ageppert/Core-64-Interactive-Core-Memory-Badge/Electronic Design/Core64 LB v0.9 KiCAD 8 WIP/Core64 LB.kicad_pcb

## KiCad design Electronic Design/Core64 LB v0.9 KiCAD 8 WIP/Core64 LB.kicad_pcb (2025-10-01)

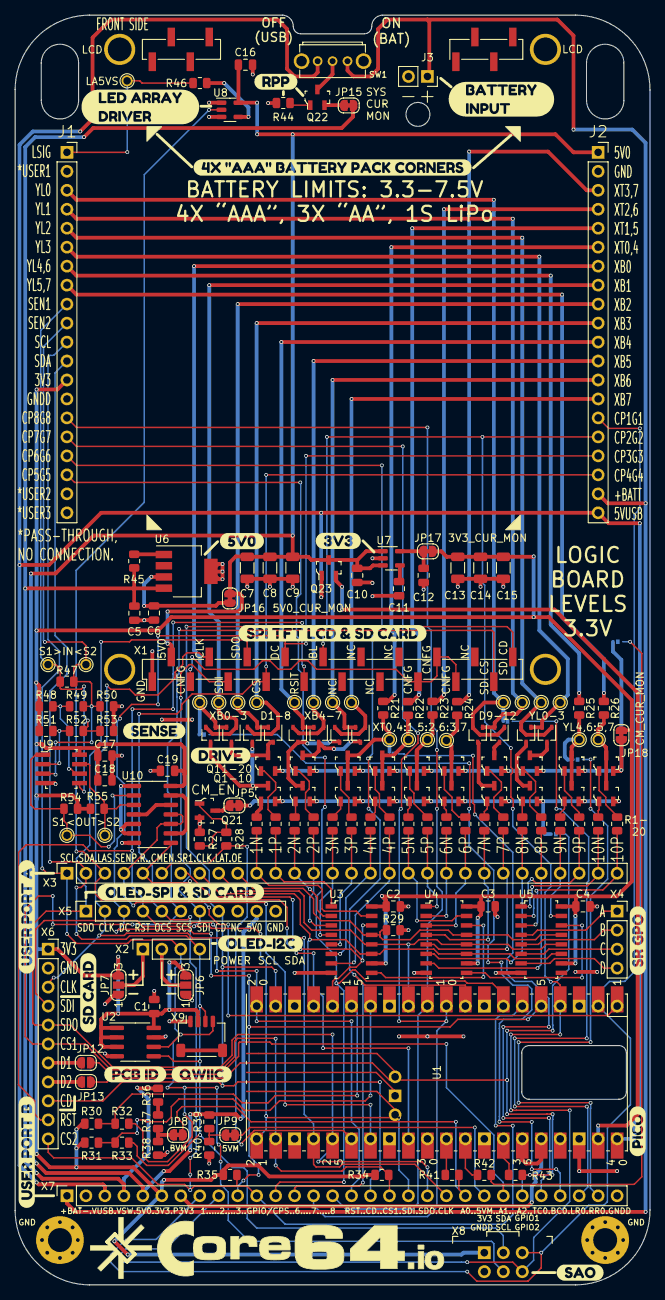
[picture p1: board Core64 LB.kicad_pcb from above]

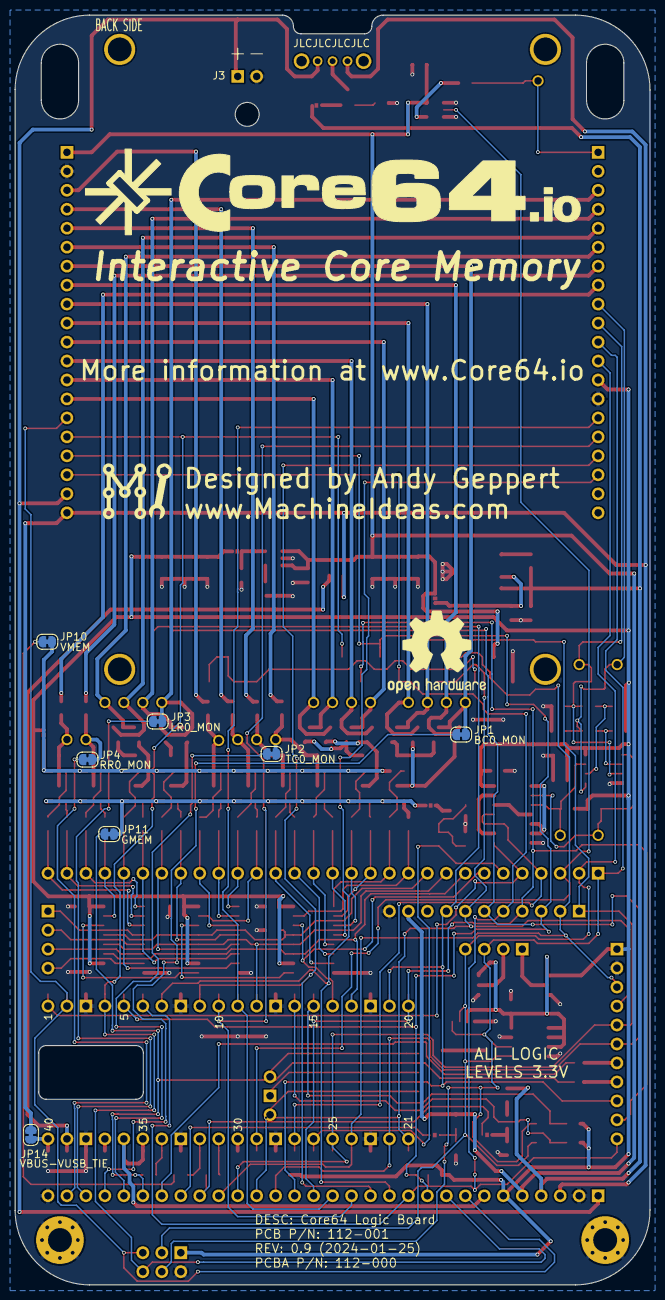
[picture p2: board Core64 LB.kicad_pcb from below]

Board: 2 copper layers, 85.0 x 170.0 mm, 198 parts (10 on the bottom side), 154 nets.

Parts:
C1, C2, C3, C4, C16, C17, C19: 0.1uF; C_0805_2012Metric
C5, C6, C10, C12: 1uF; C_0805_2012Metric
C7, C8, C9, C13, C14, C15: 220uF; C_1206_3216Metric
C11: 0.01uF; C_0805_2012Metric
C18: 10uF; C_0805_2012Metric
D1, D3, D5, D7, D9, D11: BAT54CW; SOT-323_SC-70
D2, D4, D6, D8, D10, D12: BAT54AW; SOT-323_SC-70
H1, H2: GND PAD; MountingHole_3.2mm_M3_Pad_Via
J1, J2: SSW-116-22-F-S-VS‎; PinSocket_1x20_P2.54mm_Vertical
J3: ALT. BATT.; PinSocket_1x02_P2.54mm_Vertical
JP1: BC0_MON; SolderJumper-2_P1.3mm_Bridged_RoundedPad1.0x1.5mm
JP2: TC0_MON; SolderJumper-2_P1.3mm_Bridged_RoundedPad1.0x1.5mm
JP3: LR0_MON; SolderJumper-2_P1.3mm_Bridged_RoundedPad1.0x1.5mm
JP4: RR0_MON; SolderJumper-2_P1.3mm_Bridged_RoundedPad1.0x1.5mm
JP5, JP11: GMEM; SolderJumper-2_P1.3mm_Bridged_RoundedPad1.0x1.5mm
JP6, JP7: SolderJumper_3_Open; SolderJumper-3_P1.3mm_Open_RoundedPad1.0x1.5mm_NumberLabels
JP8: BAT_MON; SolderJumper-2_P1.3mm_Bridged_RoundedPad1.0x1.5mm
JP9: 5V0_MON; SolderJumper-2_P1.3mm_Bridged_RoundedPad1.0x1.5mm
JP10: VMEM; SolderJumper-2_P1.3mm_Bridged_RoundedPad1.0x1.5mm
JP12: D1; SolderJumper-2_P1.3mm_Open_RoundedPad1.0x1.5mm
JP13: D2; SolderJumper-2_P1.3mm_Open_RoundedPad1.0x1.5mm
JP14: VBUS_VUSB_TIE; SolderJumper-2_P1.3mm_Bridged_RoundedPad1.0x1.5mm
JP15: SYS_CUR_MON; SolderJumper-2_P1.3mm_Bridged_RoundedPad1.0x1.5mm
JP16: 5V0_CUR_MON; SolderJumper-2_P1.3mm_Bridged_RoundedPad1.0x1.5mm
JP17: 3V3_CUR_MON; SolderJumper-2_P1.3mm_Bridged_RoundedPad1.0x1.5mm
JP18: CM_CUR_MON; SolderJumper-2_P1.3mm_Bridged_RoundedPad1.0x1.5mm
L1: Core_64_Logo; Core64.io_w_core_symbol
L1#2: Core_64_Logo; Machine_Ideas_logo_1
L2: Core_64_Logo; Core64.io_w_core_symbol2
L4: Logo_Open_Hardware_Small; OSHW-Logo2_14.6x12mm_SilkScreen
Q1, Q2, Q3, Q4, Q5, Q6, Q7, Q8, Q9, Q10: MMBT4401LT1G; SOT-23-3
Q11, Q12, Q13, Q14, Q15, Q16, Q17, Q18, Q19, Q20: MMBT4403LT1G; SOT-23-3
Q21: NVTR4503NT1G_NMOS_GSD; SOT-23-3
Q22, Q23: SL3401A; SOT-23-3
R1, R2, R3, R4, R5, R6, R7, R8, R9, R10, R11, R12, R13, R14, R15, R16, R17, R18, R19, R20, R28, R46: 470; R_0805_2012Metric
R21, R22, R23, R24, R25, R26: 6R8-5%; R_0805_2012Metric
R27, R29, R34, R35, R36, R37, R38, R39, R40, R44, R45: 10k; R_0805_2012Metric
R30, R31, R54, R55: 1K2; R_0805_2012Metric
R32, R33: 68; R_0805_2012Metric
R41, R42, R43: 1k2; R_0805_2012Metric
R47, R50, R53: 1K5-1%; R_0805_2012Metric
R48, R51: 1K8-1%; R_0805_2012Metric
R49, R52: 11-1%; R_0805_2012Metric
SW1: SK12D07L4B; SK12D07VG4
TP1: XB0; TestPoint_THTPad_D1.5mm_Drill1.0mm
TP2: XB1; TestPoint_THTPad_D1.5mm_Drill1.0mm
TP3: XB2; TestPoint_THTPad_D1.5mm_Drill1.0mm
TP4: XB3; TestPoint_THTPad_D1.5mm_Drill1.0mm
TP5: XB4; TestPoint_THTPad_D1.5mm_Drill1.0mm
TP6: XB5; TestPoint_THTPad_D1.5mm_Drill1.0mm
TP7: XB6; TestPoint_THTPad_D1.5mm_Drill1.0mm
TP8: XB7; TestPoint_THTPad_D1.5mm_Drill1.0mm
TP9: XT0,4; TestPoint_THTPad_D1.5mm_Drill1.0mm
TP10: XT1,5; TestPoint_THTPad_D1.5mm_Drill1.0mm
TP11: XT2,6; TestPoint_THTPad_D1.5mm_Drill1.0mm
TP12: XT3,7; TestPoint_THTPad_D1.5mm_Drill1.0mm
TP13: YL1; TestPoint_THTPad_D1.5mm_Drill1.0mm
TP14: YL0; TestPoint_THTPad_D1.5mm_Drill1.0mm
TP15: YL3; TestPoint_THTPad_D1.5mm_Drill1.0mm
TP16: YL2; TestPoint_THTPad_D1.5mm_Drill1.0mm
TP17: YL4,6; TestPoint_THTPad_D1.5mm_Drill1.0mm
TP18: YL5,7; TestPoint_THTPad_D1.5mm_Drill1.0mm
TP19: LA5VS; TestPoint_THTPad_D1.5mm_Drill1.0mm
TP20: S1 IN; TestPoint_THTPad_D1.5mm_Drill1.0mm
TP21: S2 IN; TestPoint_THTPad_D1.5mm_Drill1.0mm
TP22: S2 OUT; TestPoint_THTPad_D1.5mm_Drill1.0mm
TP23: S1 OUT; TestPoint_THTPad_D1.5mm_Drill1.0mm
U1: PICO; RPi_PicoW_SMD_TH_Abg
U2: M24C02-RMN; SOIC-8_3.9x4.9mm_P1.27mm
U3, U4, U5: 74HC595D; SOIC-16_W3.90mm
U6: LP38693MP-5.0; SOT-223-5
U7: SSP9193-33M5R; SOT-23-5
U8: SN74LV1T125DBVR; SOT-23-5
U9: LM393; SOIC-8_W3.9mm
U10: SN74HC02DR; SOIC-14_3.9x8.7mm_P1.27mm
X1: Adafruit_3.2_TFT_1743; Adafruit_3.2_TFT_Dual_PinHeader_1x20_P2.54mm_Vertical_SMD_P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
X2: SSW-104-22-L-S-VS; PinSocket_1x04_P2.54mm_Vertical
X3, X7: TBD; PinSocket_1x30_P2.54mm_Vertical
X4: CA_SR_GPO_ABCD; PinSocket_1x04_P2.54mm_Vertical
X5: HEADER_11-PIN_0.1; PinSocket_1x11_P2.54mm_Vertical
X6: Header_11-PIN_0.1; PinSocket_1x11_P2.54mm_Vertical
X8: SAO_conn_SFH11-NBPC-D03-ST-BK; Badgelife-SAOv169-BADGE-2x3
X9: QWIIC; JST_SH_SM04B-SRSS-TB_1x04-1MP_P1.00mm_Horizontal
kibuzzard-6417AF30: G***; kibuzzard-6417AF30
kibuzzard-6417CDFD: G***; kibuzzard-6417CDFD
kibuzzard-6417CE14: G***; kibuzzard-6417CE14
kibuzzard-64178C85: G***; kibuzzard-64178C85
kibuzzard-64178DD4: G***; kibuzzard-64178DD4
kibuzzard-64178DE8: G***; kibuzzard-64178DE8
kibuzzard-64178DF4: G***; kibuzzard-64178DF4
kibuzzard-64178E2E: G***; kibuzzard-64178E2E
kibuzzard-64178E4F: G***; kibuzzard-64178E4F
kibuzzard-64178E7C: G***; kibuzzard-64178E7C
kibuzzard-64178E9B: G***; kibuzzard-64178E9B
kibuzzard-64178E12: G***; kibuzzard-64178E12
kibuzzard-64178E45: G***; kibuzzard-64178E45
kibuzzard-64178E73: G***; kibuzzard-64178E73
kibuzzard-64178E92: G***; kibuzzard-64178E92
kibuzzard-64178EA5: G***; kibuzzard-64178EA5
kibuzzard-64179D69: G***; kibuzzard-64179D69
kibuzzard-64179D78: G***; kibuzzard-64179D78
kibuzzard-64179E5D: G***; kibuzzard-64179E5D

Connections:
3V3: C1.1, C2.1, C3.1, C4.1, C13.1, C14.1, C15.1, C17.1, C18.1, C19.1, J1.13, JP6.3 (B), JP7.3 (B), JP17.2 (B), JP18.1 (A), R30.1, R31.1, R34.1, R35.2, R48.1, R51.1, R54.1, R55.1, U2.1 (E0), U2.2 (E1), U2.3 (E2), U2.8 (VCC), U3.10 (~SRCLR), U3.16 (VCC), U4.10 (~SRCLR), U4.16 (VCC), U5.10 (~SRCLR), U5.16 (VCC), U9.8 (V+), U10.14 (VCC), X6.1, X7.6, X8.1 (3V3), X9.2
5V0: C7.1, C8.1, C9.1, C10.1, C16.1, J2.1, JP16.2 (B), Q23.3 (D), R39.1, U7.1 (IN), U7.3 (EN), U8.5 (VCC), X1.2 (3-5V), X5.10, X7.5
5VUSB: J2.20, JP14.2 (B), Q23.1 (G), SW1.3 (C), X7.3
+BATT: J2.19, J3.1, SW1.1 (A), X7.1
+VSW: C5.1, JP15.2 (B), R36.2, R45.1, U6.4 (IN), X7.4
-BATT: C1.2, C2.2, C3.2, C4.2, C5.2, C6.2, C7.2, C8.2, C9.2, C10.2, C11.2, C12.2, C13.2, C14.2, C15.2, C16.2, C17.2, C18.2, C19.2, H1.1, H2.1, J1.14, J2.2, J3.2, JP6.1 (A), JP7.1 (A), Q21.2 (S), R27.1, R29.1, R38.2, R40.2, R44.2, R50.2, R53.2, U1.3 (GND), U1.8 (GND), U1.13 (GND), U1.18 (GND), U1.23 (GND), U1.28 (GND), U1.33 (AGND/GND), U1.38 (GND), U2.4 (VSS), U2.7 (~WC), U3.8 (GND), U4.8 (GND), U5.8 (GND), U6.5 (GND), U7.2 (GND), U8.1 (/OE), U8.3 (GND), U9.4 (V-), U10.7 (GND), X1.1 (GND), X5.11, X6.2, X7.2, X7.30, X8.2 (GND), X9.1
/ADC0: R41.1, U1.31 (I2C1_SDA/ADC0/GP26)
/ADC0_BUFF: JP8.2 (B), R41.2, X7.22
/ADC1: R42.1, U1.32 (I2C1_SCL/ADC1/GP27)
/ADC1_BUFF: JP10.1 (A), JP12.2 (B), R42.2, X7.24
/ADC2: R43.1, U1.34 (ADC2/GP28)
/ADC2_BUFF: JP11.1 (A), JP13.2 (B), R43.2, X7.25
/CA_SENSE_1_OUT: R55.2, TP23.1, U9.7, U10.3
/CA_SENSE_2_OUT: R54.2, TP22.1, U9.1, U10.2
/CA_SR_GPO_A: U5.4 (QE), X4.1
/CA_SR_GPO_B: U5.5 (QF), X4.2
/CA_SR_GPO_C: U5.6 (QG), X4.3
/CA_SR_GPO_D: U5.7 (QH), X4.4
/CA_SR_SER2: U3.9 (QH'), U4.14 (SER)
/CA_SR_SER3: U4.9 (QH'), U5.14 (SER)
/CM_EN: R28.1, U1.26 (I2C0_SDA/GP20), X3.6
/CM_Q1N: R1.2, U3.15 (QA), X3.11
/CM_Q1P: R2.2, U3.1 (QB), X3.12
/CM_Q2N: R3.2, U3.2 (QC), X3.13
/CM_Q2P: R4.2, U3.3 (QD), X3.14
/CM_Q3N: R5.2, U3.4 (QE), X3.15
/CM_Q3P: R6.2, U3.5 (QF), X3.16
/CM_Q4N: R7.2, U3.6 (QG), X3.17
/CM_Q4P: R8.2, U3.7 (QH), X3.18
/CM_Q5N: R9.2, U4.15 (QA), X3.19
/CM_Q5P: R10.2, U4.1 (QB), X3.20
/CM_Q6N: R11.2, U4.2 (QC), X3.21
/CM_Q6P: R12.2, U4.3 (QD), X3.22
/CM_Q7N: R13.2, U4.4 (QE), X3.23
/CM_Q7P: R14.2, U4.5 (QF), X3.24
/CM_Q8N: R15.2, U4.6 (QG), X3.25
/CM_Q8P: R16.2, U4.7 (QH), X3.26
/CM_Q9N: R17.2, U5.15 (QA), X3.27
/CM_Q9P: R18.2, U5.1 (QB), X3.28
/CM_Q10N: R19.2, U5.2 (QC), X3.29
/CM_Q10P: R20.2, U5.3 (QD), X3.30
/CM_SENSE_1_IN: J1.9, R47.1, R52.2, R53.1, TP20.1, U9.5 (+)
/CM_SENSE_2_IN: J1.10, R47.2, R49.2, R50.1, TP21.1, U9.3 (+)
/CM_SENSE_PULSE: U1.27 (I2C0_SCL/GP21), U10.10, U10.11, X3.4
/CM_SENSE_RESET: U1.1 (UART0_TX/I2C0_SDA/SPI0_RX/GP0), U10.8, X3.5
/CM_SR_CLK: U1.17 (UART0_RX/I2C0_SCL/SPI1_CSn/GP13), U3.11 (SRCLK), U4.11 (SRCLK), U5.11 (SRCLK), X3.8
/CM_SR_LAT: U1.12 (UART1_RX/I2C0_SCL/SPI1_CSn/GP9), U3.12 (RCLK), U4.12 (RCLK), U5.12 (RCLK), X3.9
/CM_SR_SER1: U1.16 (UART0_TX/I2C0_SDA/GPI1_RX/GP12), U3.14 (SER), X3.7
/CM_SR_~OE: R29.2, U3.13 (~OE), U4.13 (~OE), U5.13 (~OE), X3.10
/GPIO1_CP1_SAO1: J2.15, U1.2 (UART0_RX/I2C0_SCL/GPI0_CSn/GP1), X7.8, X8.5 (GPIO1)
/GPIO2_CP2_SAO2: J2.16, U1.4 (I2C1_SDA/SPI0_SCK/GP2), X1.10 (LITE), X7.9, X8.6 (GPIO2)
/GPIO3_CP3_DC: J2.17, U1.5 (I2C1_SCL/SPI0_TX/GP3), X1.8 (D/C), X5.3, X7.10
/GPIO4_CP4_CS2: J2.18, R35.1, U1.6 (UART1_TX/I2C0_SDA/SPI0_RX/GP4), X1.7 (CS), X5.5, X6.11, X7.11
/GPIO5_CP5_HS1: J1.18, U1.7 (UART1_RX/I2C0_SCL/SPI0_CSn/GP5), X7.12
/GPIO6_CP6_HS2: J1.17, U1.9 (I2C1_SDA/SPI0_SCK/GP6), X7.13
/GPIO7_CP7_HS3: J1.16, U1.10 (I2C1_SCL/SPI0_TX/GP7), X7.14
/GPIO8_CP8_HS4: J1.15, U1.11 (UART1_TX/I2C0_SDA/SPI1_RX/GP8), X7.15
/I2C_3V3_SCL: J1.11, R32.2, U2.6 (SCL), X2.3, X3.1, X8.4 (SCL), X9.4
/I2C_3V3_SDA: J1.12, R33.1, U2.5 (SDA), X2.4, X3.2, X8.3 (SDA), X9.3
/I2C_CLOCK: R30.2, R32.1, U1.15 (I2C1_SCL/SPI1_TX/GP11)
/I2C_DATA: R31.2, R33.2, U1.14 (I2C1_SDA/SPI1_SCK/GP10)
/LED_ARY_3V3_SIG: U1.29 (GP22), U8.2 (A), X3.3
/LED_ARY_5V0_SIG: J1.1, R46.1, TP19.1
/QSPI_D1: JP12.1 (A), X6.7
/QSPI_D2: JP13.1 (A), X6.8
/SPI_CD: U1.19 (I2C1_SDA/SPI1_SCK/GP14), X1.20 (Card_Det.), X5.8, X6.9, X7.17
/SPI_CLK: U1.24 (I2C1_SDA/SPI0_SCK/GP18), X1.4 (CLK), X5.2, X6.3, X7.21
/SPI_CS1: R34.2, U1.22 (UART0_RX/I2C0_SCL/SPI0_CSn/GP17), X1.19 (Card_CS), X5.6, X6.6, X7.18
/SPI_RESET: U1.20 (I2C1_SCL/SPI1_TX/GP15), X1.9 (RST), X5.4, X6.10, X7.16
/SPI_SDI: U1.21 (UART0_TX/I2C0_SDA/SPI0_RX/GP16), X1.5 (MISO), X5.7, X6.4, X7.19
/SPI_SDO: U1.25 (I2C1_SCL/SPI0_TX/GP19), X1.6 (MOSI), X5.1, X6.5, X7.20
/XB0: D1.1, D2.2, J2.7, JP1.2 (B), TP1.1
/XB1: D1.2, D2.1, J2.8, TP2.1
/XB2: D3.1, D4.2, J2.9, TP3.1
/XB3: D3.2, D4.1, J2.10, TP4.1
/XB4: D5.1, D6.2, J2.11, TP5.1
/XB5: D5.2, D6.1, J2.12, TP6.1
/XB6: D7.1, D8.2, J2.13, TP7.1
/XB7: D7.2, D8.1, J2.14, TP8.1
/XT0,4: J2.6, R21.2
/XT1,5: J2.5, R22.1
/XT2,6: J2.4, R23.1
/XT3,7: J2.3, R24.1
/YL0: D9.2, D10.1, J1.3, JP3.2 (B), TP14.1
/YL1: D9.1, D10.2, J1.4, TP13.1
/YL2: D11.2, D12.1, J1.5, TP16.1
/YL3: D11.1, D12.2, J1.6, TP15.1
/YL4,6: J1.7, R25.1
/YL5,7: J1.8, R26.1
BC0_MON: JP1.1 (A), X7.27
GMEM: JP5.2 (B), JP11.2 (B), Q1.2 (E), Q2.2 (E), Q3.2 (E), Q4.2 (E), Q5.2 (E), Q6.2 (E), Q7.2 (E), Q8.2 (E), Q9.2 (E), Q10.2 (E)
LR0_MON: JP3.1 (A), X7.28
unnamed: JP2.2 (B), Q3.3 (C), Q13.3 (C), R21.1, TP9.1
unnamed: JP4.2 (B), Q9.3 (C), Q19.3 (C), R25.2, TP17.1
unnamed: JP5.1 (A), Q21.3 (D)
unnamed: JP6.2 (C), X2.2
unnamed: JP7.2 (C), X2.1
unnamed: JP8.1 (A), R37.1, R38.1
unnamed: JP9.1 (A), X7.23
unnamed: JP9.2 (B), R39.2, R40.1
unnamed: JP15.1 (A), Q22.2 (S)
unnamed: C6.1, JP16.1 (A), U6.3 (VOUT)
unnamed: C12.1, JP17.1 (A), U7.5 (OUT)
unnamed: Q1.1 (B), R1.1
unnamed: D1.3, D3.3, Q1.3 (C)
unnamed: Q2.1 (B), R3.1
unnamed: D5.3, D7.3, Q2.3 (C)
unnamed: Q3.1 (B), R5.1
unnamed: Q4.1 (B), R7.1
unnamed: Q5.1 (B), R9.1
unnamed: Q6.1 (B), R11.1
unnamed: Q7.1 (B), R13.1
unnamed: D9.3, Q7.3 (C)
unnamed: Q8.1 (B), R15.1
unnamed: D11.3, Q8.3 (C)
unnamed: Q9.1 (B), R17.1
unnamed: Q10.1 (B), R19.1
unnamed: Q10.3 (C), Q20.3 (C), R26.2, TP18.1
unnamed: Q11.1 (B), R2.1
unnamed: D2.3, D4.3, Q11.3 (C)
unnamed: Q12.1 (B), R4.1
unnamed: D6.3, D8.3, Q12.3 (C)
unnamed: Q13.1 (B), R6.1
unnamed: Q14.1 (B), R8.1
unnamed: Q4.3 (C), Q14.3 (C), R22.2, TP10.1
unnamed: Q15.1 (B), R10.1
unnamed: Q5.3 (C), Q15.3 (C), R23.2, TP11.1
unnamed: Q16.1 (B), R12.1
unnamed: Q6.3 (C), Q16.3 (C), R24.2, TP12.1
unnamed: Q17.1 (B), R14.1
unnamed: D10.3, Q17.3 (C)
unnamed: Q18.1 (B), R16.1
unnamed: D12.3, Q18.3 (C)
unnamed: Q19.1 (B), R18.1
unnamed: Q20.1 (B), R20.1
unnamed: Q21.1 (G), R27.2, R28.2
unnamed: Q22.3 (D), SW1.2 (B)
unnamed: Q22.1 (G), R44.1
unnamed: R36.1, R37.2
unnamed: R45.2, U6.1 (EN)
unnamed: C11.1, U7.4 (BP)
unnamed: R46.2, U8.4 (Y)
unnamed: R51.2, R52.1, U9.2 (-)
unnamed: R48.2, R49.1, U9.6 (_)
unnamed: U10.1, U10.5, U10.6
unnamed: U10.4, U10.12
unnamed: U10.9, U10.13
unnamed: X1.3 (3.3V), X1.15 (IM3), X1.16 (IM2), X1.17 (IM1)
PICO_3V3OUT: U1.35 (ADC_VREF), U1.36 (3V3OUT), X7.7
PICO_VBUS: JP14.1 (A), U1.40 (VBUS)
PICO_VSYS: Q23.2 (S), U1.39 (VSYS)
RR0_MON: JP4.1 (A), X7.29
TC0_MON: JP2.1 (A), X7.26
VMEM: JP10.2 (B), JP18.2 (B), Q11.2 (E), Q12.2 (E), Q13.2 (E), Q14.2 (E), Q15.2 (E), Q16.2 (E), Q17.2 (E), Q18.2 (E), Q19.2 (E), Q20.2 (E)
