ageppert/Core-64-Interactive-Core-Memory-Badge/Electronic Design/Core64 CB v1.1/Core64 CB.kicad_pcb

## KiCad design Electronic Design/Core64 CB v1.1/Core64 CB.kicad_pcb (2025-01-02)

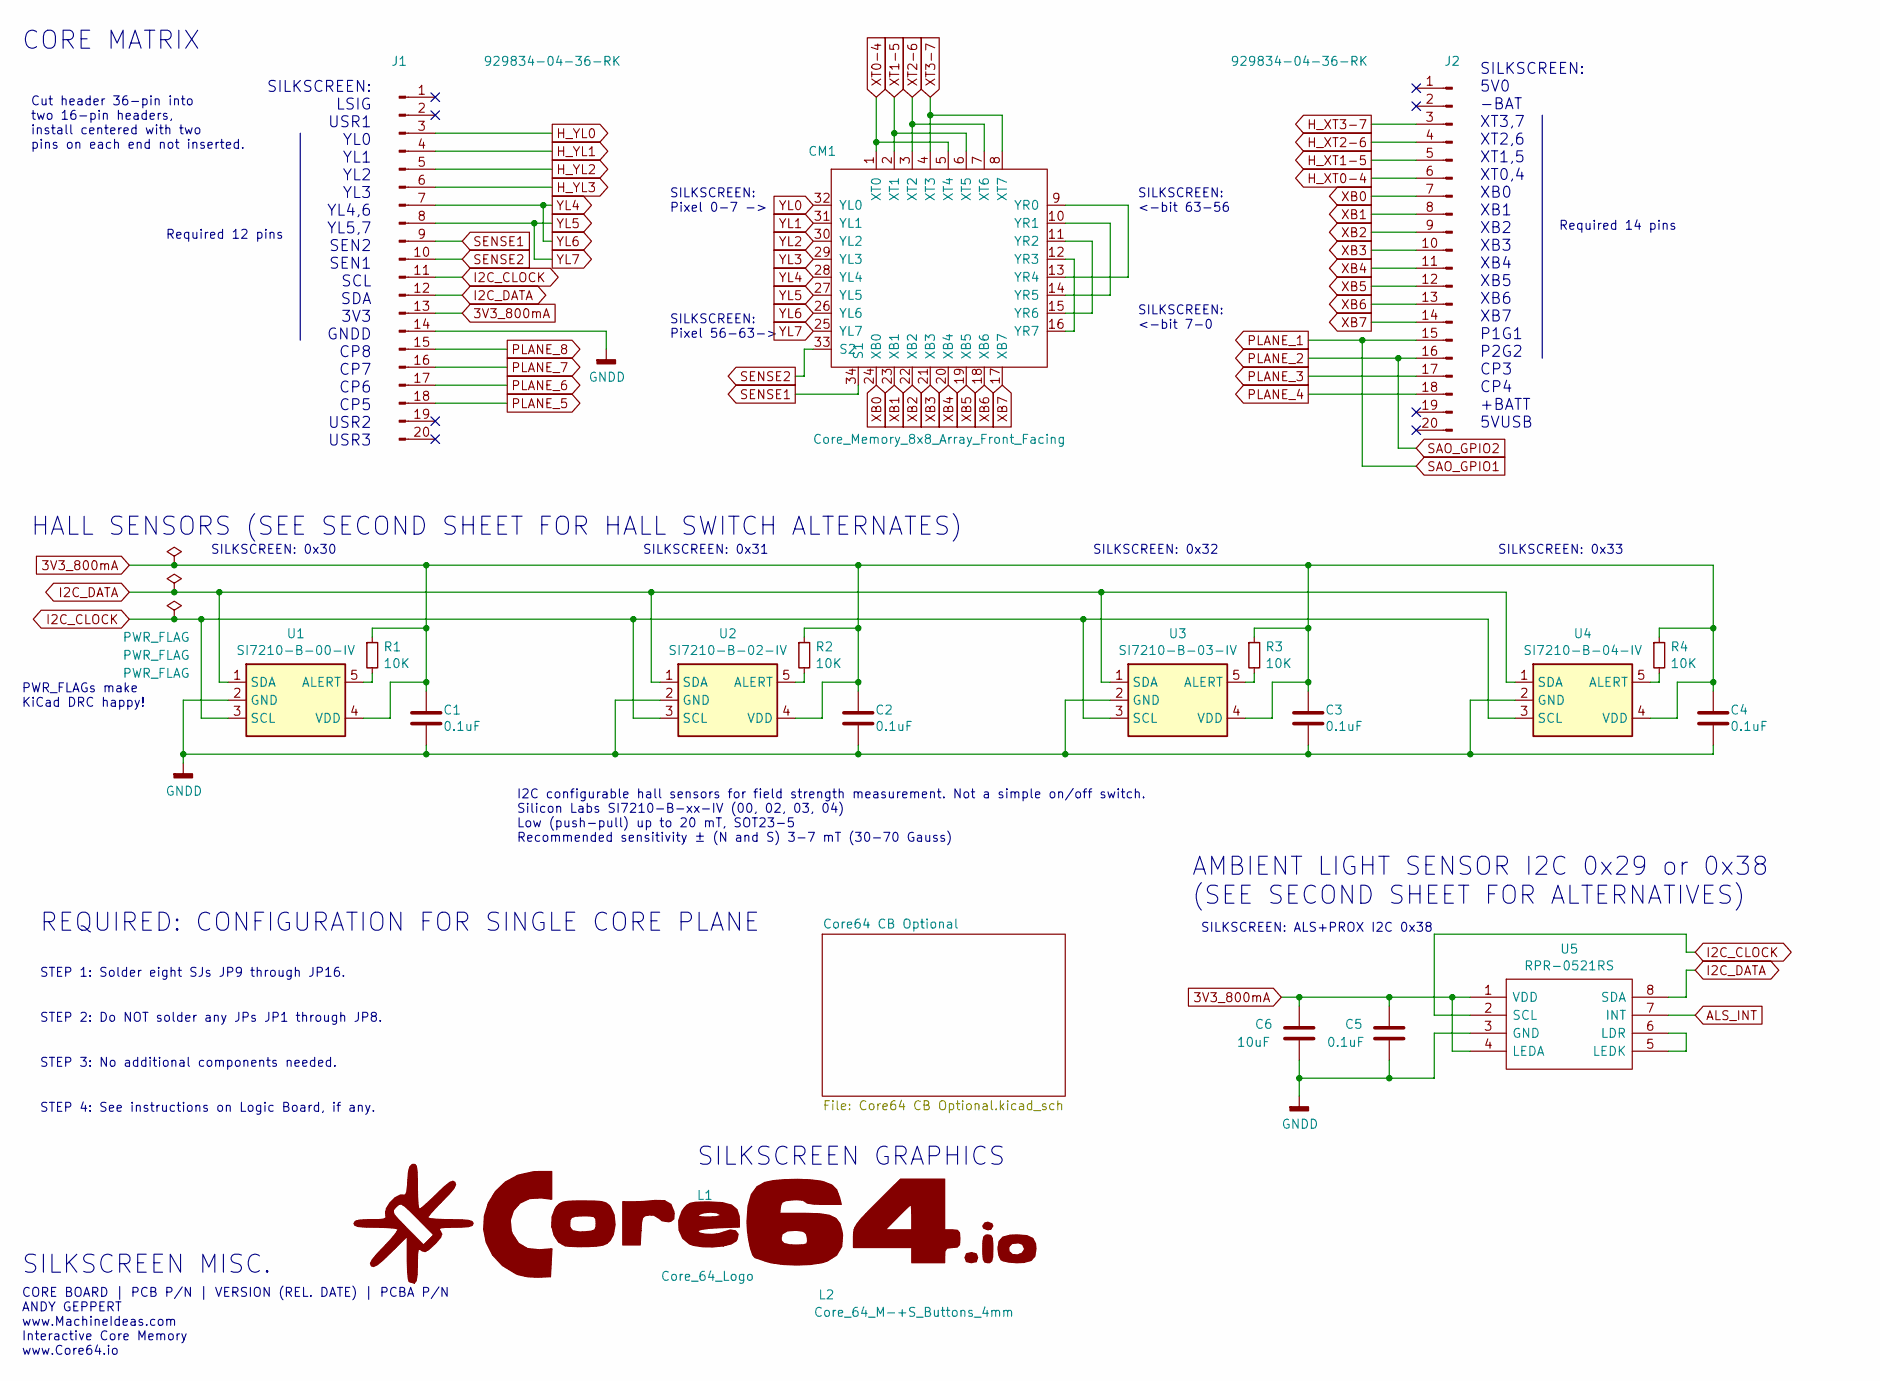
[picture p3: schematic Core64 CB.kicad_sch, Core64 CB (Core Board)]

Parts:
C1, C2, C3, C4, C5: 0.1uF; C_0805_2012Metric; LCSC C396718
C6: 10uF; C_0805_2012Metric; LCSC C396718
CM1: Core_Memory_8x8_Array_Front_Facing; core_64_6.75mm_square_v0.5_front_facing
J1, J2: 929834-04-36-RK; PinHeader_1x20_P2.54mm_Vertical_SMD_and_TH_Pin1Right; Mfg P/N 929834-04-36-RK
L1: Core_64_Logo; Core64.io_w_core_symbol_9mm_tall
L2: Core_64_M-+S_Buttons_4mm; Core64-M_-_+_S_Buttons
R1, R2, R3, R4: 10K; R_0805_2012Metric; LCSC C269724
U1: SI7210-B-00-IV; SOT-23-5; Mfg P/N SI7210-B-00-IV
U2: SI7210-B-02-IV; SOT-23-5; Mfg P/N SI7210-B-02-IV
U3: SI7210-B-03-IV; SOT-23-5; Mfg P/N SI7210-B-03-IV
U4: SI7210-B-04-IV; SOT-23-5; Mfg P/N SI7210-B-04-IV
U5: RPR-0521RS; RPR0521RS; Manufacturer_Part_Number RPR-0521RS; Mouser Part Number 755-RPR-0521RS

Connections:
3V3_800mA: C1.1, C2.1, C3.1, C4.1, C5.1, C6.1, J1.13, R1.1, R2.1, R3.1, R4.1, U1.4 (VDD), U2.4 (VDD), U3.4 (VDD), U4.4 (VDD), U5.1 (VDD), U5.4 (LEDA); also elsewhere on the board
ALS_INT: U5.7 (INT); also elsewhere on the board
GNDD: C1.2, C2.2, C3.2, C4.2, C5.2, C6.2, J1.14, U1.2 (GND), U2.2 (GND), U3.2 (GND), U4.2 (GND), U5.3 (GND); also elsewhere on the board
H_XT0-4: J2.6; also elsewhere on the board
H_XT1-5: J2.5; also elsewhere on the board
H_XT2-6: J2.4; also elsewhere on the board
H_XT3-7: J2.3; also elsewhere on the board
H_YL0: J1.3; also elsewhere on the board
H_YL1: J1.4; also elsewhere on the board
H_YL2: J1.5; also elsewhere on the board
H_YL3: J1.6; also elsewhere on the board
I2C_CLOCK: J1.11, U1.3 (SCL), U2.3 (SCL), U3.3 (SCL), U4.3 (SCL), U5.2 (SCL); also elsewhere on the board
I2C_DATA: J1.12, U1.1 (SDA), U2.1 (SDA), U3.1 (SDA), U4.1 (SDA), U5.8 (SDA); also elsewhere on the board
unnamed: CM1.9 (YR0), CM1.13 (YR4)
unnamed: CM1.10 (YR1), CM1.14 (YR5)
unnamed: CM1.11 (YR2), CM1.15 (YR6)
unnamed: CM1.12 (YR3), CM1.16 (YR7)
unnamed: R1.2, U1.5 (ALERT)
unnamed: R2.2, U2.5 (ALERT)
unnamed: R3.2, U3.5 (ALERT)
unnamed: R4.2, U4.5 (ALERT)
unnamed: U5.5 (LEDK), U5.6 (LDR)
PLANE_1: J2.15; also elsewhere on the board
PLANE_2: J2.16; also elsewhere on the board
PLANE_3: J2.17; also elsewhere on the board
PLANE_4: J2.18; also elsewhere on the board
PLANE_5: J1.18; also elsewhere on the board
PLANE_6: J1.17; also elsewhere on the board
PLANE_7: J1.16; also elsewhere on the board
PLANE_8: J1.15; also elsewhere on the board
SENSE1: CM1.34 (S1), J1.9
SENSE2: CM1.33 (S2), J1.10
XB0: CM1.24 (XB0), J2.7
XB1: CM1.23 (XB1), J2.8
XB2: CM1.22 (XB2), J2.9
XB3: CM1.21 (XB3), J2.10
XB4: CM1.20 (XB4), J2.11
XB5: CM1.19 (XB5), J2.12
XB6: CM1.18 (XB6), J2.13
XB7: CM1.17 (XB7), J2.14
XT0-4: CM1.1 (XT0), CM1.5 (XT4); also elsewhere on the board
XT1-5: CM1.2 (XT1), CM1.6 (XT5); also elsewhere on the board
XT2-6: CM1.3 (XT2), CM1.7 (XT6); also elsewhere on the board
XT3-7: CM1.4 (XT3), CM1.8 (XT7); also elsewhere on the board
YL0: CM1.32 (YL0); also elsewhere on the board
YL1: CM1.31 (YL1); also elsewhere on the board
YL2: CM1.30 (YL2); also elsewhere on the board
YL3: CM1.29 (YL3); also elsewhere on the board
YL4: CM1.26 (YL6), CM1.28 (YL4), J1.7
YL5: CM1.25 (YL7), CM1.27 (YL5), J1.8

Notes on the sheet:
SILKSCREEN MISC.
SILKSCREEN: 0x33
SILKSCREEN: <-bit 7-0
AMBIENT LIGHT SENSOR I2C 0x29 or 0x38 (SEE SECOND SHEET FOR ALTERNATIVES)
SILKSCREEN: ALS+PROX I2C 0x38
SILKSCREEN GRAPHICS
REQUIRED: CONFIGURATION FOR SINGLE CORE PLANE
SILKSCREEN: <-bit 63-56
PWR_FLAGs make KiCad DRC happy!
STEP 4: See instructions on Logic Board, if any.
SILKSCREEN: Pixel 0-7 ->
Cut header 36-pin into two 16-pin headers, install centered with two pins on each end not inserted.
SILKSCREEN: LSIG USR1 YL0 YL1 YL2 YL3 YL4,6 YL5,7 SEN2 SEN1 SCL SDA 3V3 GNDD CP8 CP7 CP6 CP5 USR2 USR3
SILKSCREEN: Pixel 56-63->
STEP 1: Solder eight SJs JP9 through JP16.
I2C configurable hall sensors for field strength measurement. Not a simple on/off switch. Silicon Labs SI7210-B-xx-IV (00, 02, 03, 04) Low (push-pull) up to 20 mT, SOT23-5 Recommended sensitivity ± (N and S) 3-7 mT (30-70 Gauss)
SILKSCREEN: 5V0 -BAT XT3,7 XT2,6 XT1,5 XT0,4 XB0 XB1 XB2 XB3 XB4 XB5 XB6 XB7 P1G1 P2G2 CP3 CP4 +BATT 5VUSB
CORE MATRIX
HALL SENSORS (SEE SECOND SHEET FOR HALL SWITCH ALTERNATES)
Required 12 pins
SILKSCREEN: 0x32
STEP 2: Do NOT solder any JPs JP1 through JP8.
SILKSCREEN: 0x30
CORE BOARD | PCB P/N | VERSION (REL. DATE) | PCBA P/N ANDY GEPPERT www.MachineIdeas.com Interactive Core Memory www.Core64.io
SILKSCREEN: 0x31
STEP 3: No additional components needed.
Required 14 pins

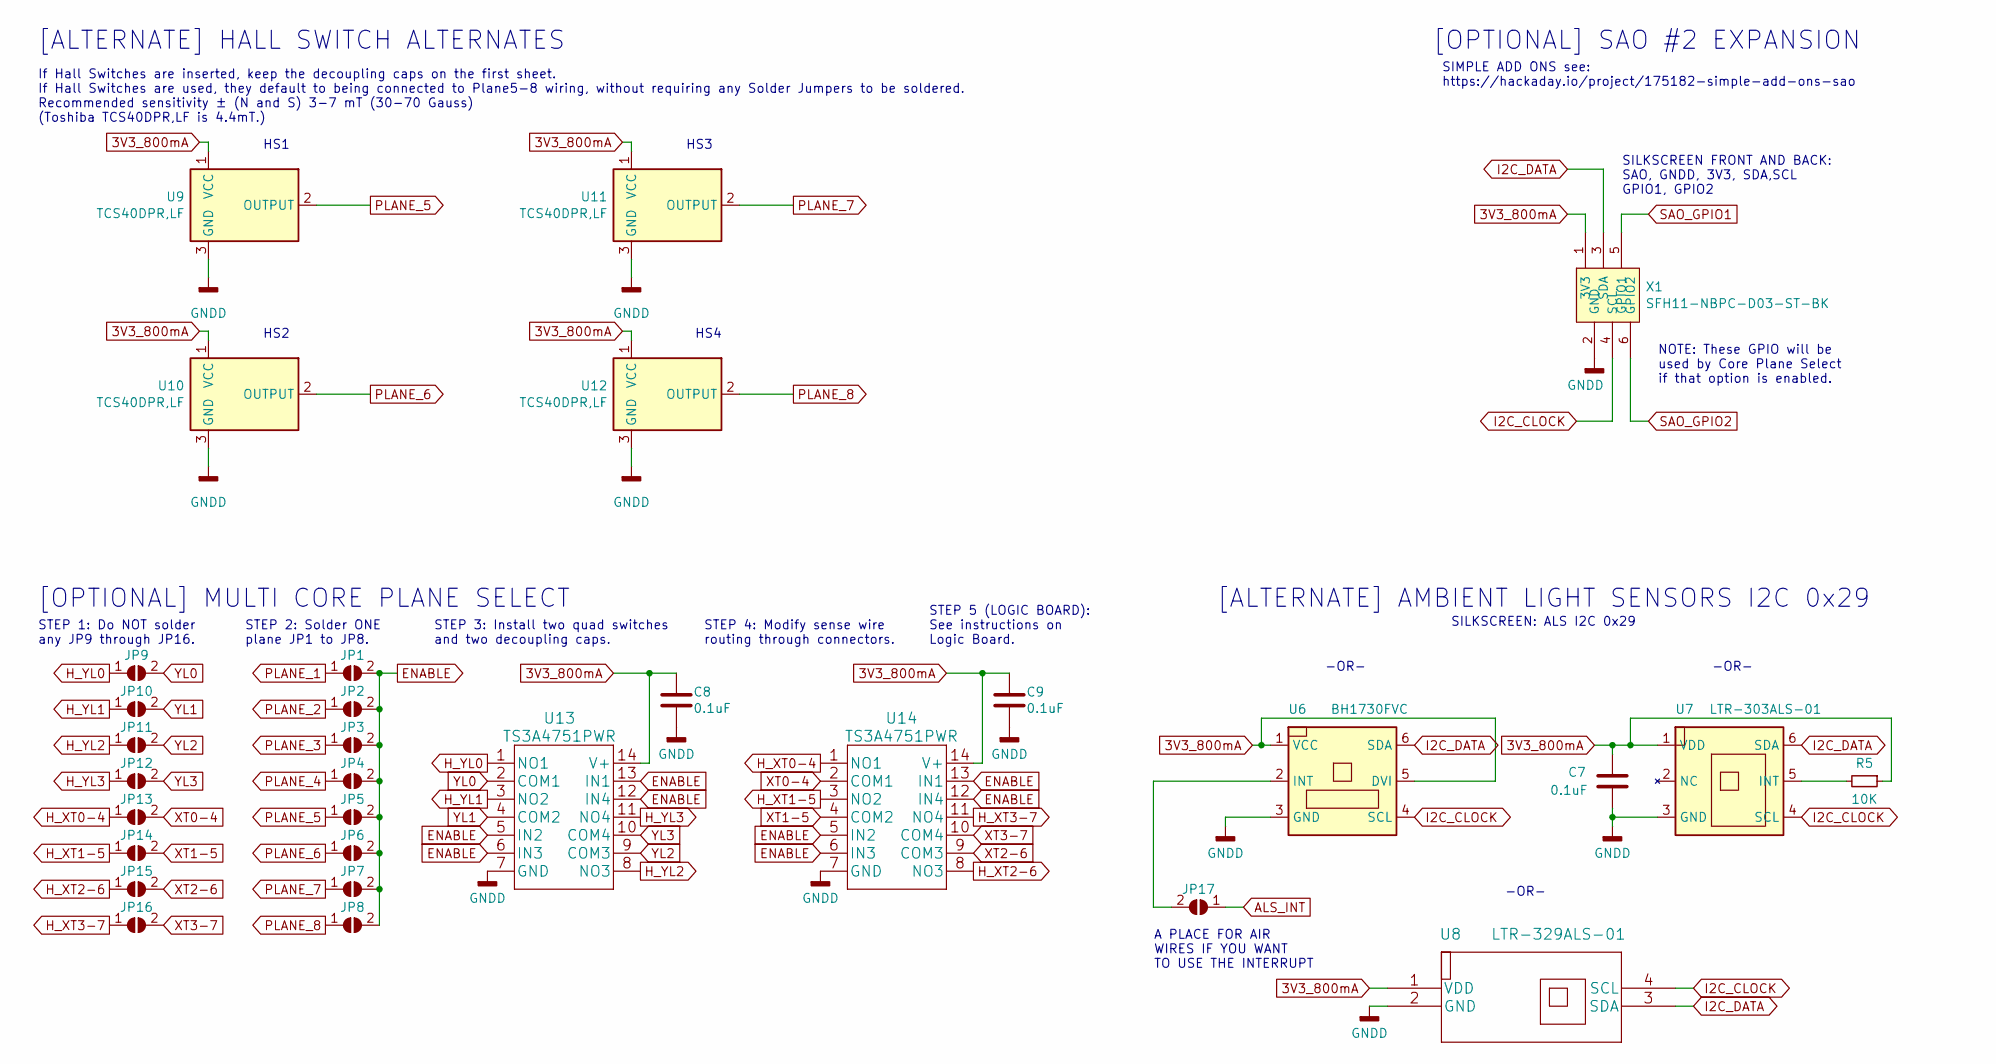
[picture p4: schematic Core64 CB Optional.kicad_sch, Core64 CB (Core Board)]

Parts:
C7, C8, C9: 0.1uF; C_0805_2012Metric
JP1, JP2, JP3, JP4, JP5, JP6, JP7, JP8, JP9, JP10, JP11, JP12, JP13, JP14, JP15, JP16, JP17: SolderJumper_2_Open; SolderJumper-2_P1.3mm_Open_Pad1.0x1.5mm
R5: 10K; R_0805_2012Metric; LCSC C269724
U6: BH1730FVC; REG_BD00IC0WHFV-GTR; Mfg P/N BH1730FVC-TR
U7: LTR-303ALS-01; Lite-On_LTR-303ALS-01; Mfg P/N LTR-303ALS-01; LCSC C364577
U8: LTR-329ALS-01; Mfg P/N LTR-329ALS-01
U9, U10, U11, U12: TCS40DPR,LF; SOT-23
U13, U14: TS3A4751PWR; Mfg P/N TS3A4751PWR
X1: SFH11-NBPC-D03-ST-BK; Badgelife-SAOv169-BADGE-2x3

Connections:
3V3_800mA: C7.1, C8.1, C9.1, R5.1, U6.1 (VCC), U6.5 (DVI), U7.1 (VDD), U8.1 (VDD), U9.1 (VCC), U10.1 (VCC), U11.1 (VCC), U12.1 (VCC), U13.14 (V+), U14.14 (V+), X1.1 (3V3); also elsewhere on the board
ALS_INT: JP17.1 (A); also elsewhere on the board
ENABLE: JP1.2 (B), JP2.2 (B), JP3.2 (B), JP4.2 (B), JP5.2 (B), JP6.2 (B), JP7.2 (B), JP8.2 (B), U13.5 (IN2), U13.6 (IN3), U13.12 (IN4), U13.13 (IN1), U14.5 (IN2), U14.6 (IN3), U14.12 (IN4), U14.13 (IN1)
GNDD: C7.2, C8.2, C9.2, U6.3 (GND), U7.3 (GND), U8.2 (GND), U9.3 (GND), U10.3 (GND), U11.3 (GND), U12.3 (GND), U13.7 (GND), U14.7 (GND), X1.2 (GND); also elsewhere on the board
H_XT0-4: JP13.1 (A), U14.1 (NO1); also elsewhere on the board
H_XT1-5: JP14.1 (A), U14.3 (NO2); also elsewhere on the board
H_XT2-6: JP15.1 (A), U14.8 (NO3); also elsewhere on the board
H_XT3-7: JP16.1 (A), U14.11 (NO4); also elsewhere on the board
H_YL0: JP9.1 (A), U13.1 (NO1); also elsewhere on the board
H_YL1: JP10.1 (A), U13.3 (NO2); also elsewhere on the board
H_YL2: JP11.1 (A), U13.8 (NO3); also elsewhere on the board
H_YL3: JP12.1 (A), U13.11 (NO4); also elsewhere on the board
I2C_CLOCK: U6.4 (SCL), U7.4 (SCL), U8.4 (SCL), X1.4 (SCL); also elsewhere on the board
I2C_DATA: U6.6 (SDA), U7.6 (SDA), U8.3 (SDA), X1.3 (SDA); also elsewhere on the board
unnamed: JP17.2 (B), U6.2 (INT)
unnamed: R5.2, U7.5 (INT)
PLANE_1: JP1.1 (A), X1.5 (GPIO1); also elsewhere on the board
PLANE_2: JP2.1 (A), X1.6 (GPIO2); also elsewhere on the board
PLANE_3: JP3.1 (A); also elsewhere on the board
PLANE_4: JP4.1 (A); also elsewhere on the board
PLANE_5: JP5.1 (A), U9.2 (OUTPUT); also elsewhere on the board
PLANE_6: JP6.1 (A), U10.2 (OUTPUT); also elsewhere on the board
PLANE_7: JP7.1 (A), U11.2 (OUTPUT); also elsewhere on the board
PLANE_8: JP8.1 (A), U12.2 (OUTPUT); also elsewhere on the board
XT0-4: JP13.2 (B), U14.2 (COM1); also elsewhere on the board
XT1-5: JP14.2 (B), U14.4 (COM2); also elsewhere on the board
XT2-6: JP15.2 (B), U14.9 (COM3); also elsewhere on the board
XT3-7: JP16.2 (B), U14.10 (COM4); also elsewhere on the board
YL0: JP9.2 (B), U13.2 (COM1); also elsewhere on the board
YL1: JP10.2 (B), U13.4 (COM2); also elsewhere on the board
YL2: JP11.2 (B), U13.9 (COM3); also elsewhere on the board
YL3: JP12.2 (B), U13.10 (COM4); also elsewhere on the board

Notes on the sheet:
HS4
SIMPLE ADD ONS see: https://hackaday.io/project/175182-simple-add-ons-sao
HS2
STEP 3: Install two quad switches and two decoupling caps.
STEP 5 (LOGIC BOARD): See instructions on Logic Board.
SILKSCREEN FRONT AND BACK: SAO, GNDD, 3V3, SDA,SCL GPIO1, GPIO2
NOTE: These GPIO will be used by Core Plane Select if that option is enabled.
[ALTERNATE] AMBIENT LIGHT SENSORS I2C 0x29
-OR-
[OPTIONAL] SAO #2 EXPANSION
If Hall Switches are inserted, keep the decoupling caps on the first sheet. If Hall Switches are used, they default to being connected to Plane5-8 wiring, without requiring any Solder Jumpers to be soldered. Recommended sensitivity ± (N and S) 3-7 mT (30-70 Gauss) (Toshiba TCS40DPR,LF is 4.4mT.)
HS1
STEP 4: Modify sense wire routing through connectors.
A PLACE FOR AIR WIRES IF YOU WANT TO USE THE INTERRUPT
HS3
STEP 1: Do NOT solder any JP9 through JP16.
STEP 2: Solder ONE plane JP1 to JP8.
[OPTIONAL] MULTI CORE PLANE SELECT
SILKSCREEN: ALS I2C 0x29
[ALTERNATE] HALL SWITCH ALTERNATES

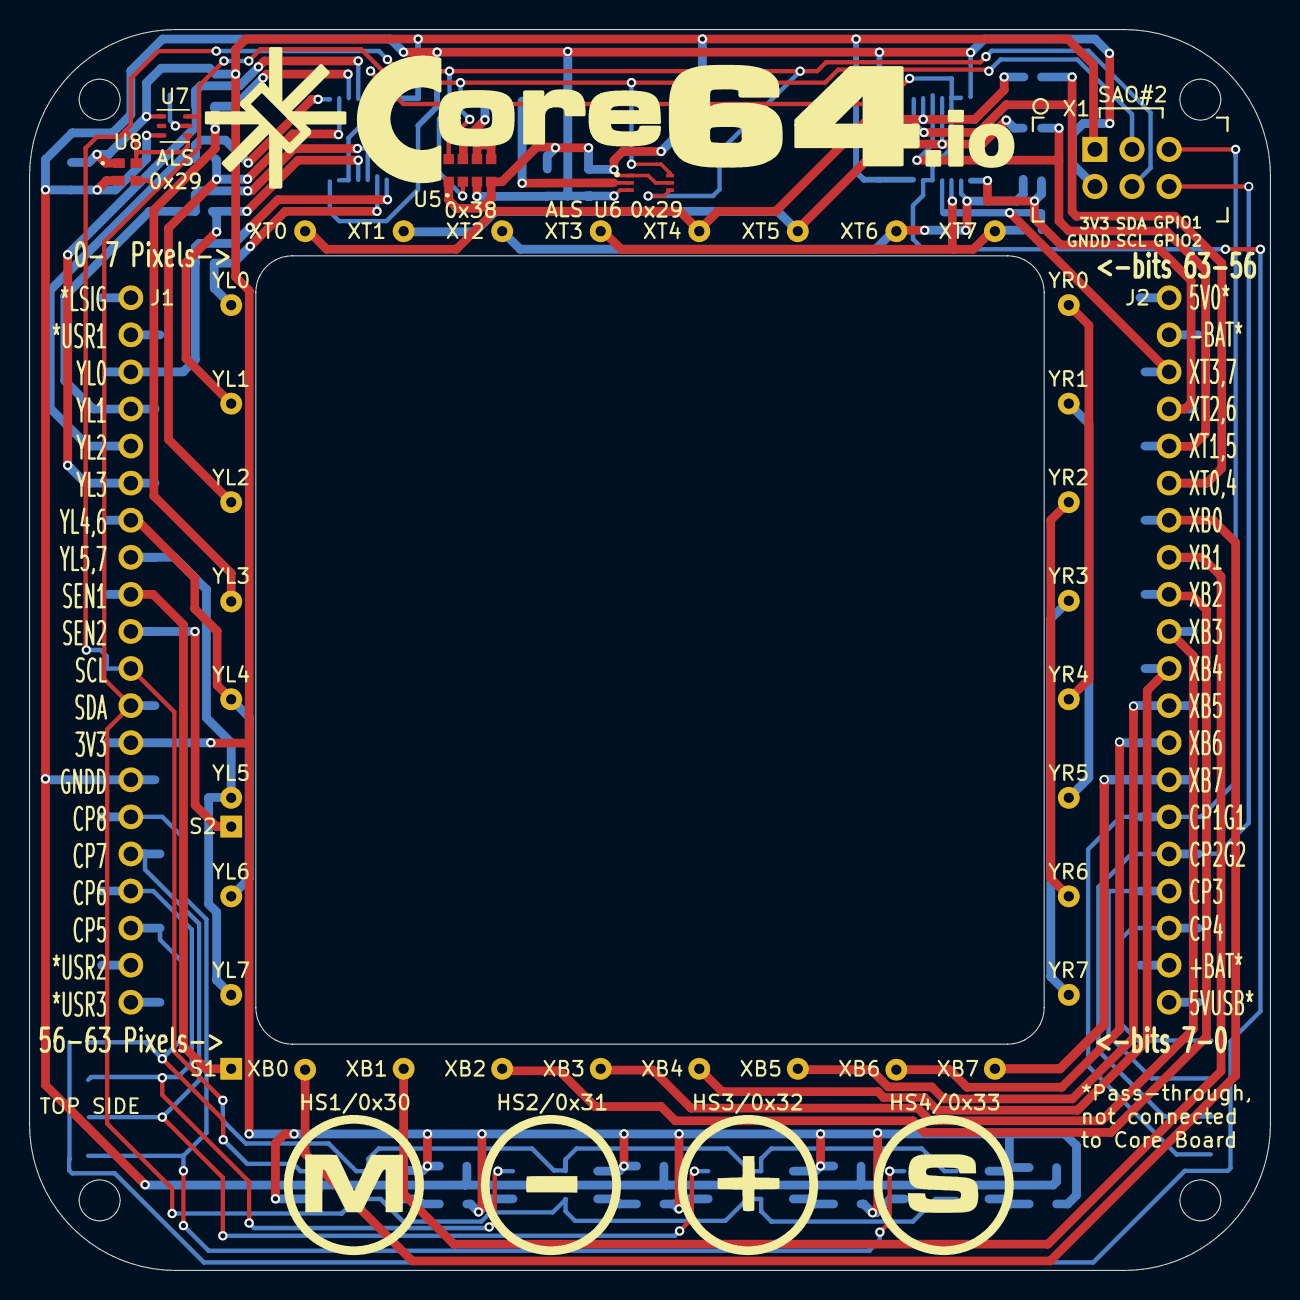
[picture p5: board Core64 CB.kicad_pcb from above]

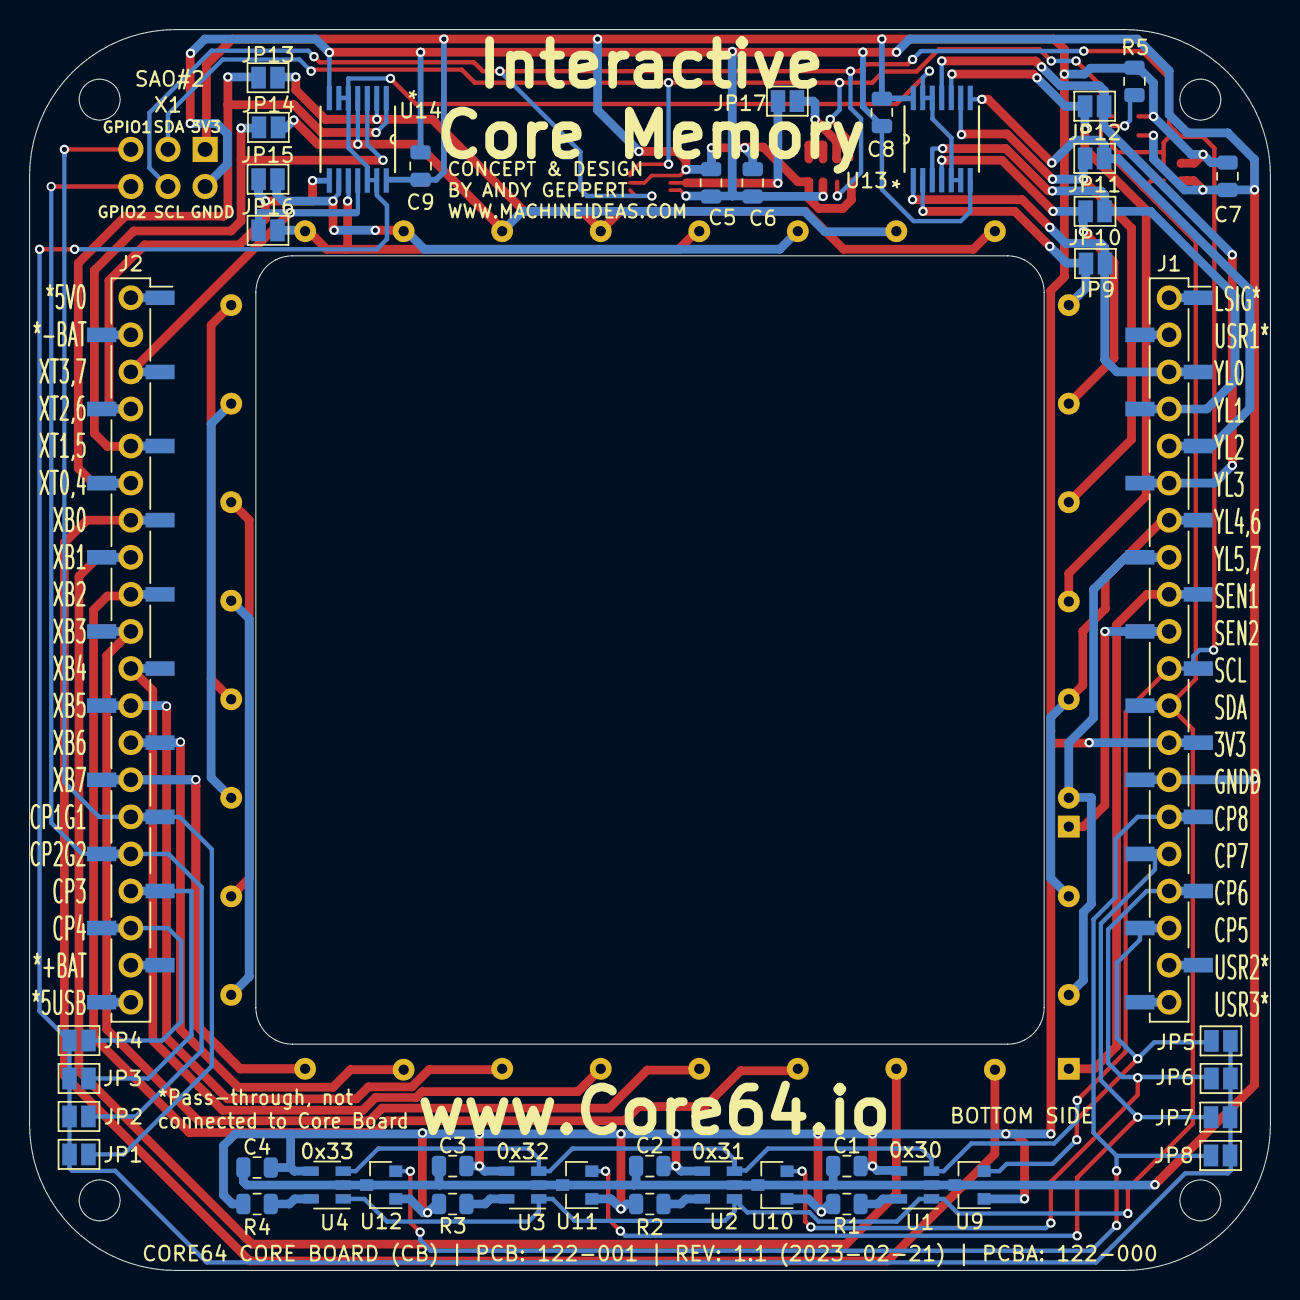
[picture p6: board Core64 CB.kicad_pcb from below]

Board: 2 copper layers, 85.0 x 85.0 mm, 51 parts (43 on the bottom side), 53 nets.
