ageppert/Core-64-Interactive-Core-Memory-Badge/Electronic Design/Core64 LM v1.0/Core64 LM v1.0.kicad_pcb

## KiCad design Electronic Design/Core64 LM v1.0/Core64 LM v1.0.kicad_pcb (2025-01-02)

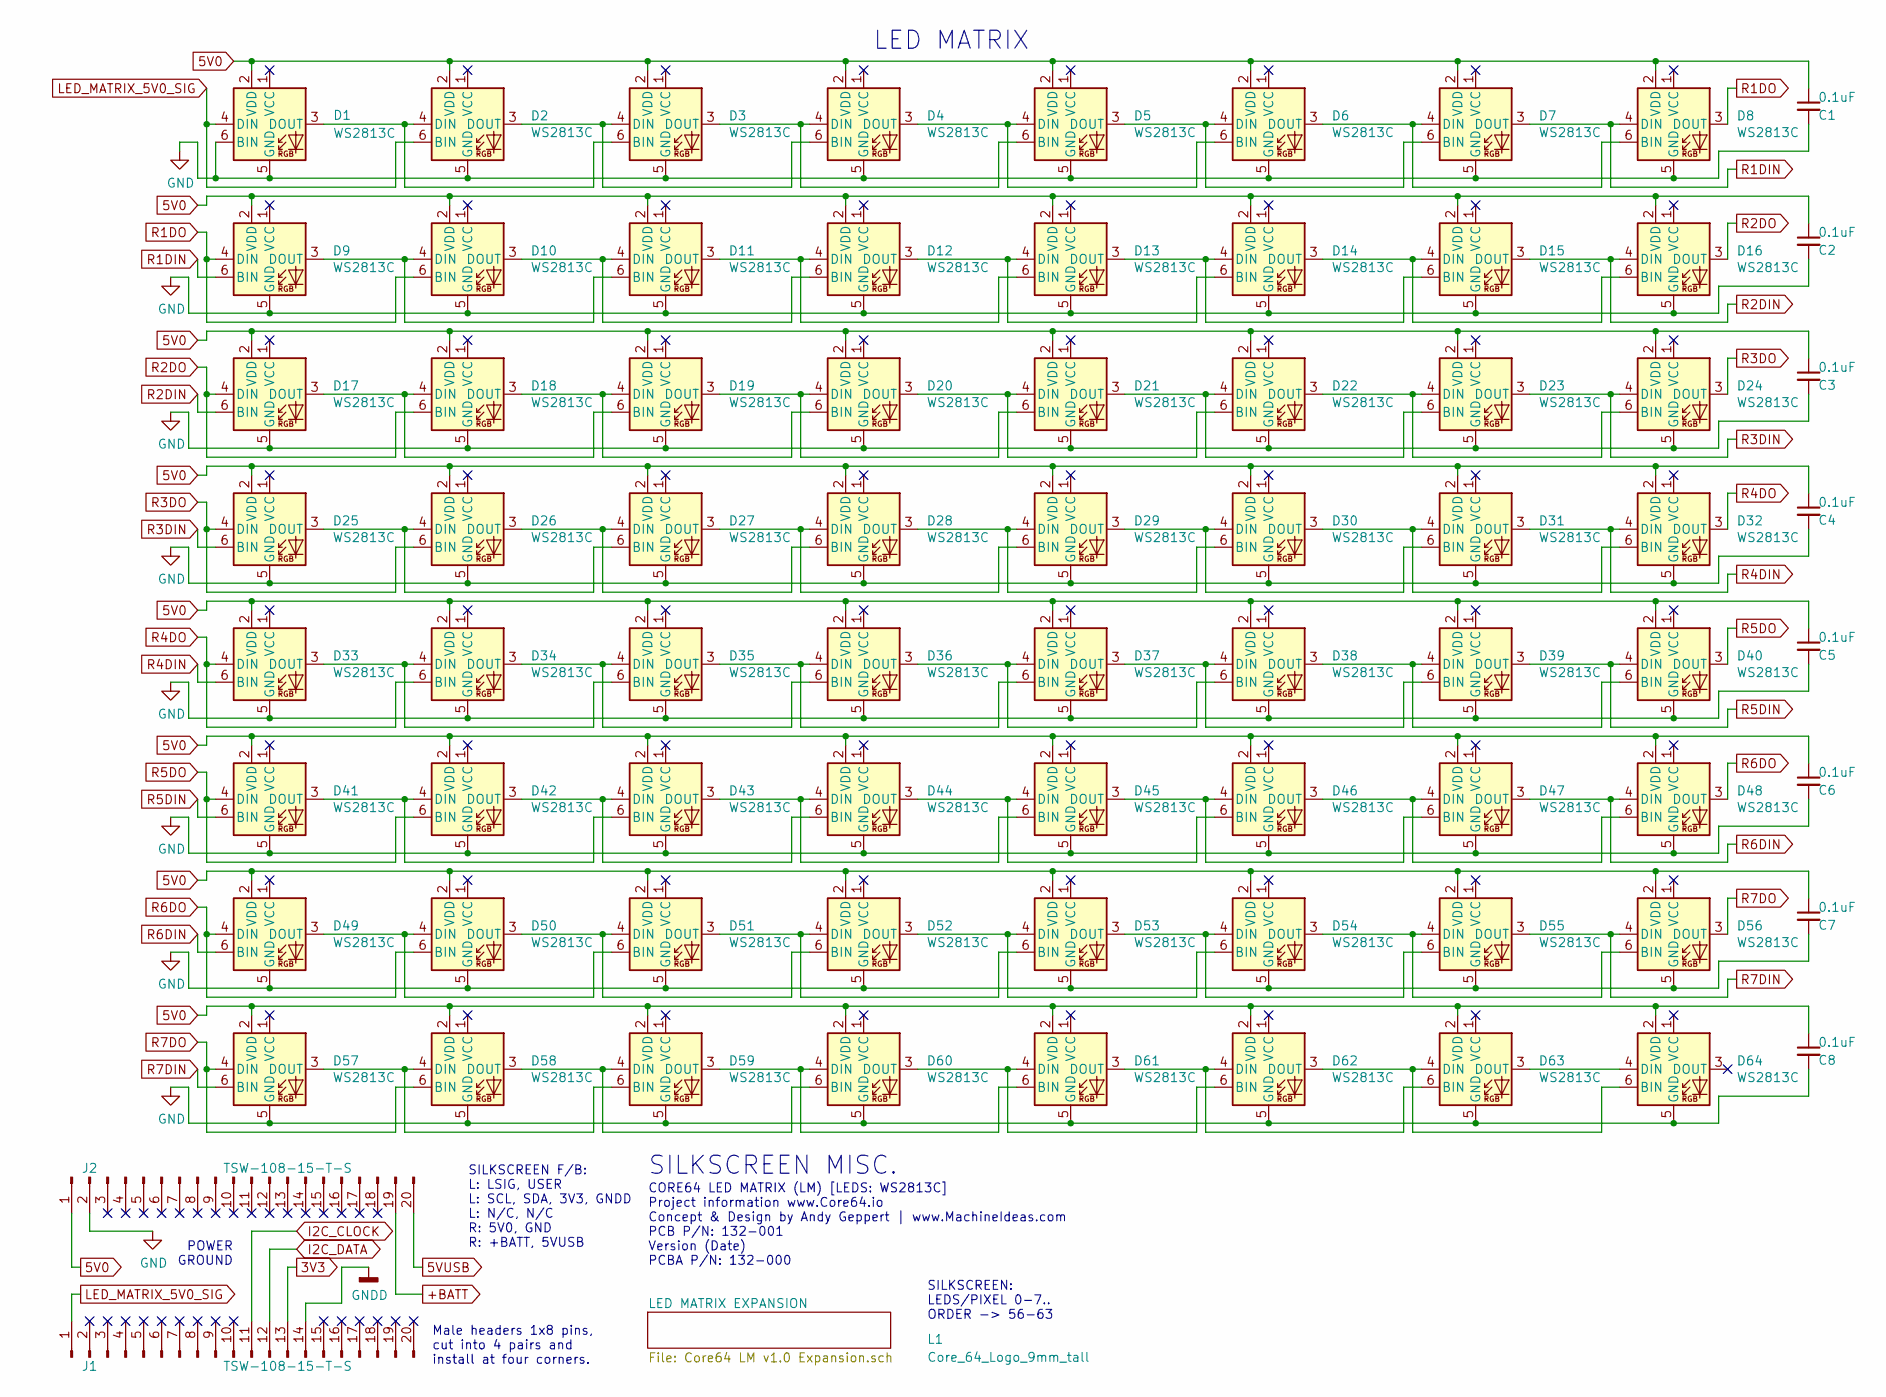
[picture p7: schematic Core64 LM v1.0.sch, Core64 LED MATRIX (LM)]

Parts:
C1, C2, C3, C4, C5, C6, C7, C8: 0.1uF; C_0603_1608Metric; Mfr P/N CC0603KRX7R9BB104; JLCPCB P/N C14663
D1, D2, D3, D4, D5, D6, D7, D8, D9, D10, D11, D12, D13, D14, D15, D16, D17, D18, D19, D20, D21, D22, D23, D24, D25, D26, D27, D28, D29, D30, D31, D32, D33, D34, D35, D36, D37, D38, D39, D40, D41, D42, D43, D44, D45, D46, D47, D48, D49, D50, D51, D52, D53, D54, D55, D56, D57, D58, D59, D60, D61, D62, D63, D64: WS2813C; LED_WS2813_PLCC6_5.0x5.0mm_P1.6mm_Core64_Abg_Mod; JLCPCB P/N C194323
J1, J2: TSW-108-15-T-S; PinHeader_1x20_P2.54mm_Vertical_SMD_and_TH_Pin1Right; Mfr P/N TSW-108-15-T-S
L1: Core_64_Logo_9mm_tall; Core64_Logo_9mm_tall

Connections:
3V3: J1.13; also elsewhere on the board
5V0: C1.1, C2.1, C3.1, C4.1, C5.1, C6.1, C7.1, C8.1, D1.2 (VDD), D2.2 (VDD), D3.2 (VDD), D4.2 (VDD), D5.2 (VDD), D6.2 (VDD), D7.2 (VDD), D8.2 (VDD), D9.2 (VDD), D10.2 (VDD), D11.2 (VDD), D12.2 (VDD), D13.2 (VDD), D14.2 (VDD), D15.2 (VDD), D16.2 (VDD), D17.2 (VDD), D18.2 (VDD), D19.2 (VDD), D20.2 (VDD), D21.2 (VDD), D22.2 (VDD), D23.2 (VDD), D24.2 (VDD), D25.2 (VDD), D26.2 (VDD), D27.2 (VDD), D28.2 (VDD), D29.2 (VDD), D30.2 (VDD), D31.2 (VDD), D32.2 (VDD), D33.2 (VDD), D34.2 (VDD), D35.2 (VDD), D36.2 (VDD), D37.2 (VDD), D38.2 (VDD), D39.2 (VDD), D40.2 (VDD), D41.2 (VDD), D42.2 (VDD), D43.2 (VDD), D44.2 (VDD), D45.2 (VDD), D46.2 (VDD), D47.2 (VDD), D48.2 (VDD), D49.2 (VDD), D50.2 (VDD), D51.2 (VDD), D52.2 (VDD), D53.2 (VDD), D54.2 (VDD), D55.2 (VDD), D56.2 (VDD), D57.2 (VDD), D58.2 (VDD), D59.2 (VDD), D60.2 (VDD), D61.2 (VDD), D62.2 (VDD), D63.2 (VDD), D64.2 (VDD), J2.1; also elsewhere on the board
5VUSB: J2.20; also elsewhere on the board
+BATT: J2.19; also elsewhere on the board
GND: C1.2, C2.2, C3.2, C4.2, C5.2, C6.2, C7.2, C8.2, D1.5 (GND), D1.6 (BIN), D2.5 (GND), D3.5 (GND), D4.5 (GND), D5.5 (GND), D6.5 (GND), D7.5 (GND), D8.5 (GND), D9.5 (GND), D10.5 (GND), D11.5 (GND), D12.5 (GND), D13.5 (GND), D14.5 (GND), D15.5 (GND), D16.5 (GND), D17.5 (GND), D18.5 (GND), D19.5 (GND), D20.5 (GND), D21.5 (GND), D22.5 (GND), D23.5 (GND), D24.5 (GND), D25.5 (GND), D26.5 (GND), D27.5 (GND), D28.5 (GND), D29.5 (GND), D30.5 (GND), D31.5 (GND), D32.5 (GND), D33.5 (GND), D34.5 (GND), D35.5 (GND), D36.5 (GND), D37.5 (GND), D38.5 (GND), D39.5 (GND), D40.5 (GND), D41.5 (GND), D42.5 (GND), D43.5 (GND), D44.5 (GND), D45.5 (GND), D46.5 (GND), D47.5 (GND), D48.5 (GND), D49.5 (GND), D50.5 (GND), D51.5 (GND), D52.5 (GND), D53.5 (GND), D54.5 (GND), D55.5 (GND), D56.5 (GND), D57.5 (GND), D58.5 (GND), D59.5 (GND), D60.5 (GND), D61.5 (GND), D62.5 (GND), D63.5 (GND), D64.5 (GND), J2.2; also elsewhere on the board
GNDD: J1.14; also elsewhere on the board
I2C_CLOCK: J1.11; also elsewhere on the board
I2C_DATA: J1.12; also elsewhere on the board
LED_MATRIX_5V0_SIG: D1.4 (DIN), D2.6 (BIN), J1.1
unnamed: D1.3 (DOUT), D2.4 (DIN), D3.6 (BIN)
unnamed: D2.3 (DOUT), D3.4 (DIN), D4.6 (BIN)
unnamed: D3.3 (DOUT), D4.4 (DIN), D5.6 (BIN)
unnamed: D4.3 (DOUT), D5.4 (DIN), D6.6 (BIN)
unnamed: D5.3 (DOUT), D6.4 (DIN), D7.6 (BIN)
unnamed: D6.3 (DOUT), D7.4 (DIN), D8.6 (BIN)
unnamed: D10.3 (DOUT), D11.4 (DIN), D12.6 (BIN)
unnamed: D9.3 (DOUT), D10.4 (DIN), D11.6 (BIN)
unnamed: D11.3 (DOUT), D12.4 (DIN), D13.6 (BIN)
unnamed: D12.3 (DOUT), D13.4 (DIN), D14.6 (BIN)
unnamed: D13.3 (DOUT), D14.4 (DIN), D15.6 (BIN)
unnamed: D14.3 (DOUT), D15.4 (DIN), D16.6 (BIN)
unnamed: D17.3 (DOUT), D18.4 (DIN), D19.6 (BIN)
unnamed: D18.3 (DOUT), D19.4 (DIN), D20.6 (BIN)
unnamed: D19.3 (DOUT), D20.4 (DIN), D21.6 (BIN)
unnamed: D20.3 (DOUT), D21.4 (DIN), D22.6 (BIN)
unnamed: D21.3 (DOUT), D22.4 (DIN), D23.6 (BIN)
unnamed: D22.3 (DOUT), D23.4 (DIN), D24.6 (BIN)
unnamed: D25.3 (DOUT), D26.4 (DIN), D27.6 (BIN)
unnamed: D26.3 (DOUT), D27.4 (DIN), D28.6 (BIN)
unnamed: D27.3 (DOUT), D28.4 (DIN), D29.6 (BIN)
unnamed: D28.3 (DOUT), D29.4 (DIN), D30.6 (BIN)
unnamed: D29.3 (DOUT), D30.4 (DIN), D31.6 (BIN)
unnamed: D30.3 (DOUT), D31.4 (DIN), D32.6 (BIN)
unnamed: D33.3 (DOUT), D34.4 (DIN), D35.6 (BIN)
unnamed: D34.3 (DOUT), D35.4 (DIN), D36.6 (BIN)
unnamed: D35.3 (DOUT), D36.4 (DIN), D37.6 (BIN)
unnamed: D36.3 (DOUT), D37.4 (DIN), D38.6 (BIN)
unnamed: D37.3 (DOUT), D38.4 (DIN), D39.6 (BIN)
unnamed: D38.3 (DOUT), D39.4 (DIN), D40.6 (BIN)
unnamed: D41.3 (DOUT), D42.4 (DIN), D43.6 (BIN)
unnamed: D42.3 (DOUT), D43.4 (DIN), D44.6 (BIN)
unnamed: D43.3 (DOUT), D44.4 (DIN), D45.6 (BIN)
unnamed: D44.3 (DOUT), D45.4 (DIN), D46.6 (BIN)
unnamed: D45.3 (DOUT), D46.4 (DIN), D47.6 (BIN)
unnamed: D46.3 (DOUT), D47.4 (DIN), D48.6 (BIN)
unnamed: D49.3 (DOUT), D50.4 (DIN), D51.6 (BIN)
unnamed: D50.3 (DOUT), D51.4 (DIN), D52.6 (BIN)
unnamed: D51.3 (DOUT), D52.4 (DIN), D53.6 (BIN)
unnamed: D52.3 (DOUT), D53.4 (DIN), D54.6 (BIN)
unnamed: D53.3 (DOUT), D54.4 (DIN), D55.6 (BIN)
unnamed: D54.3 (DOUT), D55.4 (DIN), D56.6 (BIN)
unnamed: D57.3 (DOUT), D58.4 (DIN), D59.6 (BIN)
unnamed: D58.3 (DOUT), D59.4 (DIN), D60.6 (BIN)
unnamed: D59.3 (DOUT), D60.4 (DIN), D61.6 (BIN)
unnamed: D60.3 (DOUT), D61.4 (DIN), D62.6 (BIN)
unnamed: D61.3 (DOUT), D62.4 (DIN), D63.6 (BIN)
unnamed: D62.3 (DOUT), D63.4 (DIN), D64.6 (BIN)
unnamed: D63.3 (DOUT), D64.4 (DIN)
R1DIN: D7.3 (DOUT), D8.4 (DIN), D9.6 (BIN)
R1DO: D8.3 (DOUT), D9.4 (DIN), D10.6 (BIN)
R2DIN: D15.3 (DOUT), D16.4 (DIN), D17.6 (BIN)
R2DO: D16.3 (DOUT), D17.4 (DIN), D18.6 (BIN)
R3DIN: D23.3 (DOUT), D24.4 (DIN), D25.6 (BIN)
R3DO: D24.3 (DOUT), D25.4 (DIN), D26.6 (BIN)
R4DIN: D31.3 (DOUT), D32.4 (DIN), D33.6 (BIN)
R4DO: D32.3 (DOUT), D33.4 (DIN), D34.6 (BIN)
R5DIN: D39.3 (DOUT), D40.4 (DIN), D41.6 (BIN)
R5DO: D40.3 (DOUT), D41.4 (DIN), D42.6 (BIN)
R6DIN: D47.3 (DOUT), D48.4 (DIN), D49.6 (BIN)
R6DO: D48.3 (DOUT), D49.4 (DIN), D50.6 (BIN)
R7DIN: D55.3 (DOUT), D56.4 (DIN), D57.6 (BIN)
R7DO: D56.3 (DOUT), D57.4 (DIN), D58.6 (BIN)

Notes on the sheet:
SILKSCREEN F/B: L: LSIG, USER L: SCL, SDA, 3V3, GNDD L: N/C, N/C R: 5V0, GND R: +BATT, 5VUSB
POWER GROUND
LED MATRIX
SILKSCREEN: LEDS/PIXEL 0-7.. ORDER -> 56-63
CORE64 LED MATRIX (LM) [LEDS: WS2813C] Project information www.Core64.io Concept & Design by Andy Geppert | www.MachineIdeas.com PCB P/N: 132-001 Version (Date) PCBA P/N: 132-000
SILKSCREEN MISC.
Male headers 1x8 pins, cut into 4 pairs and install at four corners.

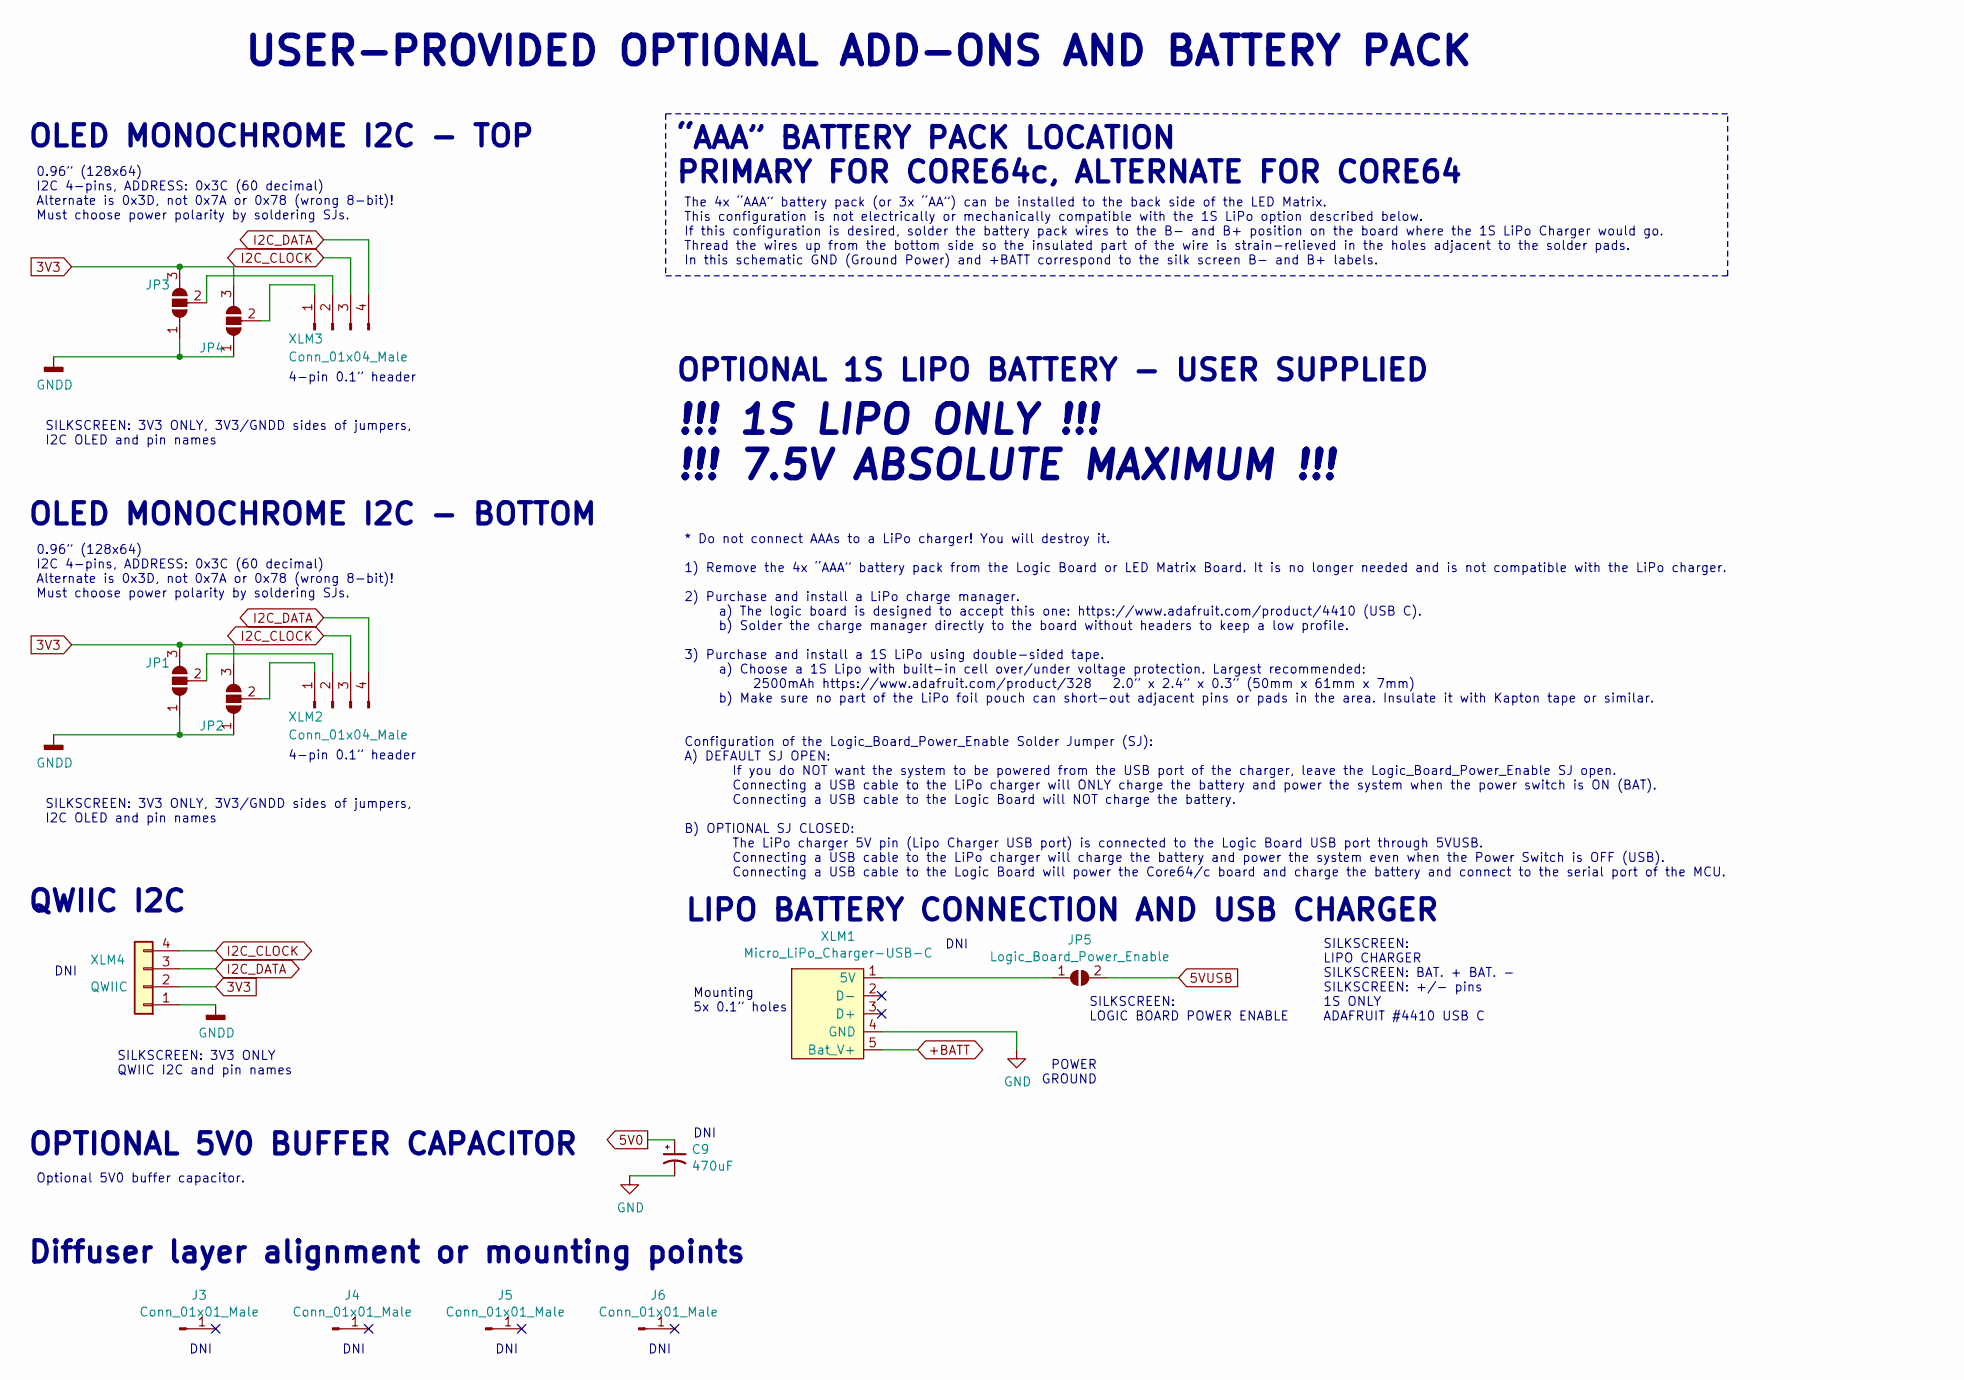
[picture p8: schematic Core64 LM v1.0 Expansion.sch, Core64 LED MATRIX (LM)]

Parts:
C9: 470uF; CP_Elec_6.3x7.7
J3, J4, J5, J6: Conn_01x01_Male; PinHeader_1x01_P2.54mm_Vertical_No_Registration
JP1, JP2, JP3, JP4: SolderJumper_3_Open; SolderJumper-3_P1.3mm_Open_Pad1.0x1.5mm_NumberLabels
JP5: Logic_Board_Power_Enable; SolderJumper-2_P1.3mm_Open_Pad1.0x1.5mm
XLM1: Micro_LiPo_Charger-USB-C; Micro_LiPo_Charger_USB-C_CornerSMD
XLM2, XLM3: Conn_01x04_Male; PinHeader_1x04_P2.54mm_Vertical
XLM4: QWIIC; JST_SH_SM04B-SRSS-TB_1x04-1MP_P1.00mm_Horizontal

Connections:
3V3: JP1.3 (B), JP2.3 (B), JP3.3 (B), JP4.3 (B), XLM4.2; also elsewhere on the board
5V0: C9.1; also elsewhere on the board
5VUSB: JP5.2 (B); also elsewhere on the board
+BATT: XLM1.5 (Bat_V+); also elsewhere on the board
GND: C9.2, XLM1.4 (GND); also elsewhere on the board
GNDD: JP1.1 (A), JP2.1 (A), JP3.1 (A), JP4.1 (A), XLM4.1; also elsewhere on the board
I2C_CLOCK: XLM2.3, XLM3.3, XLM4.4; also elsewhere on the board
I2C_DATA: XLM2.4, XLM3.4, XLM4.3; also elsewhere on the board
unnamed: JP1.2 (C), XLM2.2
unnamed: JP2.2 (C), XLM2.1
unnamed: JP3.2 (C), XLM3.2
unnamed: JP4.2 (C), XLM3.1
unnamed: JP5.1 (A), XLM1.1 (5V)

Notes on the sheet:
OLED MONOCHROME I2C - TOP
0.96” (128x64) I2C 4-pins, ADDRESS: 0x3C (60 decimal) Alternate is 0x3D, not 0x7A or 0x78 (wrong 8-bit)! Must choose power polarity by soldering SJs.
QWIIC I2C
SILKSCREEN: 3V3 ONLY, 3V3/GNDD sides of jumpers, I2C OLED and pin names
4-pin 0.1” header
SILKSCREEN: 3V3 ONLY QWIIC I2C and pin names
POWER GROUND
LIPO BATTERY CONNECTION AND USB CHARGER
USER-PROVIDED OPTIONAL ADD-ONS AND BATTERY PACK
OPTIONAL 1S LIPO BATTERY - USER SUPPLIED
!!! 1S LIPO ONLY !!! !!! 7.5V ABSOLUTE MAXIMUM !!!
SILKSCREEN: LIPO CHARGER SILKSCREEN: BAT. + BAT. - SILKSCREEN: +/- pins 1S ONLY ADAFRUIT #4410 USB C
Mounting 5x 0.1” holes
* Do not connect AAAs to a LiPo charger! You will destroy it. 1) Remove the 4x “AAA” battery pack from the Logic Board or LED Matrix Board. It is no longer needed and is not compatible with the LiPo charger. 2) Purchase and install a LiPo charge manager. a) The logic board is designed to accept thi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
OLED MONOCHROME I2C - BOTTOM
SILKSCREEN: LOGIC BOARD POWER ENABLE
Diffuser layer alignment or mounting points
“AAA” BATTERY PACK LOCATION PRIMARY FOR CORE64c, ALTERNATE FOR CORE64
The 4x “AAA” battery pack (or 3x “AA”) can be installed to the back side of the LED Matrix. This configuration is not electrically or mechanically compatible with the 1S LiPo option described below. If this configuration is desired, solder the battery pack wires to the B- and B+ position on the boa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
OPTIONAL 5V0 BUFFER CAPACITOR
Optional 5V0 buffer capacitor.
DNI

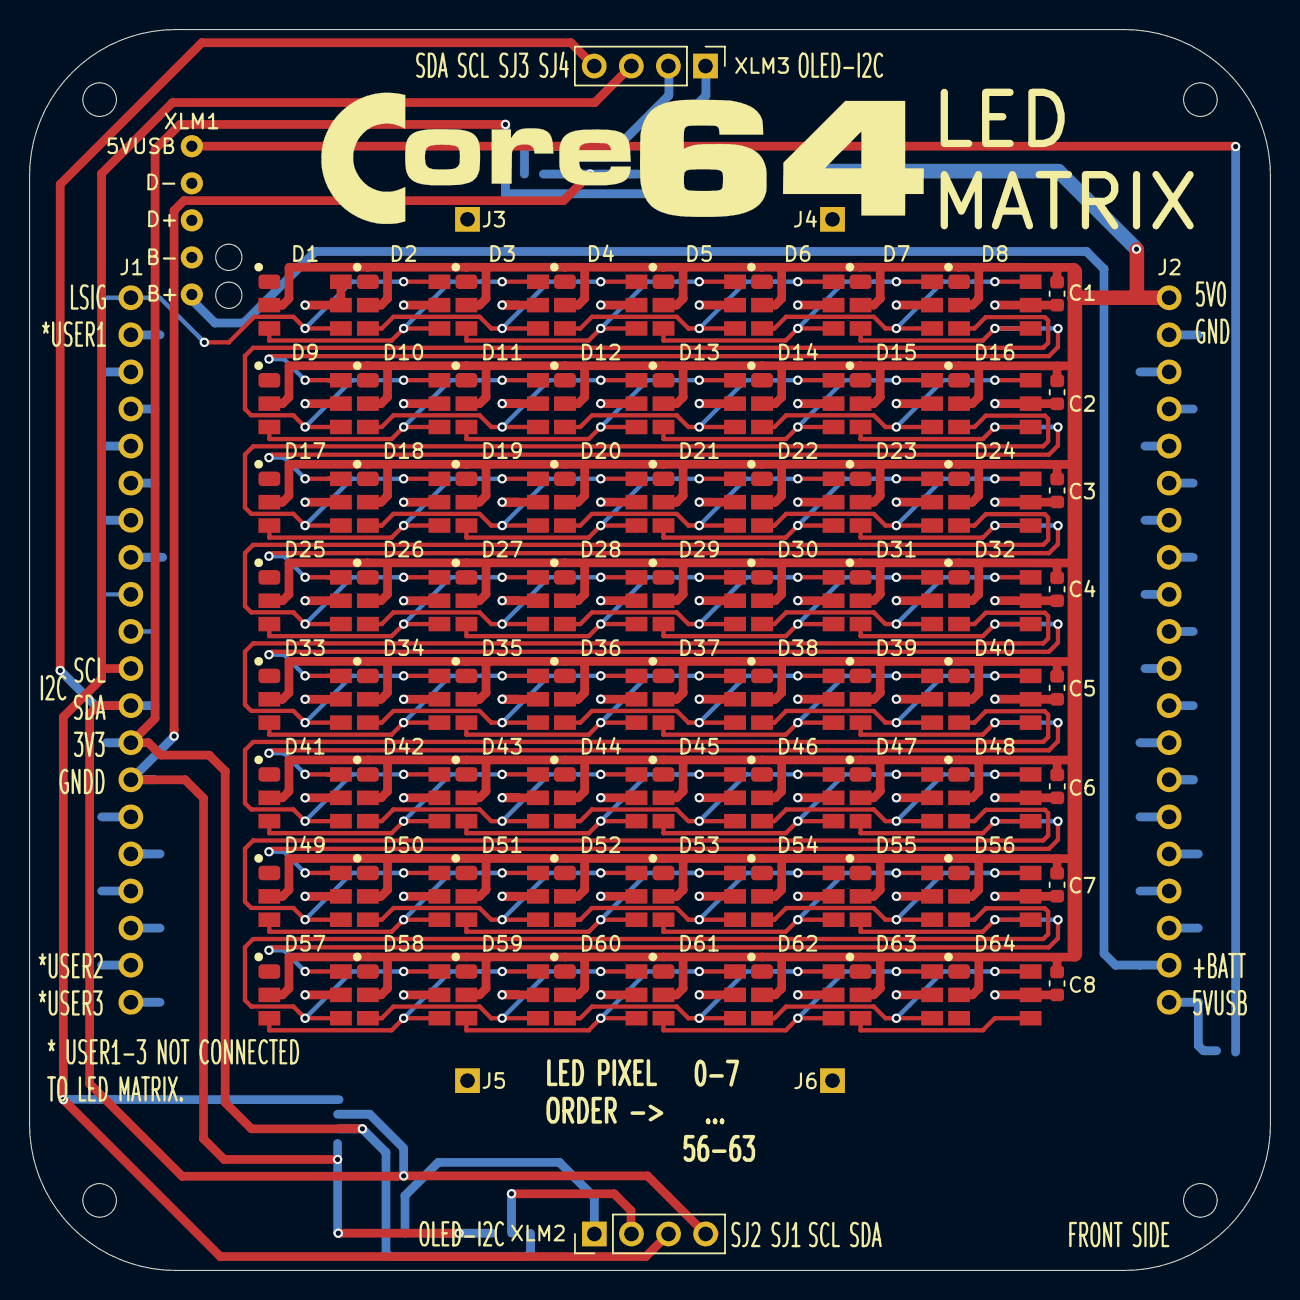
[picture p9: board Core64 LM v1.0.kicad_pcb from above]

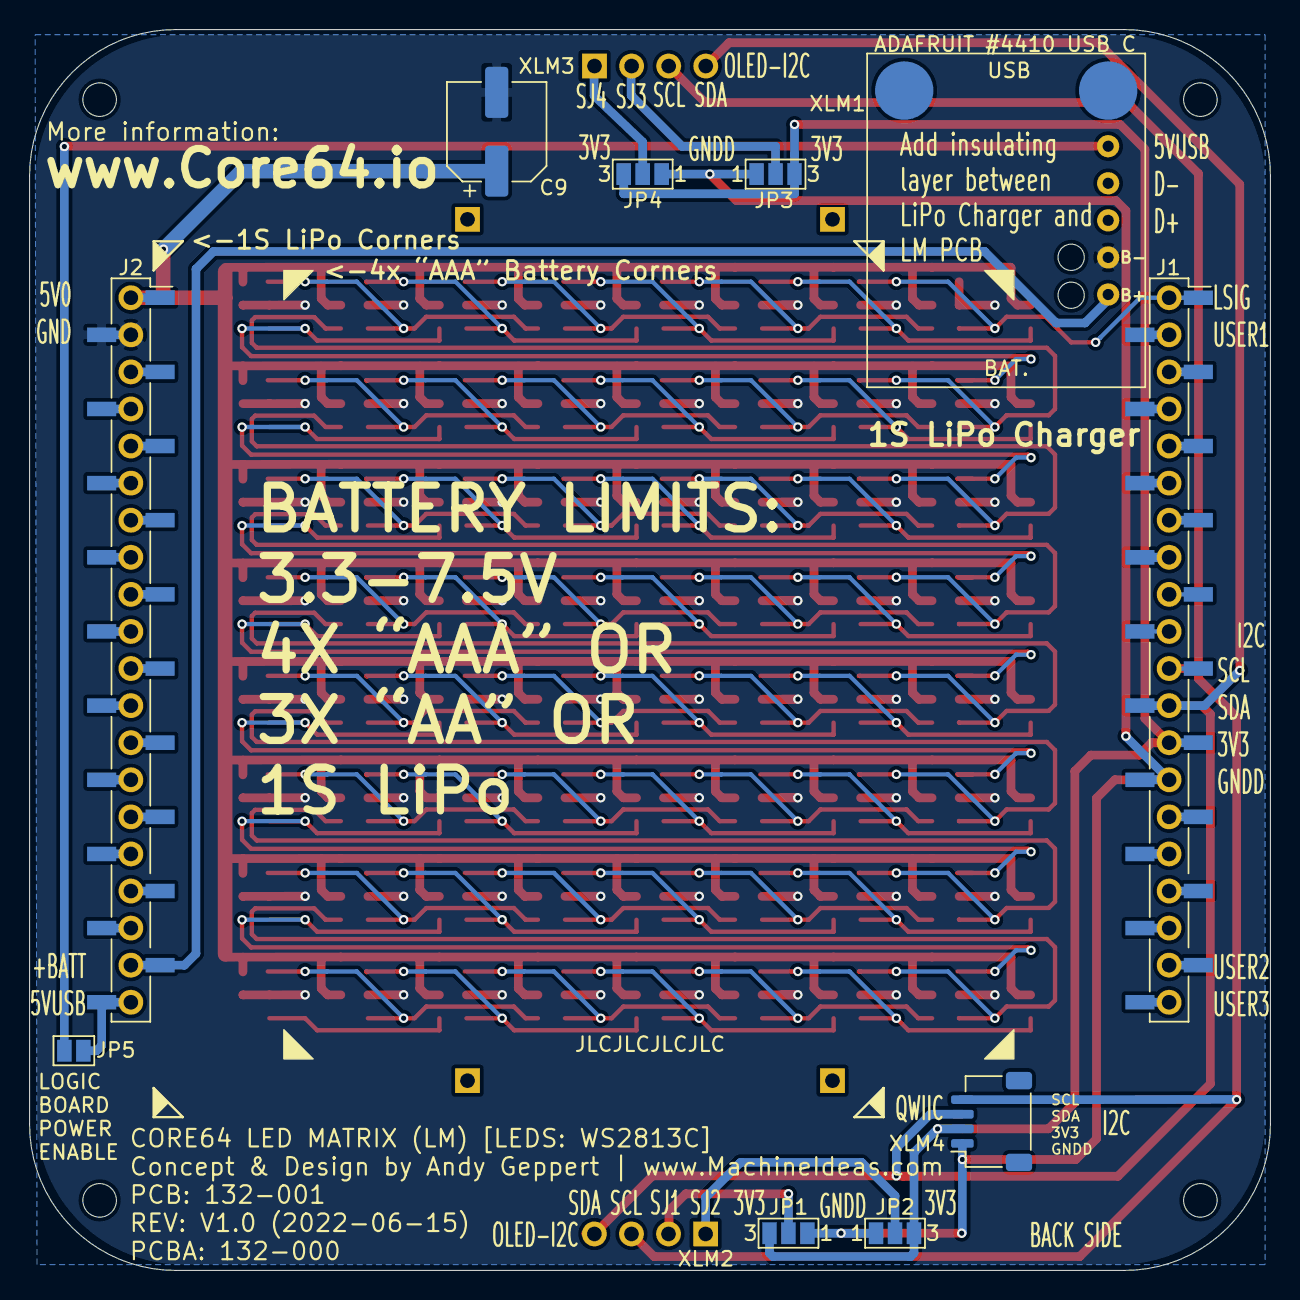
[picture p10: board Core64 LM v1.0.kicad_pcb from below]

Board: 2 copper layers, 85.0 x 85.0 mm, 89 parts (10 on the bottom side), 77 nets.
