ageppert/Core-64-Interactive-Core-Memory-Badge/Electronic Design/Core64 HB v0.1/Core64 HB.kicad_pcb

## KiCad design Electronic Design/Core64 HB v0.1/Core64 HB.kicad_pcb (2024-10-10)

Schematic: Core64 HB.kicad_sch, Core64 Hacker Board (HB)

Parts:
H1, H2: GND PAD; MountingHole_3.2mm_M3_Pad_Via
JP1, JP2: SolderJumper_3_Open; SolderJumper-3_P1.3mm_Open_RoundedPad1.0x1.5mm_NumberLabels
JP7: D2; SolderJumper-2_P1.3mm_Open_RoundedPad1.0x1.5mm
JP8: D1; SolderJumper-2_P1.3mm_Open_RoundedPad1.0x1.5mm
L1, L2: Core_64_Logo; Core64.io_w_core_symbol
X2: SSW-104-22-L-S-VS; PinSocket_1x04_P2.54mm_Vertical
X3, X7: HEADER_30-PIN_0.1; PinSocket_1x30_P2.54mm_Vertical
X5: HEADER_11-PIN_0.1; PinSocket_1x11_P2.54mm_Vertical
X6: Header_11-PIN_0.1; PinSocket_1x11_P2.54mm_Vertical
X8: SAO_conn_SFH11-NBPC-D03-ST-BK; Badgelife-SAOv169-BADGE-2x3; MPN SFH11-NBPC-D03-ST-BK
X9: QWIIC; JST_SH_SM04B-SRSS-TB_1x04-1MP_P1.00mm_Horizontal; LCSC C160404
X31, X71: DNI; PinSocket_1x30_P2.54mm_Vertical

Connections:
3V3: JP1.3 (B), JP2.3 (B), X6.1, X7.6, X8.1 (3V3), X9.2, X71.6
5V0: X5.10, X7.5, X71.5
-BATT: H1.1, H2.1, JP1.1 (A), JP2.1 (A), X5.11, X6.2, X7.2, X7.30, X8.2 (GND), X9.1, X71.2, X71.30
/5VM: X7.23, X71.23
/5VUSB: X7.3, X71.3
/+BATT: X7.1, X71.1
/+VSW: X7.4, X71.4
/ADC0_BUFF: X7.22, X71.22
/ADC1_BUFF: JP8.2 (B), X7.24, X71.24
/ADC2_BUFF: JP7.2 (B), X7.25, X71.25
/BC0_MON: X7.27, X71.27
/CM_EN: X3.6, X31.6
/CM_Q1N: X3.11, X31.11
/CM_Q1P: X3.12, X31.12
/CM_Q2N: X3.13, X31.13
/CM_Q2P: X3.14, X31.14
/CM_Q3N: X3.15, X31.15
/CM_Q3P: X3.16, X31.16
/CM_Q4N: X3.17, X31.17
/CM_Q4P: X3.18, X31.18
/CM_Q5N: X3.19, X31.19
/CM_Q5P: X3.20, X31.20
/CM_Q6N: X3.21, X31.21
/CM_Q6P: X3.22, X31.22
/CM_Q7N: X3.23, X31.23
/CM_Q7P: X3.24, X31.24
/CM_Q8N: X3.25, X31.25
/CM_Q8P: X3.26, X31.26
/CM_Q9N: X3.27, X31.27
/CM_Q9P: X3.28, X31.28
/CM_Q10N: X3.29, X31.29
/CM_Q10P: X3.30, X31.30
/CM_SENSE_PULSE: X3.4, X31.4
/CM_SENSE_RESET: X3.5, X31.5
/CM_SR_CLK: X3.8, X31.8
/CM_SR_LAT: X3.9, X31.9
/CM_SR_SER1: X3.7, X31.7
/CM_SR_~OE: X3.10, X31.10
/D1: JP8.1 (A), X6.7
/D2: JP7.1 (A), X6.8
/GPIO1_CP1_SAO1: X7.8, X8.5 (GPIO1), X71.8
/GPIO2_CP2_SAO2: X7.9, X8.6 (GPIO2), X71.9
/GPIO3_CP3_DC: X5.3, X7.10, X71.10
/GPIO4_CP4_CS2: X5.5, X6.11, X7.11, X71.11
/GPIO5_CP5_HS1: X7.12, X71.12
/GPIO6_CP6_HS2: X7.13, X71.13
/GPIO7_CP7_HS3: X7.14, X71.14
/GPIO8_CP8_HS4: X7.15, X71.15
/I2C_3V3_SCL: X2.3, X3.1, X8.4 (SCL), X9.4, X31.1
/I2C_3V3_SDA: X2.4, X3.2, X8.3 (SDA), X9.3, X31.2
/LED_ARY_3V3_SIG: X3.3, X31.3
/LR0_MON: X7.28, X71.28
/PICO_3V3OUT: X7.7, X71.7
/RR0_MON: X7.29, X71.29
/SPI_CD: X5.8, X6.9, X7.17, X71.17
/SPI_CLK: X5.2, X6.3, X7.21, X71.21
/SPI_CS1: X5.6, X6.6, X7.18, X71.18
/SPI_RESET: X5.4, X6.10, X7.16, X71.16
/SPI_SDI: X5.7, X6.4, X7.19, X71.19
/SPI_SDO: X5.1, X6.5, X7.20, X71.20
/TC0_MON: X7.26, X71.26
unnamed: JP1.2 (C), X2.2
unnamed: JP2.2 (C), X2.1

Notes on the sheet:
SILKSCREEN FRONT
AMBIENT PROX. SENSOR OLED AND!XOR IO Exp. MCP23017 AND!XOR EEPROM AT24C32r NFC CLICK PN7120
SPI
USER PORT A
https://hackaday.io/project/175182-simple-add-ons-sao using Sullins SFH11-NBPC-D03-ST-BK female header https://www.digikey.com/product-detail/en/sullins-connector-solutions/ SFH11-NBPC-D03-ST-BK/S9717-ND/4558818
SAO #1 SIMPLE ADD-ONS
COPI
Both SPI chip select lines are may be pulled high with resistors on the Logic Board. Some Logic Boards do not include the pull-up resistors.
0x29 (47) 0x30 (48) 0x31 (49) 0x32 (50) 0x33 (51) 0x57 (87)
These headers are available on the Hacker Board and are wired in parallel to the same port that is on the Logic Board and Hacker Board. USER PORT A USER PORT B OLED MONOCHROME I2C OLED COLOR SPI W/MICRO SD MICRO SD CARD, SPI (the D1 and D2 pins are shared with analog pins) SAO #1 QWIIC I2C Two of t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
POWER
ANALOG
OLED COLOR SPI W/MICRO SD
Adafruit #4682
SILKSCREEN: 3V3 Logic ONLY, 3V3/GND sides of jumpers, SPI OLED
Compatible with https://www.adafruit.com/product/4682 (pins 1-6, 9) MicroSD card standalone pins shared between TFT and OLED boards.
AMBIENT LIGHT SENSOR HALL SENSOR 1 HALL SENSOR 2 HALL SENSOR 3 HALL SENSOR 4 EEPROM (BOARD ID)
CS OLED
CIPO
Compatible: https://www.adafruit.com/product/1431 1.5” 128x128, 16-bit color w/MicroSD holder OLED has 5V -> 3V3 regulator onboard. MicroSD card standalone pins shared between TFT and OLED boards.
HACKER PLAYGROUND
3-7.5V MAX
SILKSCREEN: 3V3 ONLY, 3V3/GND sides of jumpers, I2C OLED and pin names
CORE MATRIX DRIVER QXY
I2C ADDRESS TABLE
OLED ON THIS SIDE OF HEADER -TOP VIEW OF LB
2x GND PAD 3.2 mm (.125 in) thru-hole for M3 or #4 screw
Generic 0.96” (128x64) or 1.5” (128x128) I2C 4-pins, often ADDRESS: 0x3C (60 decimal) Alternate is 0x3D, not 0x7A or 0x78 (wrong 8-bit)! Must choose power polarity by soldering SJS.
0.1" PIN GRID
CORE MATRIX DRIVE IO EXPANSION
USER-PROVIDED OPTIONAL ADD-ONS SEE CORE64 HACKER GUIDE
CA ENABLE
GPIO/CPS
SYSTEM GROUNDS
LED ARRAY
CARD ON THIS SIDE OF HEADER
MICRO SD CARD, SPI
Some of the spare IO on the Logic Board is not accessible on the Hacker Board: Spare SR Shift Register Outputs A, B, C, D If you intend to directly drive the Core Matrix Transistors (CM_QxN and CM_QyP) you need to make sure the Shift Registers outputs do not interfere. To set those outputs to a hig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
USER PORT B
Spare
HIGH POWER SYSTEM GROUND
CORE MATRIX DRIVE AND SHIFT REGISTER
4x holes 3/32” 4-pin 0.1” header
I2C ADDRESS TABLE
3V GND CLK SDI (or D0) SDO (or CMD) CS (or D3) D1 D2 CARD DETECT SPI RESET CS2
3V3 ONLY
CS SD
SAO#2 is on the Core Board
OLED SOCKET FOR LOGIC BOARD: SAMTEC 4-pin SMD Header SSW-104-22-F-S-VS
All eight analog pins are pre-connected to different parts of the Logic Board. To use the analog pins for your own purposes, review the Logic Board connections and cut the traces associated with the solder jumpers and net-ties on the signal paths you want to use. Two of the analog pins are shared w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
PASS-THROUGH PORTS
0x38 (56) 0x3C (60) 0x20 (32) 0x50 (80) 0x50-53
QWIIC I2C
OPTIONAL:
I2C
SILKSCREEN BACK
INCLUDED:
OLED MONOCHROME I2C
Power switched is all done on the Logic Board. Do not inject power into 5V0, 3V3, or P3V3. Those are regulated power outputs ONLY.
DIGITAL LOGIC GROUND
CORE SENSE
All 7-bit addresses should be greater than 0x07 and less than 0x78 (120).

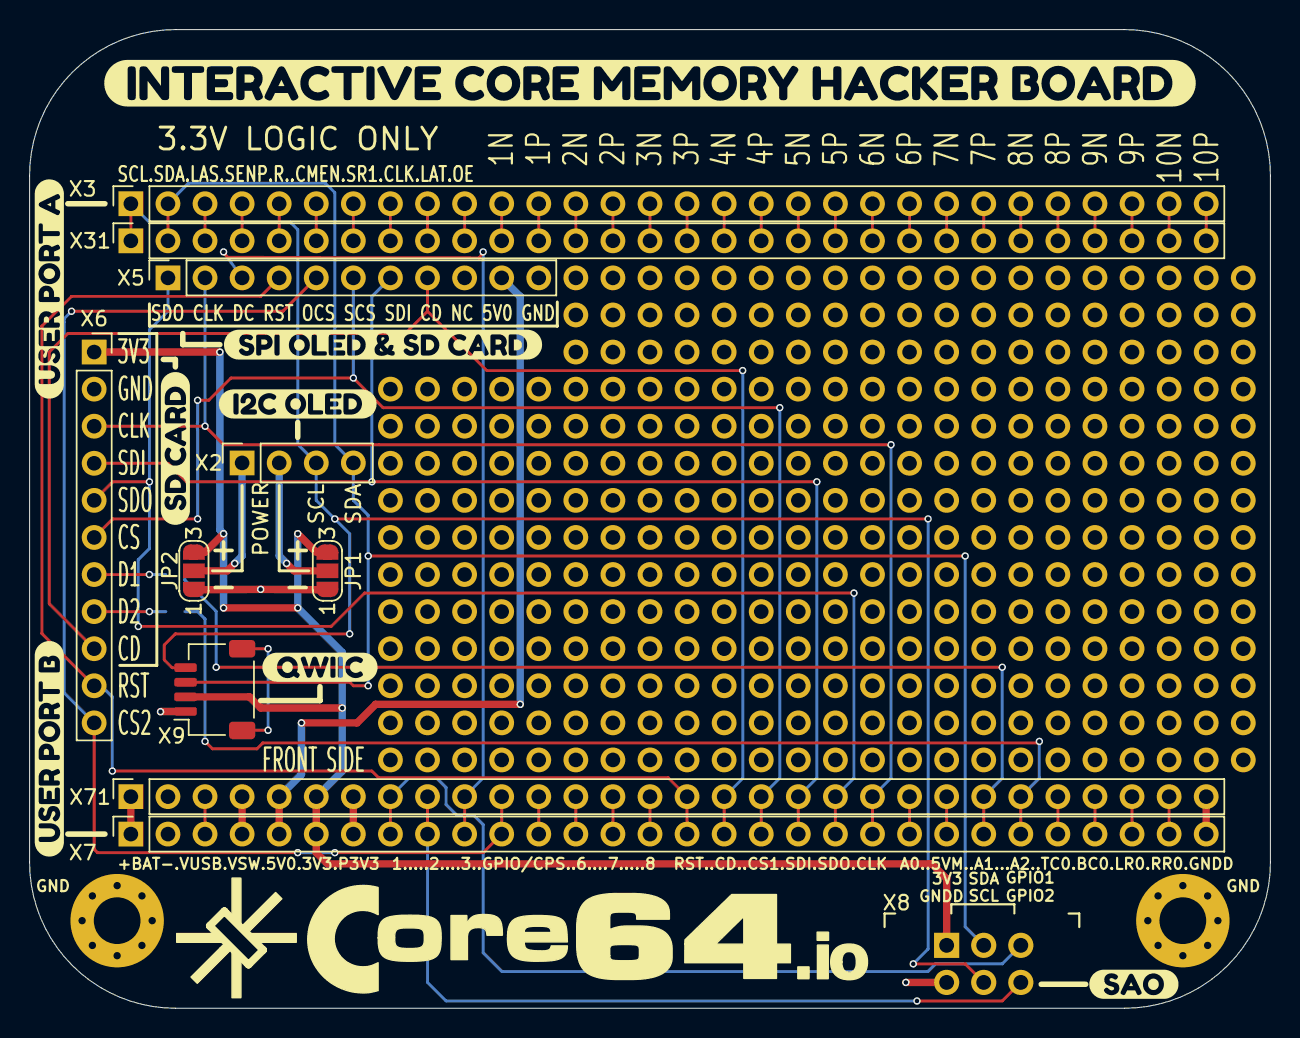
[picture p11: board Core64 HB.kicad_pcb from above]

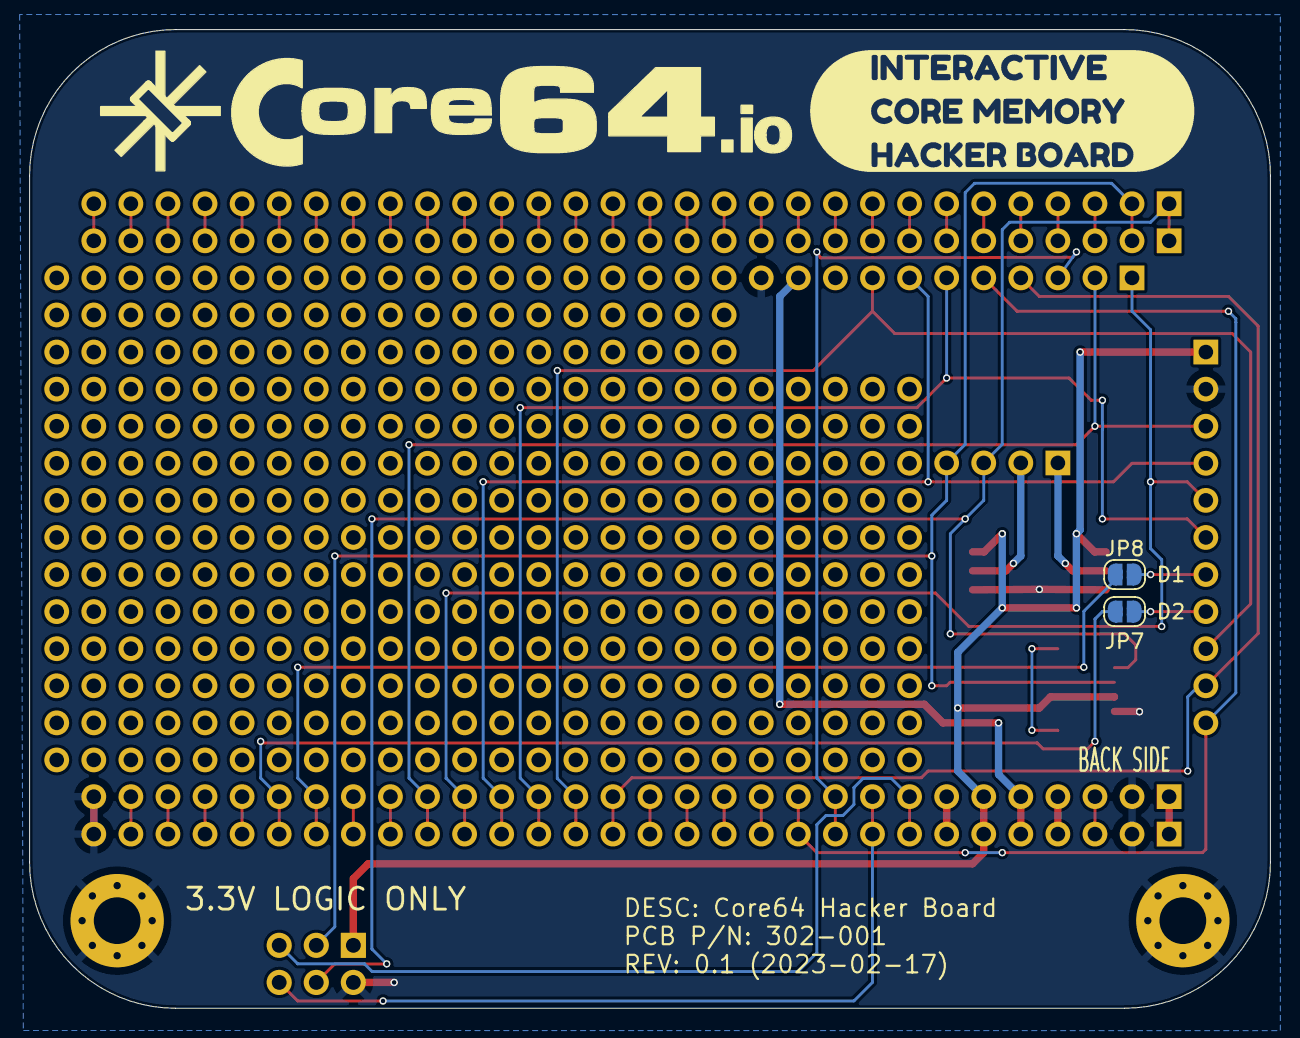
[picture p12: board Core64 HB.kicad_pcb from below]

Board: 2 copper layers, 85.0 x 67.0 mm, 26 parts (4 on the bottom side), 63 nets.

Other parts of the board:
kibuzzard-63DD6D83: G***; kibuzzard-63DD6D83
kibuzzard-63DD6DA7: G***; kibuzzard-63DD6DA7
kibuzzard-63DD6DEE: G***; kibuzzard-63DD6DEE
kibuzzard-63DD6FFD: G***; kibuzzard-63DD6FFD
kibuzzard-63DD70A9: G***; kibuzzard-63DD70A9
kibuzzard-63DD721E: G***; kibuzzard-63DD721E
kibuzzard-63DD735C: G***; kibuzzard-63DD735C
kibuzzard-63EEE4D8: G***; kibuzzard-63EEE4D8
kibuzzard-63EEE6A3: G***; kibuzzard-63EEE6A3
