ageppert/Core-64-Interactive-Core-Memory-Badge/Electronic Design/Core64 LB v0.6/Core64 LB v0.6.kicad_pcb

## KiCad design Electronic Design/Core64 LB v0.6/Core64 LB v0.6.kicad_pcb (2021-11-16)

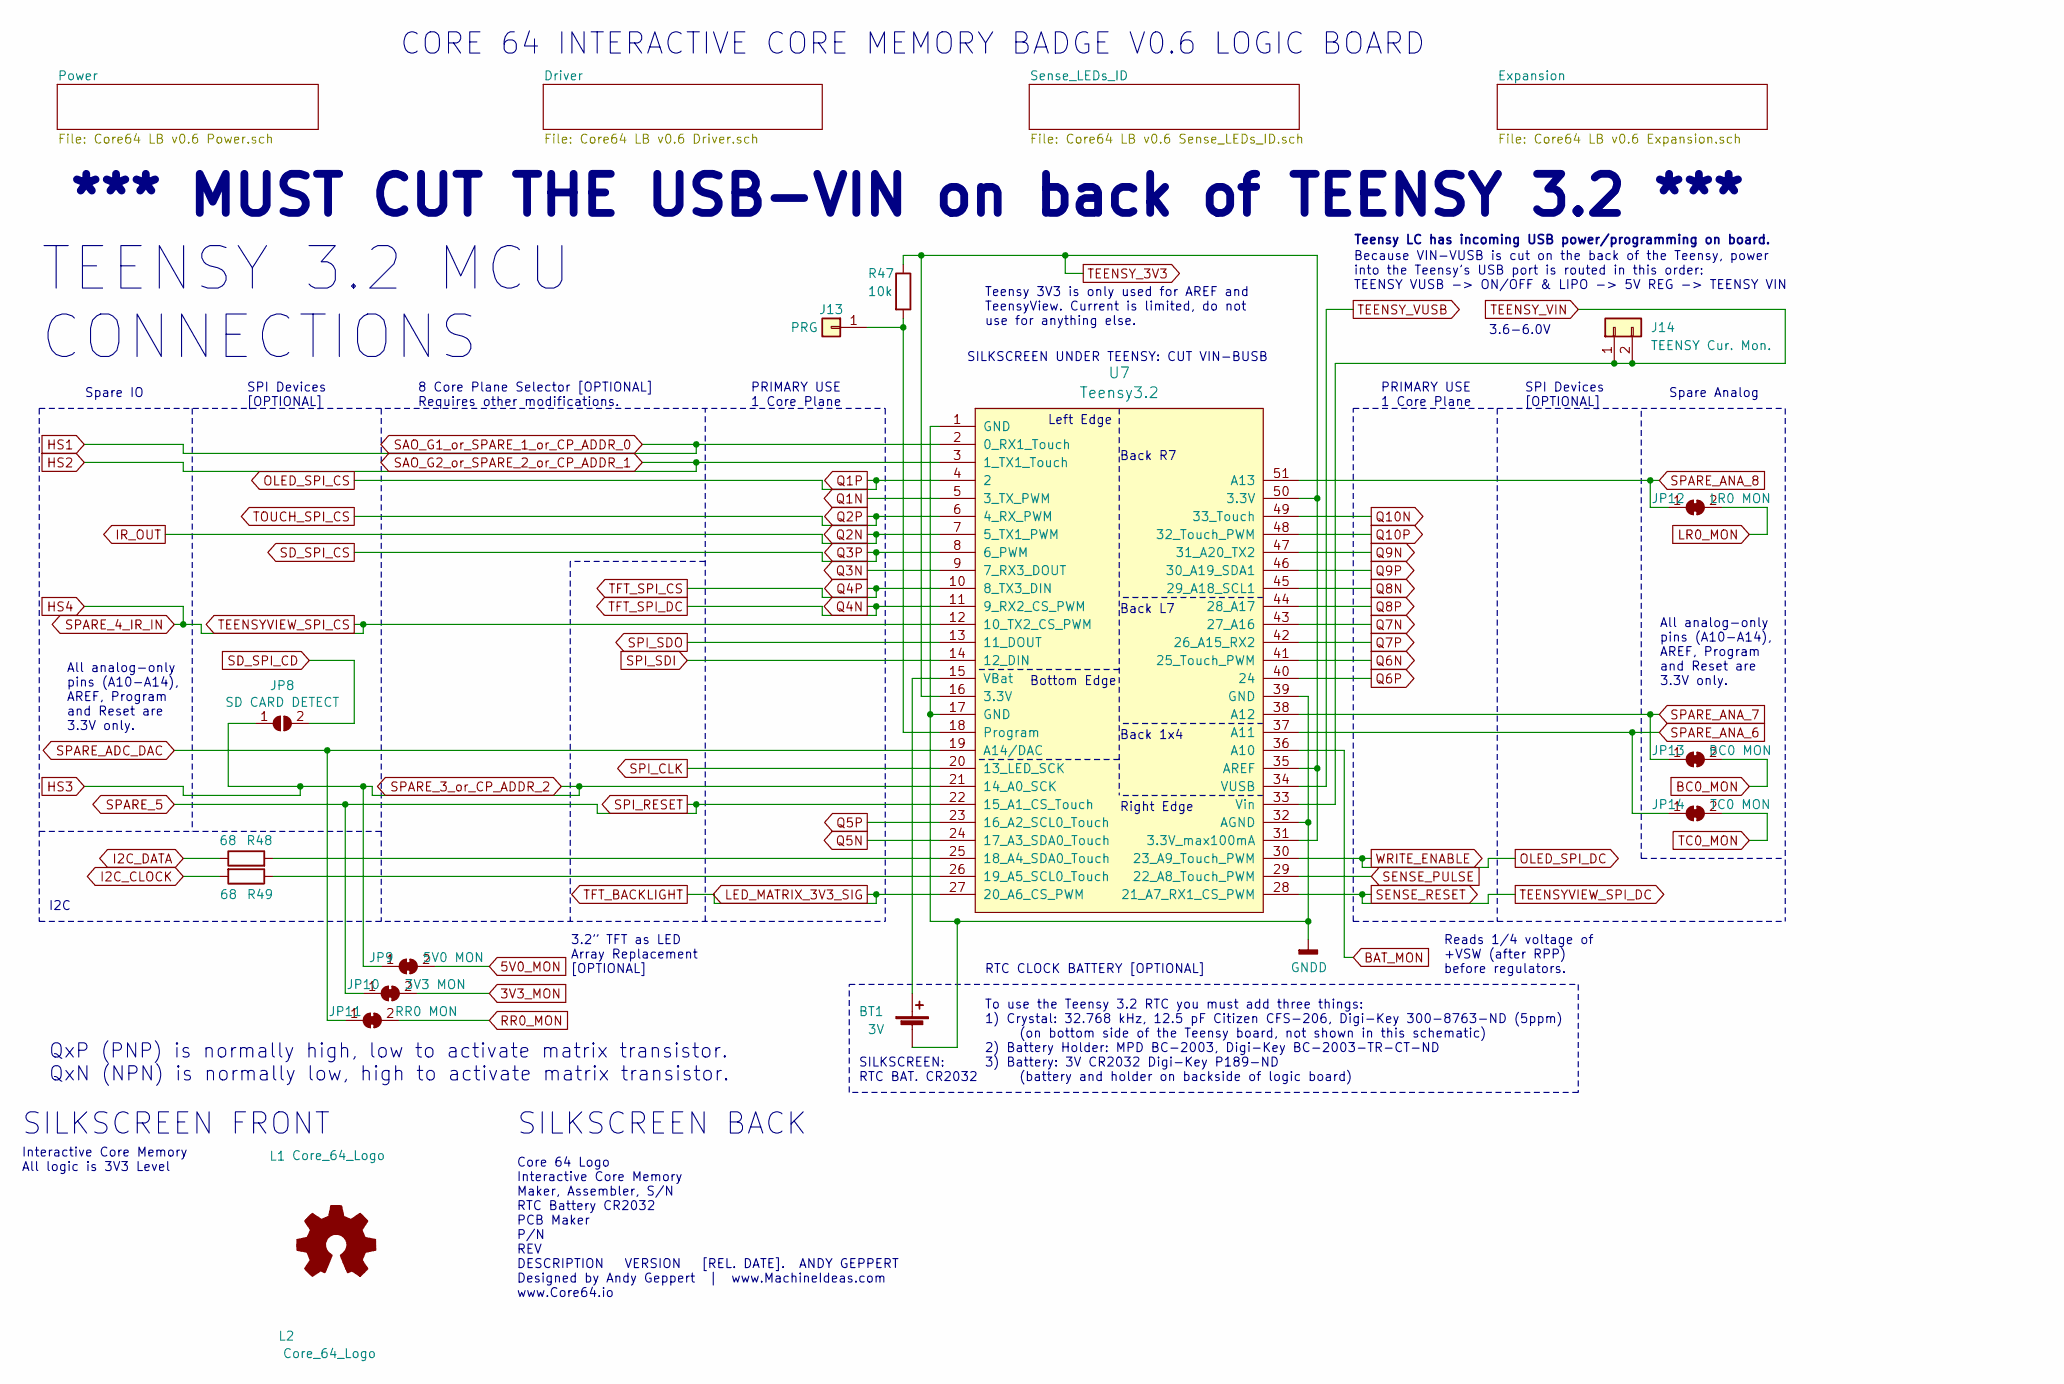
[picture p13: schematic Core64 LB v0.6.sch, Core 64 - Main Sheet Index]

Parts:
BT1: 3V; BatteryHolder_MPD_BC2003_1x2032; MPN MPD BC-2003
J13: PRG; PinSocket_1x01_P2.54mm_Vertical
J14: TEENSY Cur. Mon.; PinSocket_1x02_P2.54mm_Vertical
JP8: SD CARD DETECT; SolderJumper-2_P1.3mm_Open_RoundedPad1.0x1.5mm
JP9: 5V0 MON; SolderJumper-2_P1.3mm_Bridged_Pad1.0x1.5mm
JP10: 3V3 MON; SolderJumper-2_P1.3mm_Bridged_Pad1.0x1.5mm
JP11: RR0 MON; SolderJumper-2_P1.3mm_Bridged_Pad1.0x1.5mm
JP12: LR0 MON; SolderJumper-2_P1.3mm_Bridged_Pad1.0x1.5mm
JP13: BC0 MON; SolderJumper-2_P1.3mm_Bridged_Pad1.0x1.5mm
JP14: TC0 MON; SolderJumper-2_P1.3mm_Bridged_Pad1.0x1.5mm
L1: Core_64_Logo; Core64_Logo
L2: Core_64_Logo; Core64_Logo_9mm_tall
L4: Logo_Open_Hardware_Small; OSHW-Logo2_7.3x6mm_SilkScreen
R47: 10k; R_0805_2012Metric
R48, R49: 68; R_0805_2012Metric
U7: Teensy3.2; Teensy30_31_32_LC_SMD_SOCKETS

Connections:
3V3: JP10.2 (B); also elsewhere on the board
5V0: J14.1, J14.2, U7.33 (Vin); also elsewhere on the board
5V0_MON: JP9.2 (B); also elsewhere on the board
BAT_MON: U7.36 (A10); also elsewhere on the board
BC0_MON: JP13.2 (B); also elsewhere on the board
HS1: U7.2 (0_RX1_Touch); also elsewhere on the board
HS2: U7.3 (1_TX1_Touch); also elsewhere on the board
HS3: JP8.1 (A), JP9.1 (A), U7.21 (14_A0_SCK); also elsewhere on the board
HS4: U7.12 (10_TX2_CS_PWM); also elsewhere on the board
I2C_CLOCK: R49.2; also elsewhere on the board
I2C_DATA: R48.1; also elsewhere on the board
IR_OUT: U7.7 (5_TX1_PWM); also elsewhere on the board
LR0_MON: JP12.2 (B); also elsewhere on the board
unnamed: BT1.1 (+), U7.15 (VBat)
unnamed: J13.1, R47.2, U7.18 (Program)
unnamed: R48.2, U7.25 (18_A4_SDA0_Touch)
unnamed: R49.1, U7.26 (19_A5_SCL0_Touch)
OLED_SPI_CS: U7.4 (2); also elsewhere on the board
OLED_SPI_DC: U7.30 (23_A9_Touch_PWM); also elsewhere on the board
Q1N: U7.5 (3_TX_PWM); also elsewhere on the board
Q2P: U7.6 (4_RX_PWM); also elsewhere on the board
Q3N: U7.9 (7_RX3_DOUT); also elsewhere on the board
Q3P: U7.8 (6_PWM); also elsewhere on the board
Q4N: U7.11 (9_RX2_CS_PWM); also elsewhere on the board
Q4P: U7.10 (8_TX3_DIN); also elsewhere on the board
Q5N: U7.24 (17_A3_SDA0_Touch); also elsewhere on the board
Q5P: U7.23 (16_A2_SCL0_Touch); also elsewhere on the board
Q6N: U7.41 (25_Touch_PWM); also elsewhere on the board
Q6P: U7.40 (24); also elsewhere on the board
Q7N: U7.43 (27_A16); also elsewhere on the board
Q7P: U7.42 (26_A15_RX2); also elsewhere on the board
Q8N: U7.45 (29_A18_SCL1); also elsewhere on the board
Q8P: U7.44 (28_A17); also elsewhere on the board
Q9N: U7.47 (31_A20_TX2); also elsewhere on the board
Q9P: U7.46 (30_A19_SDA1); also elsewhere on the board
Q10N: U7.49 (33_Touch); also elsewhere on the board
Q10P: U7.48 (32_Touch_PWM); also elsewhere on the board
RR0_MON: JP11.2 (B); also elsewhere on the board
SD_SPI_CD: JP8.2 (B); also elsewhere on the board
SENSE_PULSE: U7.29 (22_A8_Touch_PWM); also elsewhere on the board
SENSE_RESET: U7.28 (21_A7_RX1_CS_PWM); also elsewhere on the board
SPARE_5: JP10.1 (A), U7.22 (15_A1_CS_Touch); also elsewhere on the board
SPARE_ADC_DAC: JP11.1 (A), U7.19 (A14/DAC); also elsewhere on the board
SPARE_ANA_6: JP14.1 (A), U7.37 (A11); also elsewhere on the board
SPARE_ANA_7: JP13.1 (A), U7.38 (A12); also elsewhere on the board
SPARE_ANA_8: JP12.1 (A), U7.51 (A13); also elsewhere on the board
SPI_CLK: U7.20 (13_LED_SCK); also elsewhere on the board
SPI_SDI: U7.14 (12_DIN); also elsewhere on the board
SPI_SDO: U7.13 (11_DOUT); also elsewhere on the board
TC0_MON: JP14.2 (B); also elsewhere on the board
TEENSY_3V3: R47.1, U7.16 (3.3V), U7.31 (3.3V_max100mA), U7.35 (AREF), U7.50 (3.3V); also elsewhere on the board
TEENSY_VUSB: U7.34 (VUSB); also elsewhere on the board

Notes on the sheet:
CORE 64 INTERACTIVE CORE MEMORY BADGE V0.6 LOGIC BOARD
Reads 1/4 voltage of +VSW (after RPP) before regulators.
Teensy LC has incoming USB power/programming on board.
TEENSY 3.2 MCU CONNECTIONS
*** MUST CUT THE USB-VIN on back of TEENSY 3.2 ***
Teensy 3V3 is only used for AREF and TeensyView. Current is limited, do not use for anything else.
PRIMARY USE 1 Core Plane
3.2” TFT as LED Array Replacement [OPTIONAL]
8 Core Plane Selector [OPTIONAL] Requires other modifications.
SILKSCREEN BACK
SILKSCREEN UNDER TEENSY: CUT VIN-BUSB
To use the Teensy 3.2 RTC you must add three things: 1) Crystal: 32.768 kHz, 12.5 pF Citizen CFS-206, Digi-Key 300-8763-ND (5ppm) (on bottom side of the Teensy board, not shown in this schematic) 2) Battery Holder: MPD BC-2003, Digi-Key BC-2003-TR-CT-ND 3) Battery: 3V CR2032 Digi-Key P189-ND (batte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
SILKSCREEN: RTC BAT. CR2032
SILKSCREEN FRONT
Core 64 Logo Interactive Core Memory Maker, Assembler, S/N RTC Battery CR2032 PCB Maker P/N REV DESCRIPTION VERSION [REL. DATE]. ANDY GEPPERT Designed by Andy Geppert | www.MachineIdeas.com www.Core64.io
Interactive Core Memory All logic is 3V3 Level
Spare Analog
Spare IO
SPI Devices [OPTIONAL]
RTC CLOCK BATTERY [OPTIONAL]
I2C
Because VIN-VUSB is cut on the back of the Teensy, power into the Teensy’s USB port is routed in this order: TEENSY VUSB -> ON/OFF & LIPO -> 5V REG -> TEENSY VIN
Left Edge
Bottom Edge
Right Edge
Back 1x4
Back L7
Back R7
QxP (PNP) is normally high, low to activate matrix transistor. QxN (NPN) is normally low, high to activate matrix transistor.
3.6-6.0V
All analog-only pins (A10-A14), AREF, Program and Reset are 3.3V only.

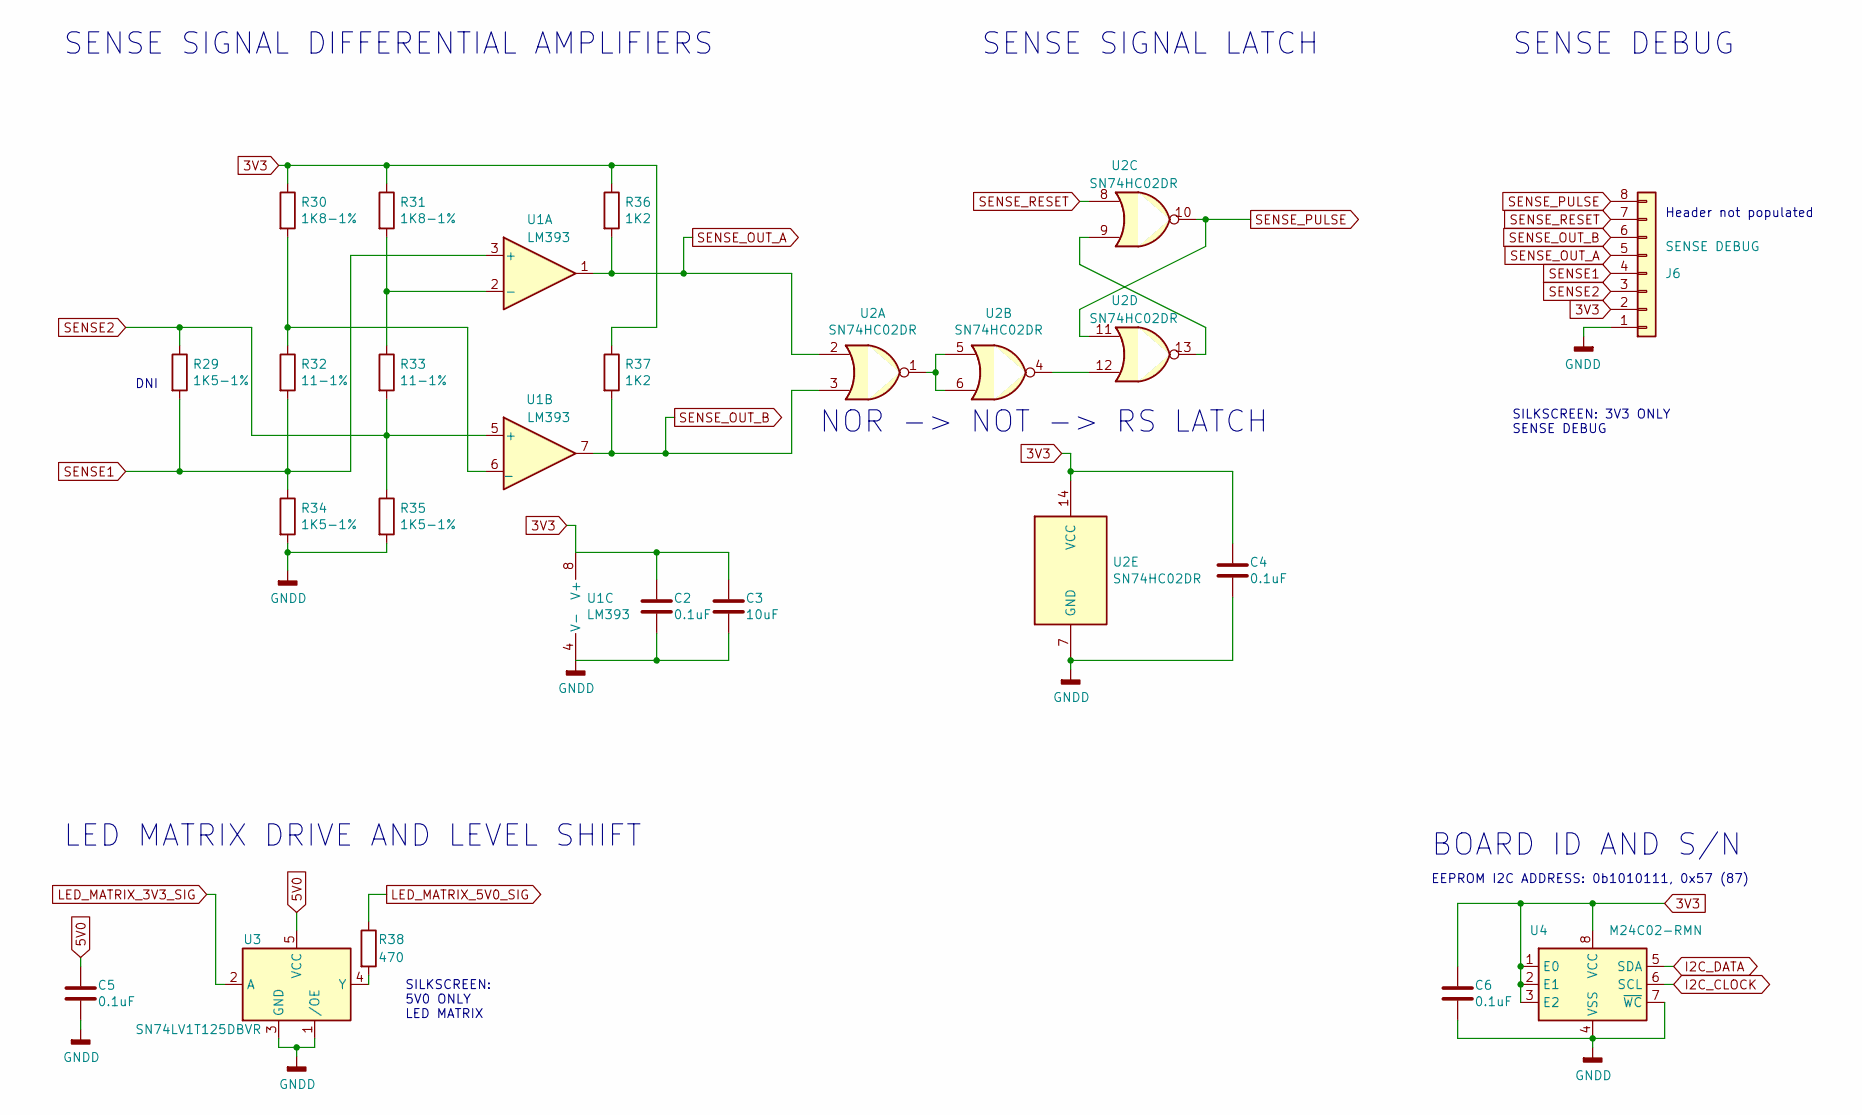
[picture p14: schematic Core64 LB v0.6 Sense_LEDs_ID.sch, Core 64 - Sense]

Parts:
C2, C4, C5, C6: 0.1uF; C_0805_2012Metric
C3: 10uF; C_0805_2012Metric
J6: SENSE DEBUG; PinSocket_1x08_P2.54mm_Vertical
R29, R34, R35: 1K5-1%; R_0805_2012Metric
R30, R31: 1K8-1%; R_0805_2012Metric
R32, R33: 11-1%; R_0805_2012Metric
R36, R37: 1K2; R_0805_2012Metric
R38: 470; R_0805_2012Metric
U1, U3: LM393; SOIC-8_W3.9mm; MPN LM393DT
U2: SN74HC02DR; SOIC-14_3.9x8.7mm_P1.27mm; MPN SN74HC02DR
U4: M24C02-RMN; SOIC-8_3.9x4.9mm_P1.27mm; MPN M24C02-WMN6TP

Connections:
3V3: C2.1, C3.1, C4.1, C6.1, J6.2, R30.1, R31.1, R36.1, R37.1, U1.8 (V+), U2.14 (VCC), U4.1 (E0), U4.2 (E1), U4.3 (E2), U4.8 (VCC); also elsewhere on the board
5V0: C5.1, U3.5 (VCC); also elsewhere on the board
I2C_CLOCK: U4.6 (SCL); also elsewhere on the board
I2C_DATA: U4.5 (SDA); also elsewhere on the board
LED_MATRIX_5V0_SIG: R38.1; also elsewhere on the board
unnamed: R30.2, R32.1, U1.6 (_)
unnamed: R38.2, U3.4 (Y)
unnamed: U2.1, U2.5, U2.6
unnamed: U2.4, U2.12
unnamed: U2.9, U2.13
SENSE2: J6.3, R29.1, R33.2, R35.1, U1.5 (+); also elsewhere on the board
SENSE_OUT_B: J6.6, R37.2, U1.7, U2.3
SENSE_PULSE: J6.8, U2.10, U2.11; also elsewhere on the board
SENSE_RESET: J6.7, U2.8; also elsewhere on the board

Notes on the sheet:
SENSE SIGNAL DIFFERENTIAL AMPLIFIERS
DNI
SENSE SIGNAL LATCH
SENSE DEBUG
SILKSCREEN: 3V3 ONLY SENSE DEBUG
NOR -> NOT -> RS LATCH
LED MATRIX DRIVE AND LEVEL SHIFT
SILKSCREEN: 5V0 ONLY LED MATRIX
BOARD ID AND S/N
EEPROM I2C ADDRESS: 0b1010111, 0x57 (87)
Header not populated

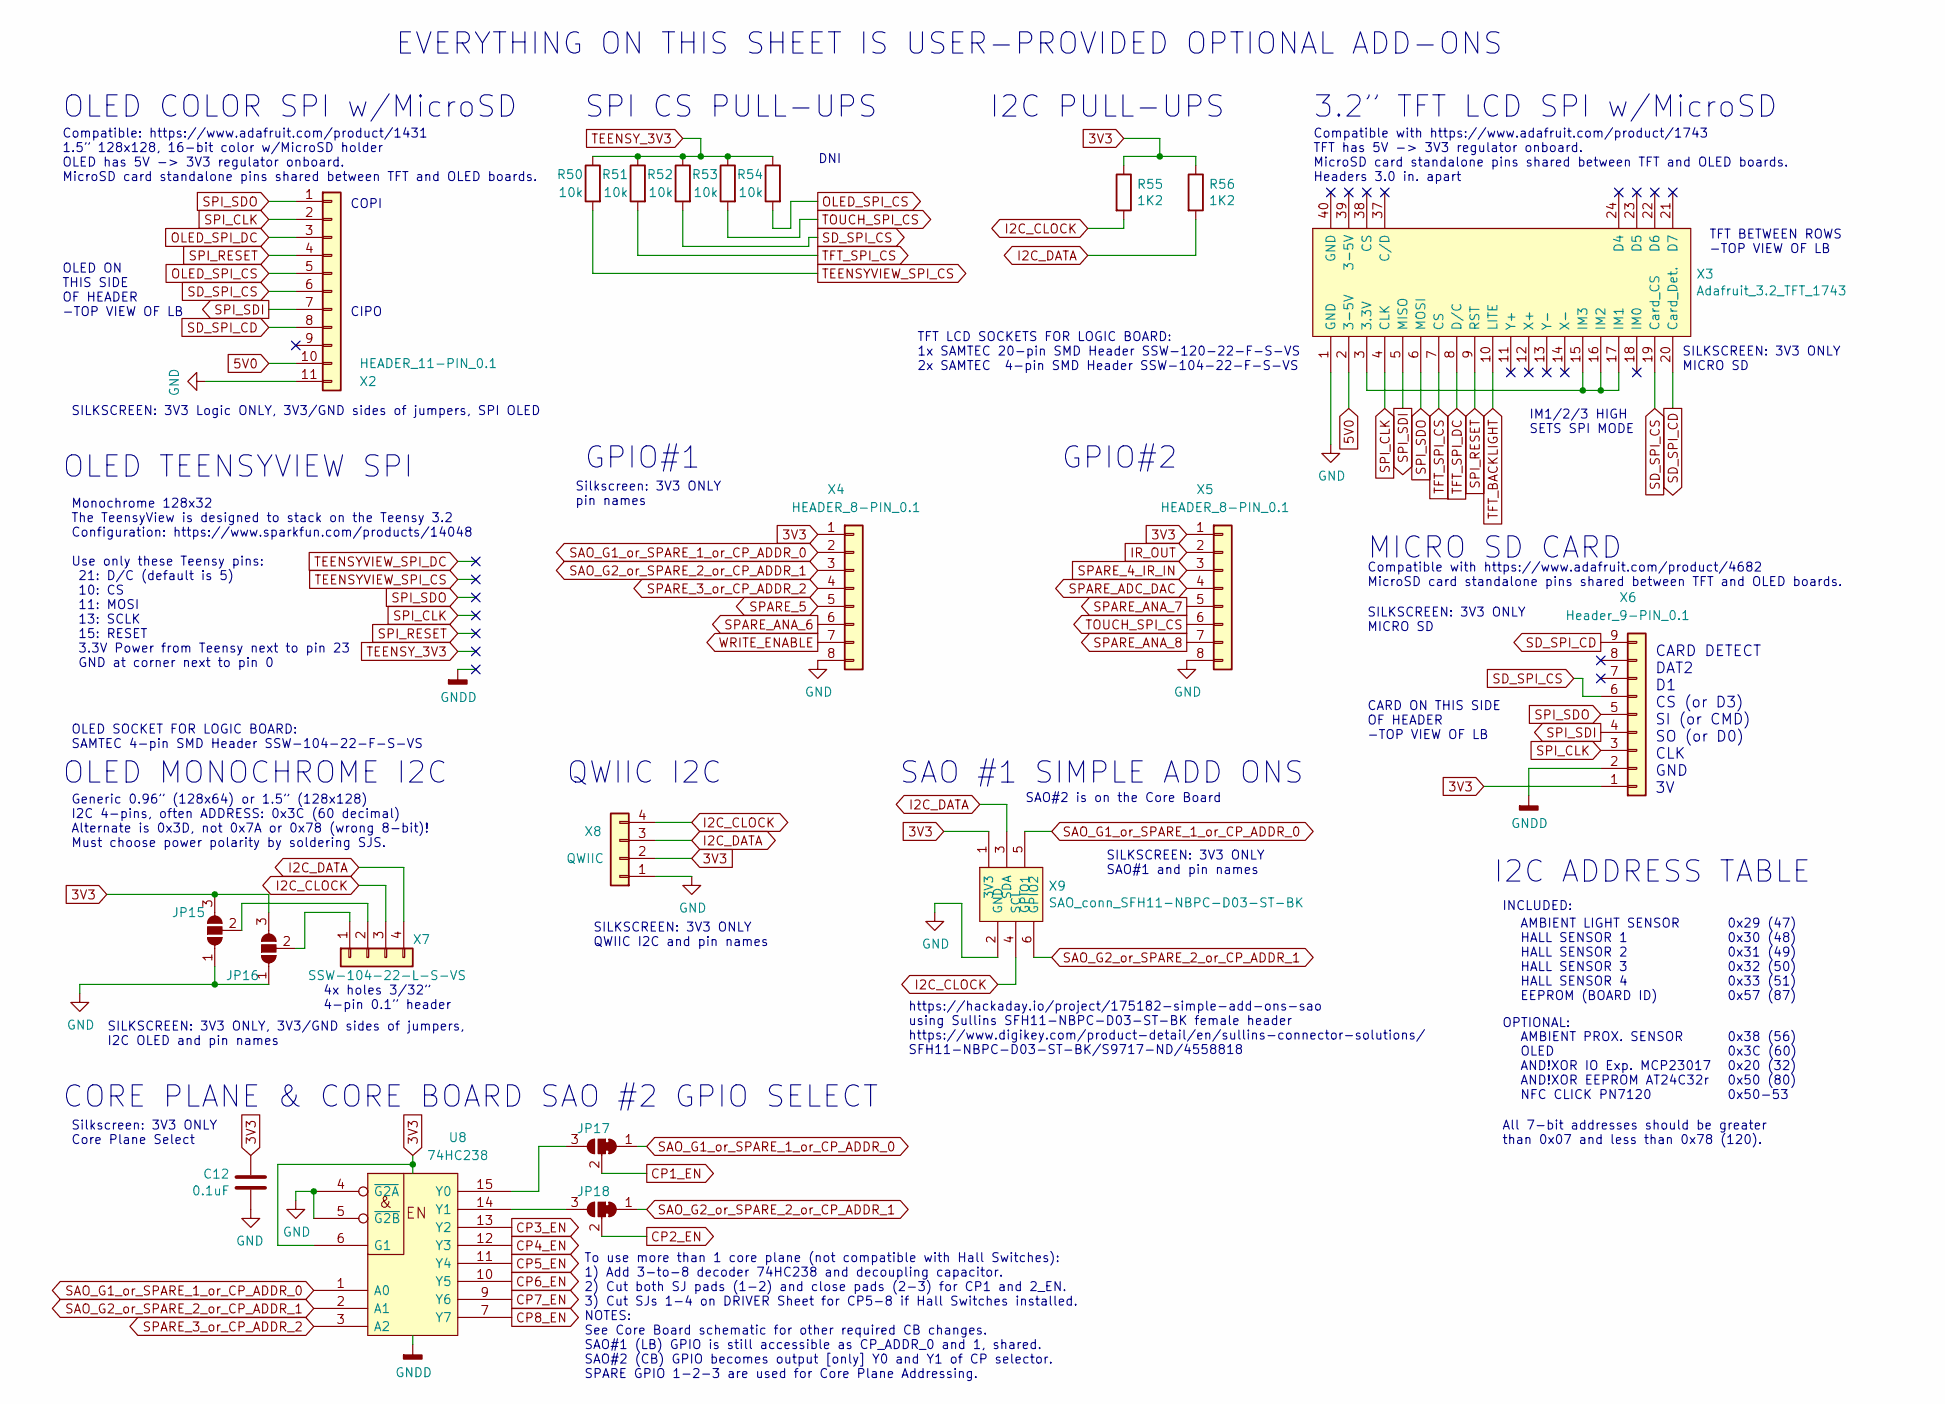
[picture p15: schematic Core64 LB v0.6 Expansion.sch, Core 64 - Expansion]

Parts:
C12: 0.1uF; C_0805_2012Metric
JP15, JP16: SolderJumper_3_Open; SolderJumper-3_P1.3mm_Open_Pad1.0x1.5mm_NumberLabels
JP17, JP18: SolderJumper_3_Open; SolderJumper-3_P1.3mm_Bridged12_RoundedPad1.0x1.5mm_NumberL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
R50, R51, R52, R53, R54: 10k; R_0805_2012Metric
R55, R56: 1K2; R_0805_2012Metric
U8: 74HC238; TSSOP-16-W4.40mm
X2: HEADER_11-PIN_0.1; PinSocket_1x11_P2.54mm_Vertical
X3: Adafruit_3.2_TFT_1743; Adafruit_3.2_TFT_Dual_PinHeader_1x20_P2.54mm_Vertical_SMD_P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; Manufacturer_Part_Number MIKROE-971; Mouser Part Number 932-MIKROE-971
X4, X5: HEADER_8-PIN_0.1; PinSocket_1x08_P2.54mm_Vertical
X6: Header_9-PIN_0.1; PinSocket_1x09_P2.54mm_Vertical
X7: SSW-104-22-L-S-VS; PinSocket_1x04_P2.54mm_Vertical_SMD_and_TH_Pin1Left
X8: QWIIC; JST_SH_SM04B-SRSS-TB_1x04-1MP_P1.00mm_Horizontal; MPN SM04B-SRSS-TB(LF)(SN)
X9: SAO_conn_SFH11-NBPC-D03-ST-BK; Badgelife-SAOv169-BADGE-2x3; MPN SFH11-NBPC-D03-ST-BK

Connections:
3V3: C12.1, JP15.3 (B), JP16.3 (B), R55.1, R56.1, U8.6 (G1), U8.16 (VCC), X4.1, X5.1, X6.1, X8.2, X9.1 (3V3); also elsewhere on the board
5V0: X2.10, X3.2 (3-5V); also elsewhere on the board
CP1_EN: JP17.2 (C); also elsewhere on the board
CP2_EN: JP18.2 (C); also elsewhere on the board
CP3_EN: U8.13 (Y2); also elsewhere on the board
CP4_EN: U8.12 (Y3); also elsewhere on the board
CP5_EN: U8.11 (Y4); also elsewhere on the board
CP6_EN: U8.10 (Y5); also elsewhere on the board
CP7_EN: U8.9 (Y6); also elsewhere on the board
CP8_EN: U8.7 (Y7); also elsewhere on the board
HS1: JP17.1 (A), U8.1 (A0), X4.2, X9.5 (GPIO1); also elsewhere on the board
HS2: JP18.1 (A), U8.2 (A1), X4.3, X9.6 (GPIO2); also elsewhere on the board
HS3: U8.3 (A2), X4.4; also elsewhere on the board
HS4: R50.2, X5.3; also elsewhere on the board
I2C_CLOCK: R55.2, X7.3, X8.4, X9.4 (SCL); also elsewhere on the board
I2C_DATA: R56.2, X7.4, X8.3, X9.3 (SDA); also elsewhere on the board
IR_OUT: X5.2; also elsewhere on the board
unnamed: JP15.2 (C), X7.2
unnamed: JP16.2 (C), X7.1
unnamed: JP17.3 (B), U8.15 (Y0)
unnamed: JP18.3 (B), U8.14 (Y1)
unnamed: X3.3 (3.3V), X3.15 (IM3), X3.16 (IM2), X3.17 (IM1)
OLED_SPI_CS: R54.2, X2.5; also elsewhere on the board
OLED_SPI_DC: X2.3, X4.7; also elsewhere on the board
Q2P: R53.2, X5.6; also elsewhere on the board
Q3P: R52.2, X2.6, X3.19 (Card_CS), X6.6; also elsewhere on the board
Q4N: X3.8 (D/C); also elsewhere on the board
Q4P: R51.2, X3.7 (CS); also elsewhere on the board
SD_SPI_CD: X2.8, X3.20 (Card_Det.), X6.9; also elsewhere on the board
SPARE_5: X2.4, X3.9 (RST), X4.5; also elsewhere on the board
SPARE_ADC_DAC: X5.4; also elsewhere on the board
SPARE_ANA_6: X4.6; also elsewhere on the board
SPARE_ANA_7: X5.5; also elsewhere on the board
SPARE_ANA_8: X5.7; also elsewhere on the board
SPI_CLK: X2.2, X3.4 (CLK), X6.3; also elsewhere on the board
SPI_SDI: X2.7, X3.5 (MISO), X6.4; also elsewhere on the board
SPI_SDO: X2.1, X3.6 (MOSI), X6.5; also elsewhere on the board
TEENSY_3V3: R50.1, R51.1, R52.1, R53.1, R54.1; also elsewhere on the board

Notes on the sheet:
CORE PLANE & CORE BOARD SAO #2 GPIO SELECT
SAO #1 SIMPLE ADD ONS
OLED MONOCHROME I2C
Generic 0.96” (128x64) or 1.5” (128x128) I2C 4-pins, often ADDRESS: 0x3C (60 decimal) Alternate is 0x3D, not 0x7A or 0x78 (wrong 8-bit)! Must choose power polarity by soldering SJS.
https://hackaday.io/project/175182-simple-add-ons-sao using Sullins SFH11-NBPC-D03-ST-BK female header https://www.digikey.com/product-detail/en/sullins-connector-solutions/ SFH11-NBPC-D03-ST-BK/S9717-ND/4558818
QWIIC I2C
MICRO SD CARD
Compatible with https://www.adafruit.com/product/4682 MicroSD card standalone pins shared between TFT and OLED boards.
SILKSCREEN: 3V3 ONLY, 3V3/GND sides of jumpers, I2C OLED and pin names
SILKSCREEN: 3V3 ONLY SAO#1 and pin names
Silkscreen: 3V3 ONLY pin names
OLED COLOR SPI w/MicroSD
3.2” TFT LCD SPI w/MicroSD
GPIO#1
EVERYTHING ON THIS SHEET IS USER-PROVIDED OPTIONAL ADD-ONS
To use more than 1 core plane (not compatible with Hall Switches): 1) Add 3-to-8 decoder 74HC238 and decoupling capacitor. 2) Cut both SJ pads (1-2) and close pads (2-3) for CP1 and 2_EN. 3) Cut SJs 1-4 on DRIVER Sheet for CP5-8 if Hall Switches installed. NOTES: See Core Board schematic for other 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
Silkscreen: 3V3 ONLY Core Plane Select
4x holes 3/32” 4-pin 0.1” header
SILKSCREEN: 3V3 ONLY QWIIC I2C and pin names
SILKSCREEN: 3V3 Logic ONLY, 3V3/GND sides of jumpers, SPI OLED
SILKSCREEN: 3V3 ONLY MICRO SD
SAO#2 is on the Core Board
CARD ON THIS SIDE OF HEADER -TOP VIEW OF LB
GPIO#2
Compatible with https://www.adafruit.com/product/1743 TFT has 5V -> 3V3 regulator onboard. MicroSD card standalone pins shared between TFT and OLED boards. Headers 3.0 in. apart
All 7-bit addresses should be greater than 0x07 and less than 0x78 (120).
AMBIENT LIGHT SENSOR HALL SENSOR 1 HALL SENSOR 2 HALL SENSOR 3 HALL SENSOR 4 EEPROM (BOARD ID)
0x29 (47) 0x30 (48) 0x31 (49) 0x32 (50) 0x33 (51) 0x57 (87)
INCLUDED:
OPTIONAL:
AMBIENT PROX. SENSOR OLED AND!XOR IO Exp. MCP23017 AND!XOR EEPROM AT24C32r NFC CLICK PN7120
0x38 (56) 0x3C (60) 0x20 (32) 0x50 (80) 0x50-53
I2C ADDRESS TABLE
OLED TEENSYVIEW SPI
Monochrome 128x32 The TeensyView is designed to stack on the Teensy 3.2 Configuration: https://www.sparkfun.com/products/14048 Use only these Teensy pins: 21: D/C (default is 5) 10: CS 11: MOSI 13: SCLK 15: RESET 3.3V Power from Teensy next to pin 23 GND at corner next to pin 0
Compatible: https://www.adafruit.com/product/1431 1.5” 128x128, 16-bit color w/MicroSD holder OLED has 5V -> 3V3 regulator onboard. MicroSD card standalone pins shared between TFT and OLED boards.
OLED ON THIS SIDE OF HEADER -TOP VIEW OF LB
I2C PULL-UPS
SPI CS PULL-UPS
DNI
COPI
CIPO
TFT BETWEEN ROWS -TOP VIEW OF LB
IM1/2/3 HIGH SETS SPI MODE
CARD DETECT DAT2 D1 CS (or D3) SI (or CMD) SO (or D0) CLK GND 3V
TFT LCD SOCKETS FOR LOGIC BOARD: 1x SAMTEC 20-pin SMD Header SSW-120-22-F-S-VS 2x SAMTEC 4-pin SMD Header SSW-104-22-F-S-VS
OLED SOCKET FOR LOGIC BOARD: SAMTEC 4-pin SMD Header SSW-104-22-F-S-VS

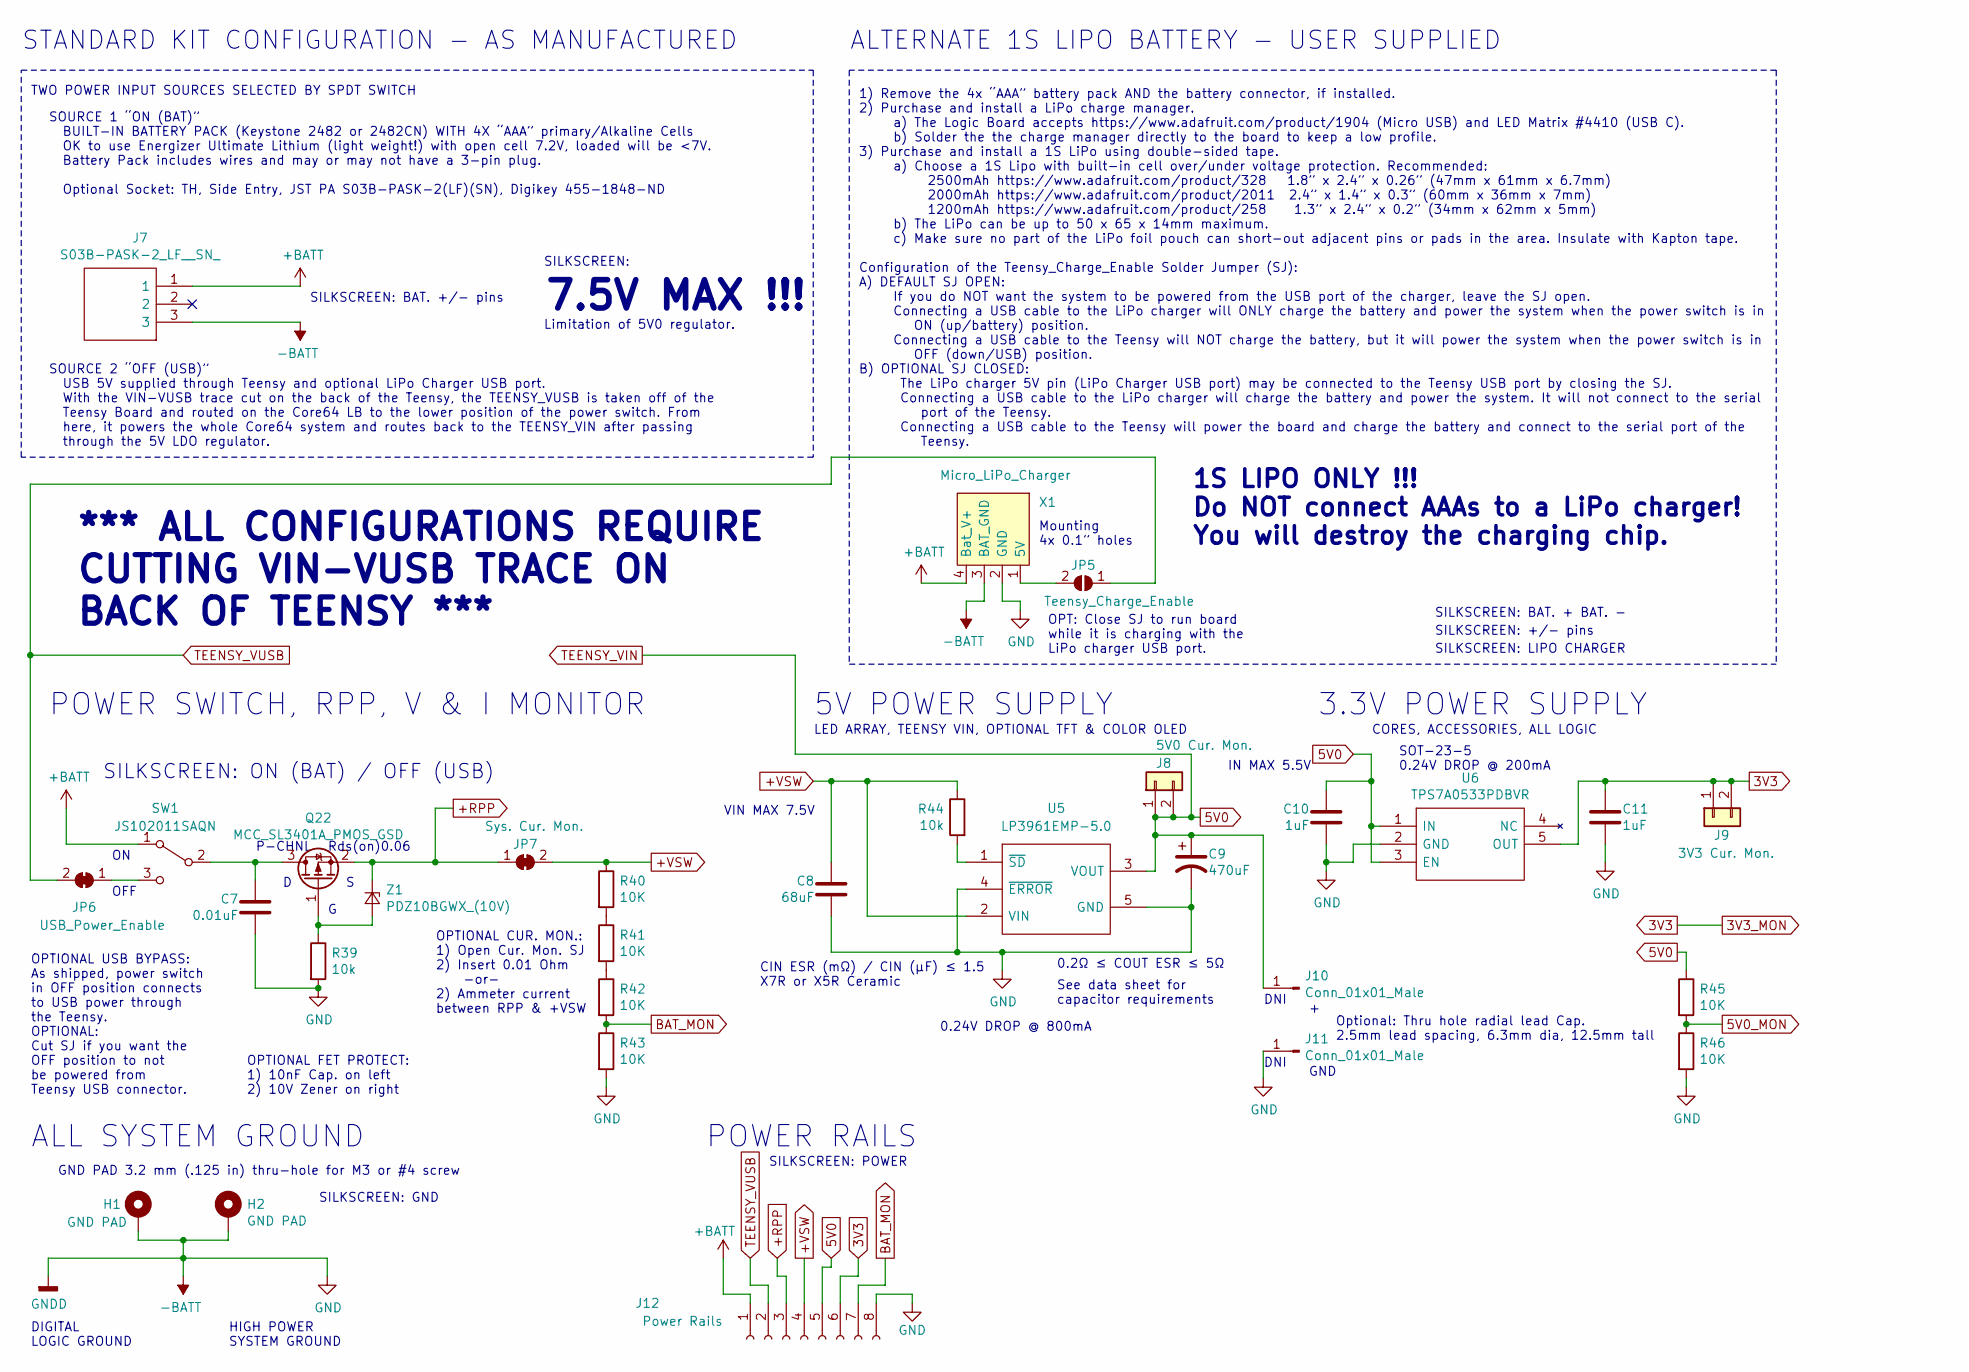
[picture p16: schematic Core64 LB v0.6 Power.sch, Core 64 - Power Schematic]

Parts:
C7: 0.01uF; C_0805_2012Metric
C8: 68uF; C_1206_3216Metric; MPN C3216X5R1A686M160AC
C9: 470uF; CP_Elec_6.3x7.7; MPN(Secondary) 6.3SEV330M6.3X8; Digikey 565-EMHL100ARA471MHA0GCT-ND
C10, C11: 1uF; C_0805_2012Metric
H1, H2: GND PAD; MountingHole_3.2mm_M3_Pad_Via
J7: S03B-PASK-2_LF__SN_; S03BPASK2LFSN_.075in_holes; Manufacturer_Part_Number S03B-PASK-2(LF)(SN)
J8: 5V0 Cur. Mon.; PinSocket_1x02_P2.54mm_Vertical
J9: 3V3 Cur. Mon.; PinSocket_1x02_P2.54mm_Vertical; MPN SN74HC02DR
J10, J11: Conn_01x01_Male; PinHeader_1x01_P2.54mm_Vertical_No_Registration
J12: Power Rails; PinSocket_1x08_P2.54mm_Vertical
JP5: Teensy_Charge_Enable; SolderJumper-2_P1.3mm_Open_RoundedPad1.0x1.5mm
JP6: USB_Power_Enable; SolderJumper-2_P1.3mm_Bridged_RoundedPad1.0x1.5mm
JP7: Sys. Cur. Mon.; SolderJumper-2_P1.3mm_Bridged_Pad1.0x1.5mm
Q22: MCC_SL3401A_PMOS_GSD; SOT-23-3; MPN SL3401A-TP
R39, R44: 10k; R_0805_2012Metric
R40, R41, R42, R43, R45, R46: 10K; R_0805_2012Metric
SW1: JS102011SAQN; SW_SPDT_CK-JS102011SAQN_Core64_Recessed; MPN JS102011SAQN
U5: LP3961EMP-5.0; SOT150P696X180-5N; Manufacturer_Part_Number LP3961EMP-5.0; Mouser Part Number 926-LP3961EMP-50
U6: TPS7A0533PDBVR; SOT95P280X145-5N; Manufacturer_Part_Number TPS7A0533PDBVR; Mouser Part Number 595-TPS7A0533PDBVR
X1: Micro_LiPo_Charger; Micro_LiPo_Charger_CornerSMD
Z1: PDZ10BGWX_(10V); SOD-123

Connections:
3V3: C11.1, J9.1, J9.2, J12.6, U6.5 (OUT); also elsewhere on the board
5V0: C9.1, C10.1, J8.1, J8.2, J10.1, J12.5, R45.1, U5.3 (VOUT), U6.1 (IN), U6.3 (EN); also elsewhere on the board
5V0_MON: R45.2, R46.1; also elsewhere on the board
+BATT: J7.1, J12.1, SW1.1 (A), X1.4 (Bat_V+); also elsewhere on the board
+RPP: J12.3, JP7.1 (A), Q22.2 (S), Z1.1 (K)
+VSW: C8.1, J12.4, JP7.2 (B), R40.1, R44.1, U5.2 (VIN)
BAT_MON: J12.7, R42.2, R43.1; also elsewhere on the board
unnamed: C7.1, Q22.3 (D), SW1.2 (B)
unnamed: JP5.2 (B), X1.1 (5V)
unnamed: JP6.1 (A), SW1.3 (C)
unnamed: Q22.1 (G), R39.1, Z1.2 (A)
unnamed: R40.2, R41.1
unnamed: R41.2, R42.1
unnamed: R44.2, U5.1 (~SD)
TEENSY_VUSB: J12.2, JP5.1 (A), JP6.2 (B); also elsewhere on the board

Notes on the sheet:
CORES, ACCESSORIES, ALL LOGIC
SOURCE 1 “ON (BAT)” BUILT-IN BATTERY PACK (Keystone 2482 or 2482CN) WITH 4X “AAA” primary/Alkaline Cells OK to use Energizer Ultimate Lithium (light weight!) with open cell 7.2V, loaded will be <7V. Battery Pack includes wires and may or may not have a 3-pin plug. Optional Socket: TH, Side Entry, J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
SOURCE 2 “OFF (USB)” USB 5V supplied through Teensy and optional LiPo Charger USB port. With the VIN-VUSB trace cut on the back of the Teensy, the TEENSY_VUSB is taken off of the Teensy Board and routed on the Core64 LB to the lower position of the power switch. From here, it powers the whole Core6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
TWO POWER INPUT SOURCES SELECTED BY SPDT SWITCH
STANDARD KIT CONFIGURATION - AS MANUFACTURED
ALTERNATE 1S LIPO BATTERY - USER SUPPLIED
POWER SWITCH, RPP, V & I MONITOR
3.3V POWER SUPPLY
LED ARRAY, TEENSY VIN, OPTIONAL TFT & COLOR OLED
ALL SYSTEM GROUND
POWER RAILS
HIGH POWER SYSTEM GROUND
DIGITAL LOGIC GROUND
OPTIONAL USB BYPASS: As shipped, power switch in OFF position connects to USB power through the Teensy. OPTIONAL: Cut SJ if you want the OFF position to not be powered from Teensy USB connector.
SILKSCREEN: ON (BAT) / OFF (USB)
7.5V MAX !!!
SILKSCREEN: BAT. +/- pins
OPTIONAL CUR. MON.: 1) Open Cur. Mon. SJ 2) Insert 0.01 Ohm -or- 2) Ammeter current between RPP & +VSW
5V POWER SUPPLY
P-CHNL
*** ALL CONFIGURATIONS REQUIRE CUTTING VIN-VUSB TRACE ON BACK OF TEENSY ***
1S LIPO ONLY !!! Do NOT connect AAAs to a LiPo charger! You will destroy the charging chip.
OPTIONAL FET PROTECT: 1) 10nF Cap. on left 2) 10V Zener on right
SILKSCREEN: +/- pins
1) Remove the 4x “AAA” battery pack AND the battery connector, if installed. 2) Purchase and install a LiPo charge manager. a) The Logic Board accepts https://www.adafruit.com/product/1904 (Micro USB) and LED Matrix #4410 (USB C). b) Solder the the charge manager directly to the board to keep a low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
OPT: Close SJ to run board while it is charging with the LiPo charger USB port.
SOT-23-5 0.24V DROP @ 200mA
CIN ESR (mΩ) / CIN (μF) ≤ 1.5 X7R or X5R Ceramic
0.2Ω ≤ COUT ESR ≤ 5Ω
See data sheet for capacitor requirements
GND PAD 3.2 mm (.125 in) thru-hole for M3 or #4 screw
SILKSCREEN: GND
SILKSCREEN: LIPO CHARGER
SILKSCREEN: BAT. + BAT. -
SILKSCREEN: POWER
Mounting 4x 0.1” holes
SILKSCREEN:
Limitation of 5V0 regulator.
OFF
Rds(on)0.06
VIN MAX 7.5V
0.24V DROP @ 800mA
IN MAX 5.5V
GND
DNI
Optional: Thru hole radial lead Cap. 2.5mm lead spacing, 6.3mm dia, 12.5mm tall
