ageppert/Core-64-Interactive-Core-Memory-Badge/Electronic Design/Core64 LB v0.6/Core64 LB v0.6.kicad_pcb

## KiCad design Electronic Design/Core64 LB v0.6/Core64 LB v0.6.kicad_pcb (continued)

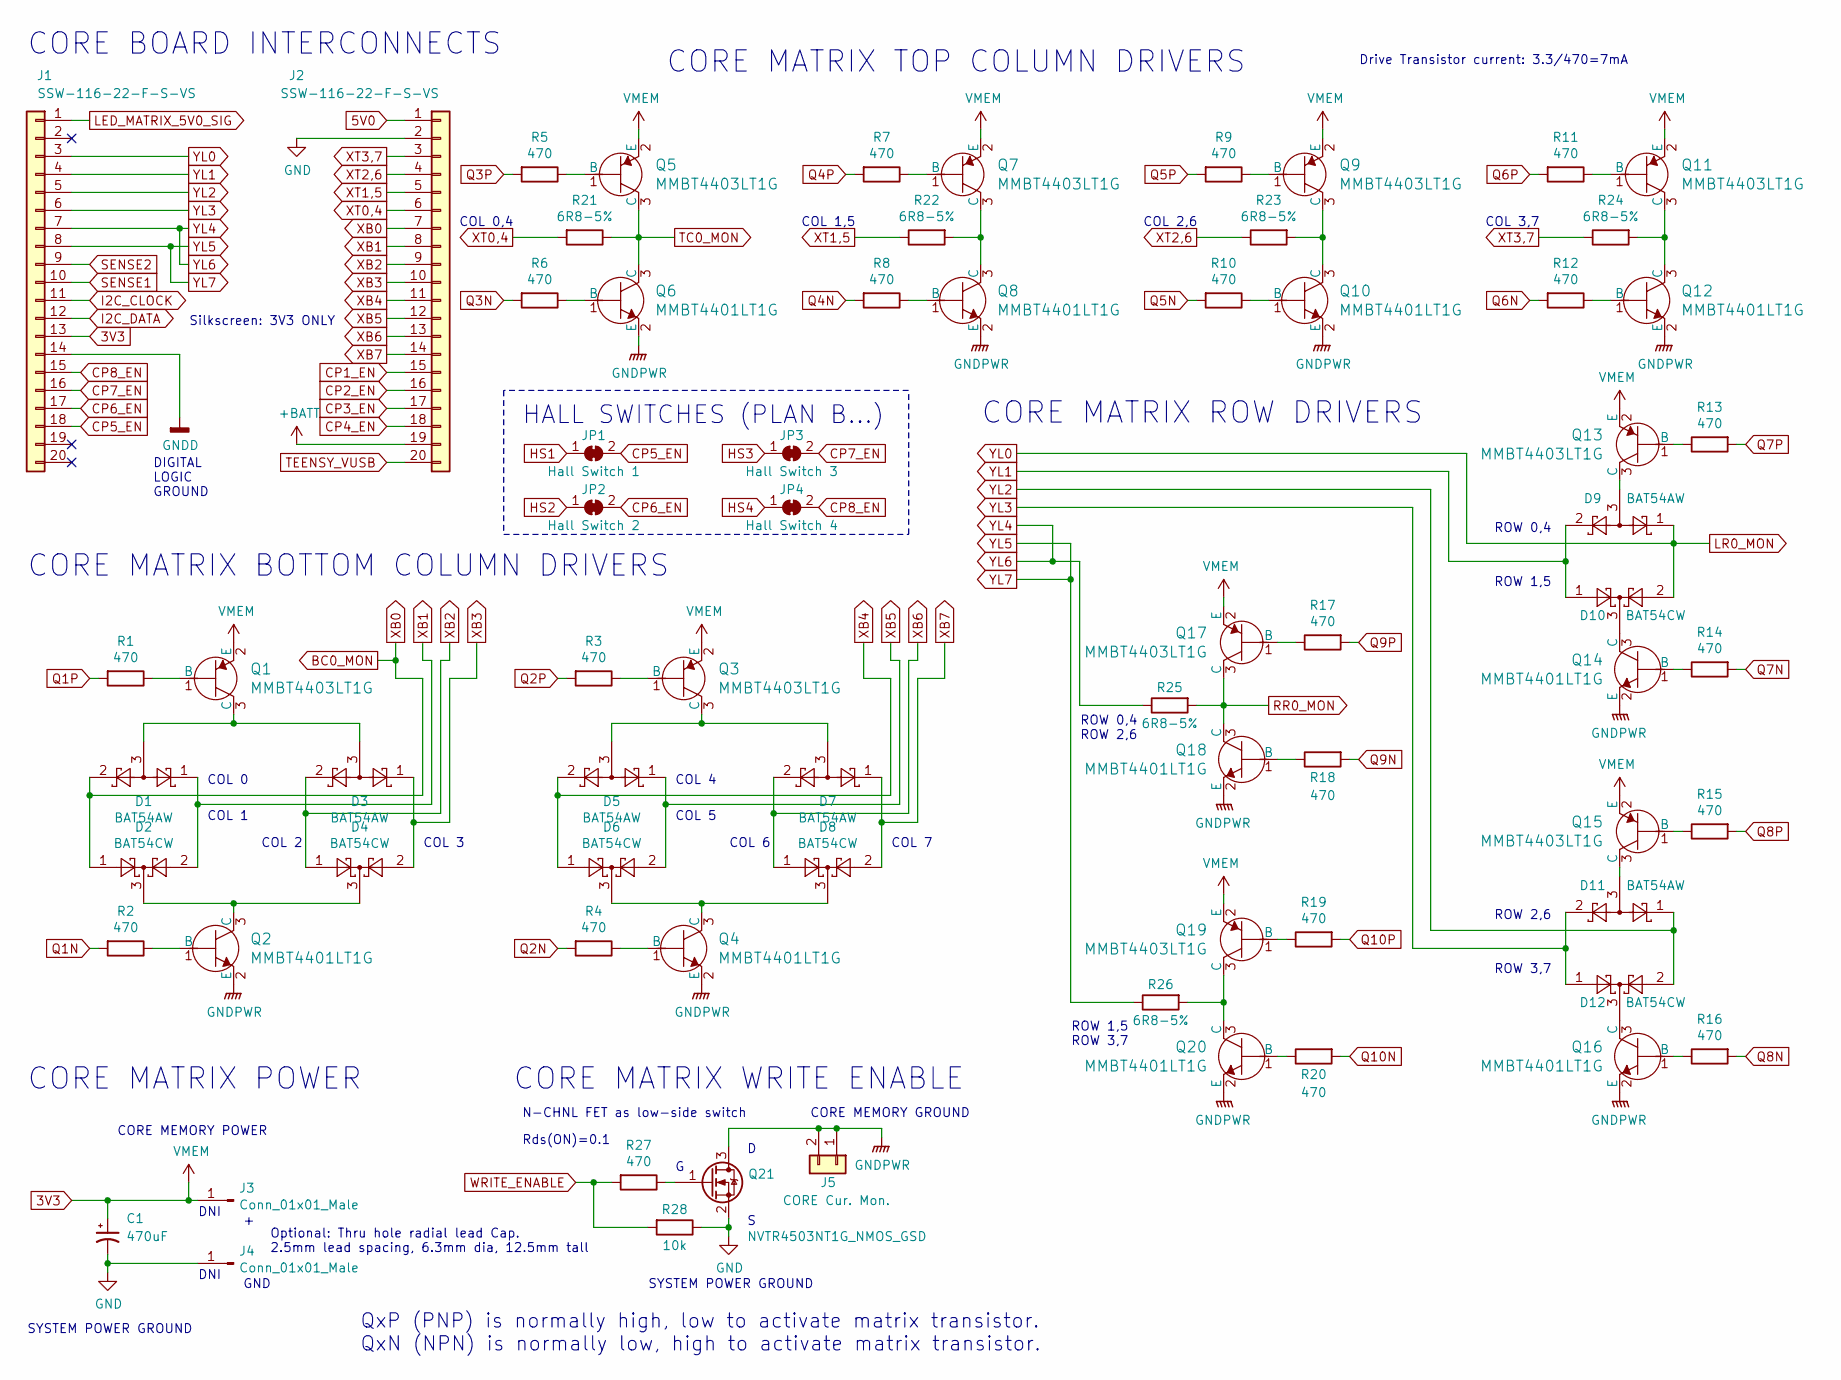
[picture p17: schematic Core64 LB v0.6 Driver.sch, Core 64 - Core Matrix Driver]

Parts:
C1: 470uF; CP_Elec_6.3x7.7; MPN(Secondary) 6.3SEV330M6.3X8; Digikey 565-EMHL100ARA471MHA0GCT-ND
D1, D3, D5, D7, D9, D11: BAT54AW; SOT-323_SC-70; MPN BAT54AW-7-F
D2, D4, D6, D8, D10, D12: BAT54CW; SOT-323_SC-70; MPN BAT54CW-7-F
J1, J2: SSW-116-22-F-S-VS‎; PinSocket_1x20_P2.54mm_Vertical
J3, J4: Conn_01x01_Male; PinHeader_1x01_P2.54mm_Vertical_No_Registration
J5: CORE Cur. Mon.; PinSocket_1x02_P2.54mm_Vertical
JP1: Hall Switch 1; SolderJumper-2_P1.3mm_Bridged_RoundedPad1.0x1.5mm
JP2: Hall Switch 2; SolderJumper-2_P1.3mm_Bridged_RoundedPad1.0x1.5mm
JP3: Hall Switch 3; SolderJumper-2_P1.3mm_Bridged_RoundedPad1.0x1.5mm
JP4: Hall Switch 4; SolderJumper-2_P1.3mm_Bridged_RoundedPad1.0x1.5mm
Q1, Q3, Q5, Q7, Q9, Q11, Q13, Q15, Q17, Q19: MMBT4403LT1G; SOT-23-3; MPN MMBT4403LT1G; Digi-Key_PN MMBT4403LT1GOSCT-ND
Q2, Q4, Q6, Q8, Q10, Q12, Q14, Q16, Q18, Q20: MMBT4401LT1G; SOT-23-3; MPN MMBT4401LT1G; Digi-Key_PN MMBT4401LT1GOSCT-ND
Q21: NVTR4503NT1G_NMOS_GSD; SOT-23-3; MPN NVTR4503NT1G
R1, R2, R3, R4, R5, R6, R7, R8, R9, R10, R11, R12, R13, R14, R15, R16, R17, R18, R19, R20, R27: 470; R_0805_2012Metric
R21, R22, R23, R24, R25, R26: 6R8-5%; R_0805_2012Metric
R28: 10k; R_0805_2012Metric

Connections:
3V3: C1.1, J1.13, J3.1, Q1.2 (E), Q3.2 (E), Q5.2 (E), Q7.2 (E), Q9.2 (E), Q11.2 (E), Q13.2 (E), Q15.2 (E), Q17.2 (E), Q19.2 (E); also elsewhere on the board
5V0: J2.1; also elsewhere on the board
+BATT: J2.19; also elsewhere on the board
BC0_MON: D1.2, D2.1, J2.7; also elsewhere on the board
CP1_EN: J2.15; also elsewhere on the board
CP2_EN: J2.16; also elsewhere on the board
CP3_EN: J2.17; also elsewhere on the board
CP4_EN: J2.18; also elsewhere on the board
CP5_EN: J1.18, JP1.2 (B); also elsewhere on the board
CP6_EN: J1.17, JP2.2 (B); also elsewhere on the board
CP7_EN: J1.16, JP3.2 (B); also elsewhere on the board
CP8_EN: J1.15, JP4.2 (B); also elsewhere on the board
GNDPWR: J5.1, J5.2, Q2.2 (E), Q4.2 (E), Q6.2 (E), Q8.2 (E), Q10.2 (E), Q12.2 (E), Q14.2 (E), Q16.2 (E), Q18.2 (E), Q20.2 (E), Q21.3 (D)
HS1: JP1.1 (A); also elsewhere on the board
HS2: JP2.1 (A); also elsewhere on the board
HS3: JP3.1 (A); also elsewhere on the board
HS4: JP4.1 (A); also elsewhere on the board
I2C_CLOCK: J1.11; also elsewhere on the board
I2C_DATA: J1.12; also elsewhere on the board
IR_OUT: R4.2; also elsewhere on the board
LED_MATRIX_5V0_SIG: J1.1; also elsewhere on the board
LR0_MON: D9.1, D10.2, J1.3; also elsewhere on the board
unnamed: D1.3, D3.3, Q1.3 (C)
unnamed: D2.3, D4.3, Q2.3 (C)
unnamed: D5.3, D7.3, Q3.3 (C)
unnamed: D6.3, D8.3, Q4.3 (C)
unnamed: D9.3, Q13.3 (C)
unnamed: D10.3, Q14.3 (C)
unnamed: D11.3, Q15.3 (C)
unnamed: D12.3, Q16.3 (C)
unnamed: Q1.1 (B), R1.1
unnamed: Q2.1 (B), R2.1
unnamed: Q3.1 (B), R3.1
unnamed: Q4.1 (B), R4.1
unnamed: Q5.1 (B), R5.1
unnamed: Q6.1 (B), R6.1
unnamed: Q7.1 (B), R7.1
unnamed: Q7.3 (C), Q8.3 (C), R22.2
unnamed: Q8.1 (B), R8.1
unnamed: Q9.1 (B), R9.1
unnamed: Q10.1 (B), R10.1
unnamed: Q9.3 (C), Q10.3 (C), R23.2
unnamed: Q11.1 (B), R11.1
unnamed: Q11.3 (C), Q12.3 (C), R24.2
unnamed: Q12.1 (B), R12.1
unnamed: Q13.1 (B), R13.1
unnamed: Q14.1 (B), R14.1
unnamed: Q15.1 (B), R15.1
unnamed: Q16.1 (B), R16.1
unnamed: Q17.1 (B), R17.1
unnamed: Q18.1 (B), R18.1
unnamed: Q19.1 (B), R19.1
unnamed: Q19.3 (C), Q20.3 (C), R26.2
unnamed: Q20.1 (B), R20.1
unnamed: Q21.1 (G), R27.1
OLED_SPI_CS: R1.2; also elsewhere on the board
OLED_SPI_DC: R27.2, R28.2; also elsewhere on the board
Q1N: R2.2; also elsewhere on the board
Q2P: R3.2; also elsewhere on the board
Q3N: R6.2; also elsewhere on the board
Q3P: R5.2; also elsewhere on the board
Q4N: R8.2; also elsewhere on the board
Q4P: R7.2; also elsewhere on the board
Q5N: R10.2; also elsewhere on the board
Q5P: R9.2; also elsewhere on the board
Q6N: R12.2; also elsewhere on the board
Q6P: R11.2; also elsewhere on the board
Q7N: R14.2; also elsewhere on the board
Q7P: R13.2; also elsewhere on the board
Q8N: R16.2; also elsewhere on the board
Q8P: R15.2; also elsewhere on the board
Q9N: R18.2; also elsewhere on the board
Q9P: R17.2; also elsewhere on the board
Q10N: R20.2; also elsewhere on the board
Q10P: R19.2; also elsewhere on the board
RR0_MON: Q17.3 (C), Q18.3 (C), R25.2; also elsewhere on the board
SENSE2: J1.9; also elsewhere on the board
TC0_MON: Q5.3 (C), Q6.3 (C), R21.1; also elsewhere on the board
TEENSY_VUSB: J2.20; also elsewhere on the board
XB1: D1.1, D2.2, J2.8
XB2: D3.2, D4.1, J2.9
XB3: D3.1, D4.2, J2.10
XB4: D5.2, D6.1, J2.11
XB5: D5.1, D6.2, J2.12
XB6: D7.2, D8.1, J2.13
XB7: D7.1, D8.2, J2.14
XT0,4: J2.6, R21.2
XT1,5: J2.5, R22.1
XT2,6: J2.4, R23.1
XT3,7: J2.3, R24.1
YL1: D9.2, D10.1, J1.4
YL2: D11.1, D12.2, J1.5
YL3: D11.2, D12.1, J1.6
YL4: J1.7, R25.1
YL5: J1.8, R26.1

Notes on the sheet:
COL 0,4
COL 1,5
COL 2,6
COL 3,7
COL 0
COL 1
COL 2
COL 3
COL 4
COL 5
COL 6
COL 7
ROW 0,4 ROW 2,6
ROW 1,5 ROW 3,7
ROW 0,4
ROW 3,7
ROW 1,5
ROW 2,6
CORE MEMORY GROUND
CORE MEMORY POWER
CORE MATRIX POWER
CORE MATRIX BOTTOM COLUMN DRIVERS
CORE MATRIX TOP COLUMN DRIVERS
CORE MATRIX ROW DRIVERS
CORE MATRIX WRITE ENABLE
DIGITAL LOGIC GROUND
SYSTEM POWER GROUND
CORE BOARD INTERCONNECTS
Silkscreen: 3V3 ONLY
QxP (PNP) is normally high, low to activate matrix transistor. QxN (NPN) is normally low, high to activate matrix transistor.
N-CHNL FET as low-side switch
Rds(ON)=0.1
Drive Transistor current: 3.3/470=7mA
HALL SWITCHES (PLAN B…)
GND
DNI
Optional: Thru hole radial lead Cap. 2.5mm lead spacing, 6.3mm dia, 12.5mm tall

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
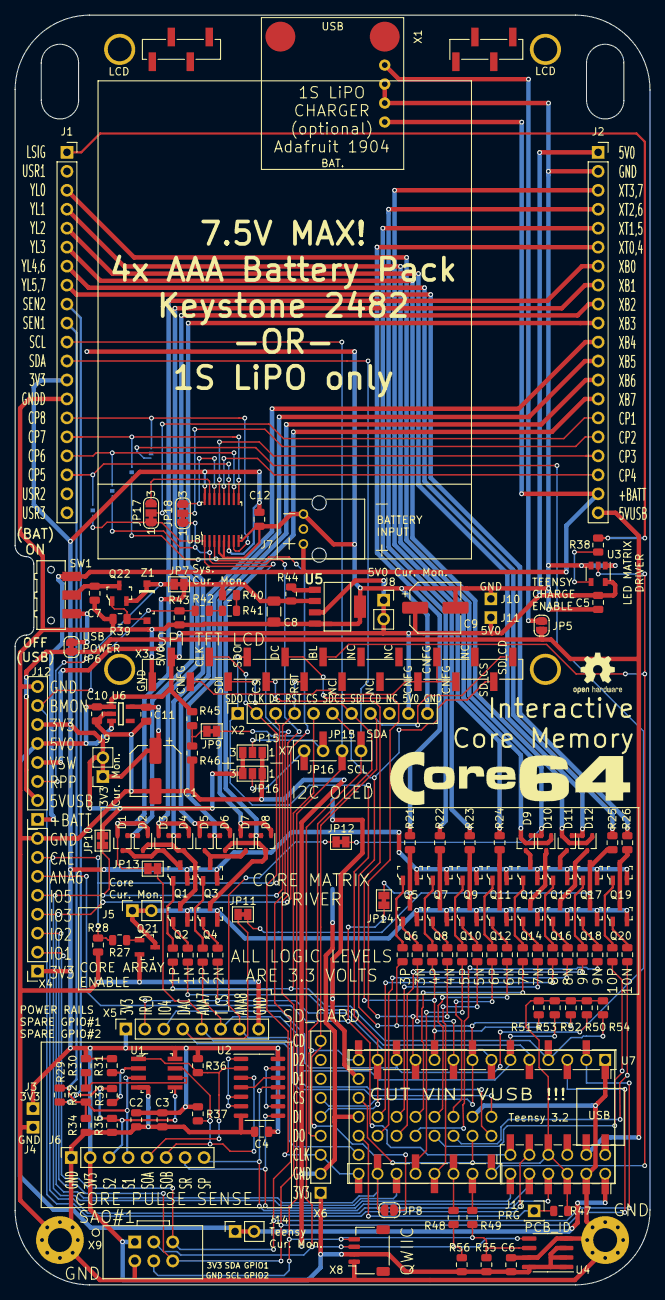
[picture p18: board Core64 LB v0.6.kicad_pcb from above]

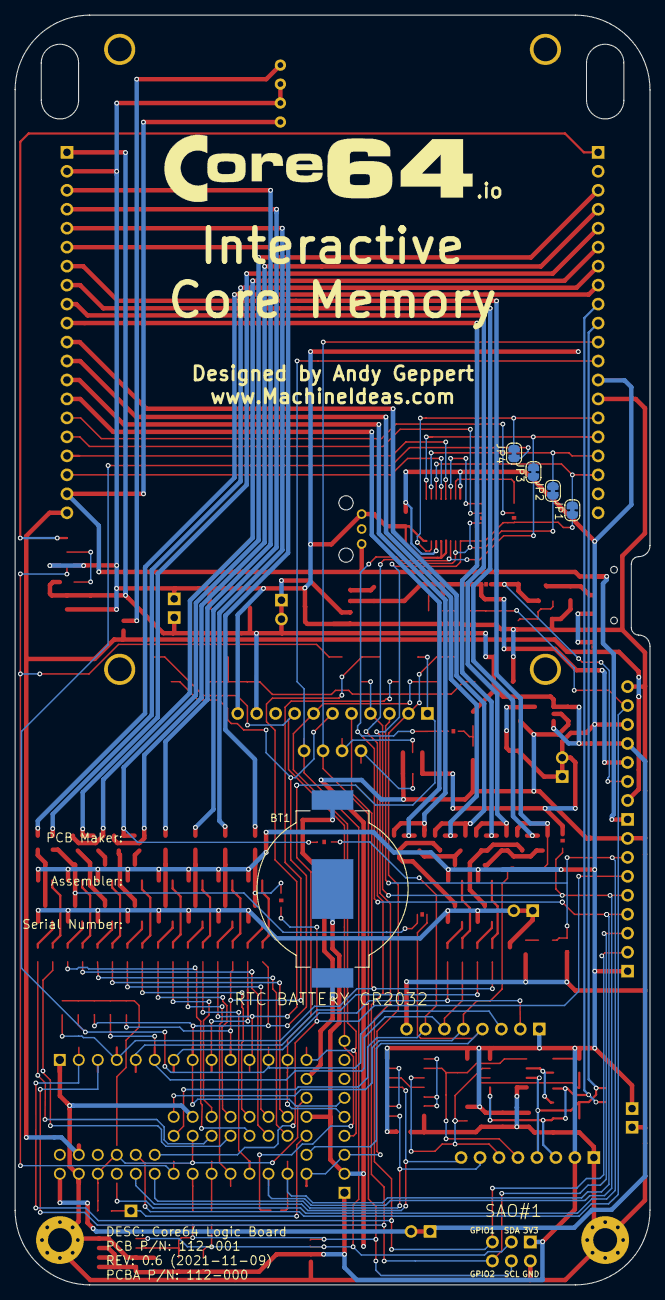
[picture p19: board Core64 LB v0.6.kicad_pcb from below]

Board: 2 copper layers, 85.0 x 170.0 mm, 159 parts (6 on the bottom side), 138 nets.
