ageppert/Core-64-Interactive-Core-Memory-Badge/Electronic Design/Core64 CB v0.4-NP/Core64 CB v0.4-NP.kicad_pcb

## KiCad design Electronic Design/Core64 CB v0.4-NP/Core64 CB v0.4-NP.kicad_pcb (2020-11-26)

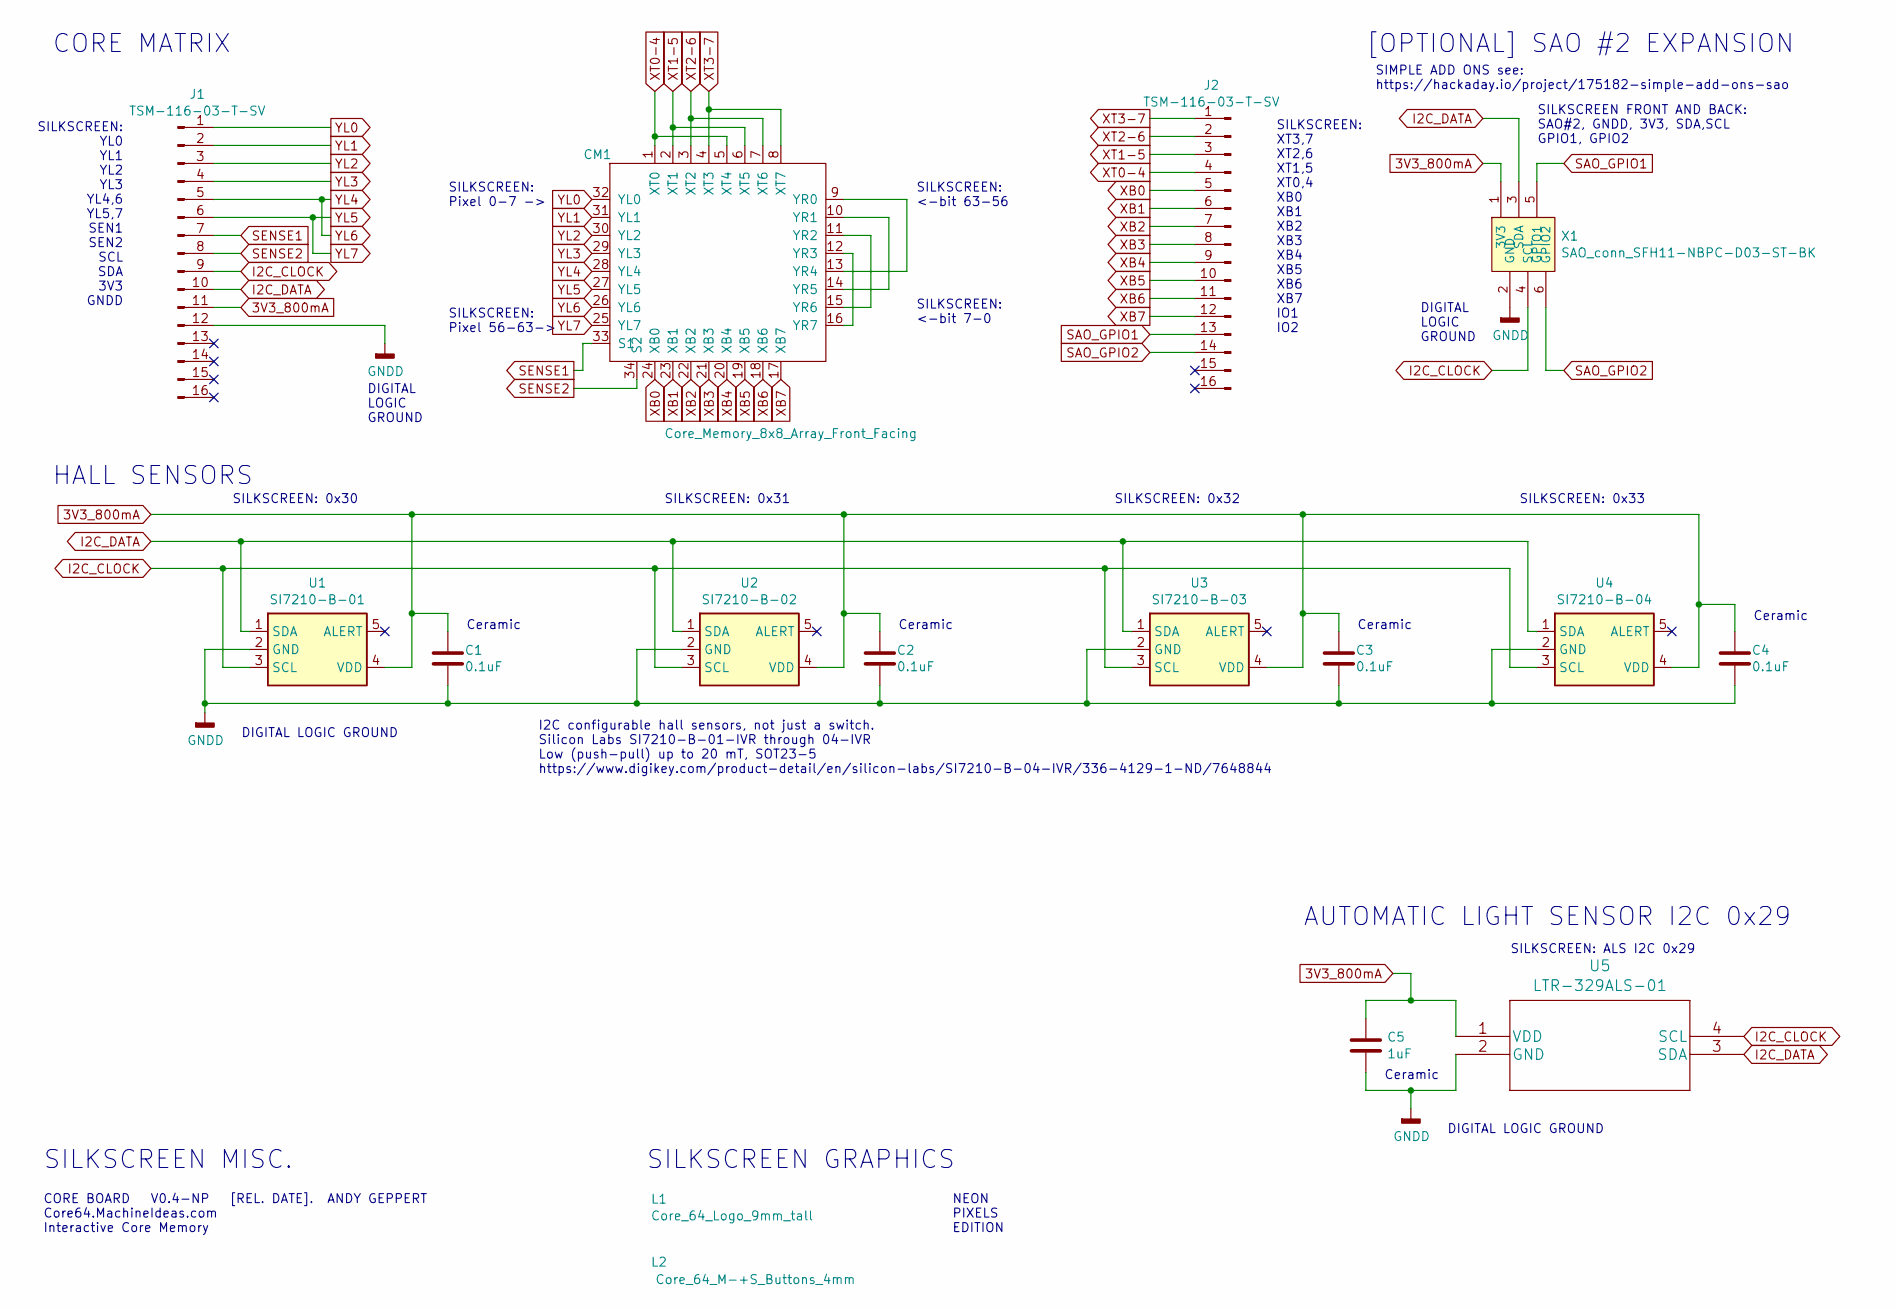
[picture p20: schematic Core64 CB v0.4-NP.sch, Core64 CB (Core Board)]

Parts:
C1, C2, C3, C4: 0.1uF; C_0805_2012Metric
C5: 1uF; C_0805_2012Metric
CM1: Core_Memory_8x8_Array_Front_Facing; core_64_0.3in_spacing_front_facing
J1, J2: TSM-116-03-T-SV‎; PinHeader_1x16_P2.54mm_Vertical
L1: Core_64_Logo_9mm_tall; Core64_Logo_9mm_tall
L2: Core_64_M-+S_Buttons_4mm; Core64-M_-_+_S_Buttons
U1: SI7210-B-01; SOT-23-5
U2: SI7210-B-02; SOT-23-5
U3: SI7210-B-03; SOT-23-5
U4: SI7210-B-04; SOT-23-5
U5: LTR-329ALS-01
X1: SAO_conn_SFH11-NBPC-D03-ST-BK; Badgelife-SAOv169-BADGE-2x3

Connections:
3V3_800mA: C1.1, C2.1, C3.1, C4.1, C5.1, J1.11, U1.4 (VDD), U2.4 (VDD), U3.4 (VDD), U4.4 (VDD), U5.1 (VDD), X1.1 (3V3)
GNDD: C1.2, C2.2, C3.2, C4.2, C5.2, J1.12, U1.2 (GND), U2.2 (GND), U3.2 (GND), U4.2 (GND), U5.2 (GND), X1.2 (GND)
I2C_CLOCK: J1.9, U1.3 (SCL), U2.3 (SCL), U3.3 (SCL), U4.3 (SCL), U5.4 (SCL), X1.4 (SCL)
I2C_DATA: J1.10, U1.1 (SDA), U2.1 (SDA), U3.1 (SDA), U4.1 (SDA), U5.3 (SDA), X1.3 (SDA)
unnamed: CM1.10 (YR1), CM1.14 (YR5)
unnamed: CM1.11 (YR2), CM1.15 (YR6)
unnamed: CM1.12 (YR3), CM1.16 (YR7)
unnamed: CM1.9 (YR0), CM1.13 (YR4)
SAO_GPIO1: J2.13, X1.5 (GPIO1)
SAO_GPIO2: J2.14, X1.6 (GPIO2)
SENSE1: CM1.33 (S1), J1.7
SENSE2: CM1.34 (S2), J1.8
XB0: CM1.24 (XB0), J2.5
XB1: CM1.23 (XB1), J2.6
XB2: CM1.22 (XB2), J2.7
XB3: CM1.21 (XB3), J2.8
XB4: CM1.20 (XB4), J2.9
XB5: CM1.19 (XB5), J2.10
XB6: CM1.18 (XB6), J2.11
XB7: CM1.17 (XB7), J2.12
XT0-4: CM1.1 (XT0), CM1.5 (XT4), J2.4
XT1-5: CM1.2 (XT1), CM1.6 (XT5), J2.3
XT2-6: CM1.3 (XT2), CM1.7 (XT6), J2.2
XT3-7: CM1.4 (XT3), CM1.8 (XT7), J2.1
YL0: CM1.32 (YL0), J1.1
YL1: CM1.31 (YL1), J1.2
YL2: CM1.30 (YL2), J1.3
YL3: CM1.29 (YL3), J1.4
YL4: CM1.26 (YL6), CM1.28 (YL4), J1.5
YL5: CM1.25 (YL7), CM1.27 (YL5), J1.6

Notes on the sheet:
SILKSCREEN: YL0 YL1 YL2 YL3 YL4,6 YL5,7 SEN1 SEN2 SCL SDA 3V3 GNDD
SILKSCREEN: XT3,7 XT2,6 XT1,5 XT0,4 XB0 XB1 XB2 XB3 XB4 XB5 XB6 XB7 IO1 IO2
DIGITAL LOGIC GROUND
I2C configurable hall sensors, not just a switch. Silicon Labs SI7210-B-01-IVR through 04-IVR Low (push-pull) up to 20 mT, SOT23-5 https://www.digikey.com/product-detail/en/silicon-labs/SI7210-B-04-IVR/336-4129-1-ND/7648844
DIGITAL LOGIC GROUND
SILKSCREEN: ALS I2C 0x29
SILKSCREEN FRONT AND BACK: SAO#2, GNDD, 3V3, SDA,SCL GPIO1, GPIO2
AUTOMATIC LIGHT SENSOR I2C 0x29
SILKSCREEN GRAPHICS
HALL SENSORS
CORE MATRIX
[OPTIONAL] SAO #2 EXPANSION
SILKSCREEN: 0x30
SILKSCREEN: 0x31
SILKSCREEN: 0x32
SILKSCREEN: 0x33
Ceramic
SILKSCREEN: Pixel 0-7 ->
SILKSCREEN: <-bit 63-56
SILKSCREEN: <-bit 7-0
SILKSCREEN: Pixel 56-63->
CORE BOARD V0.4-NP [REL. DATE]. ANDY GEPPERT Core64.MachineIdeas.com Interactive Core Memory
SILKSCREEN MISC.
NEON PIXELS EDITION
SIMPLE ADD ONS see: https://hackaday.io/project/175182-simple-add-ons-sao

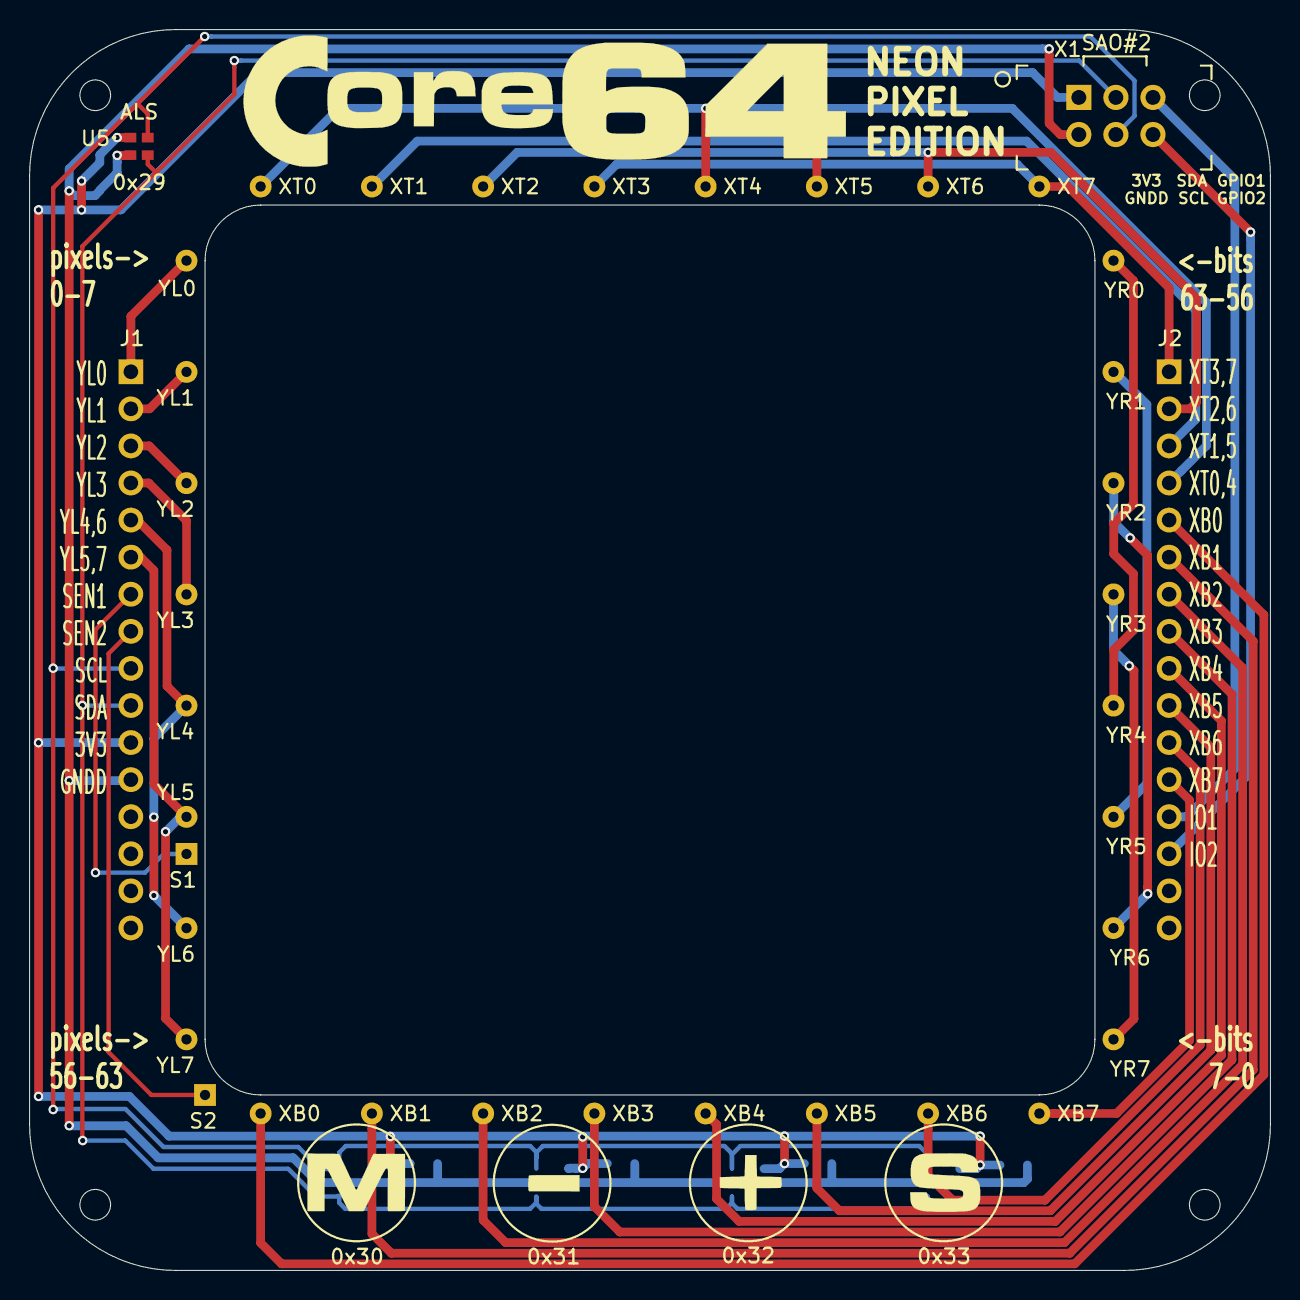
[picture p21: board Core64 CB v0.4-NP.kicad_pcb from above]

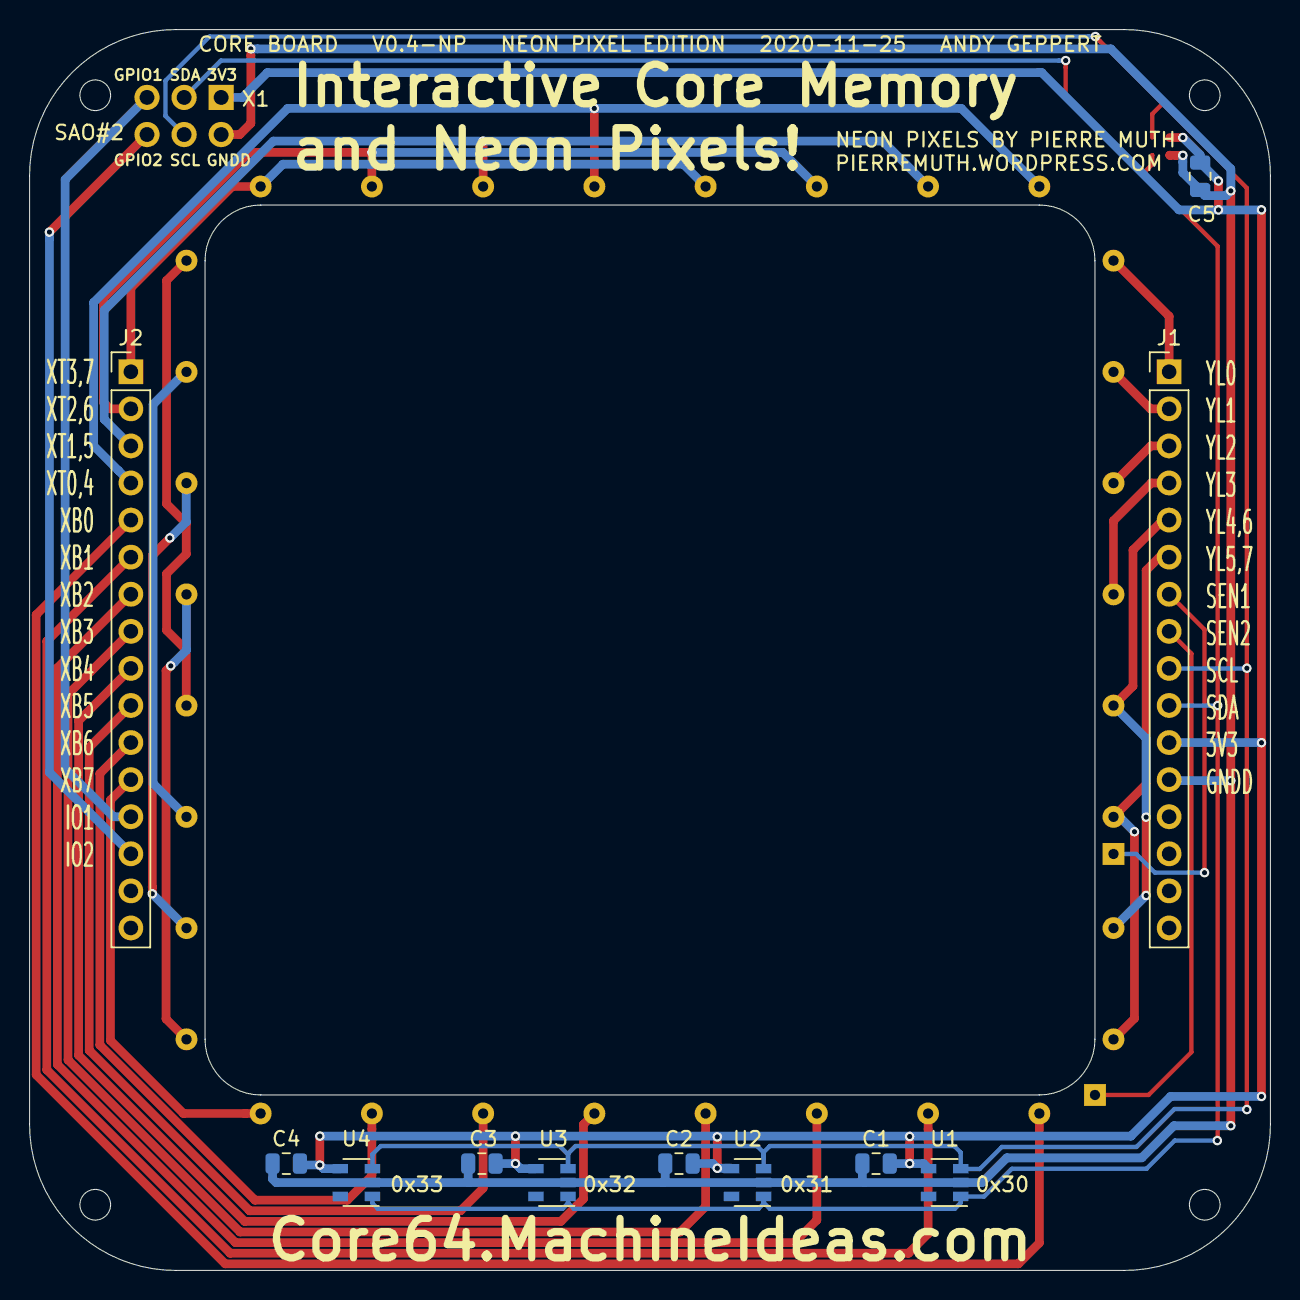
[picture p22: board Core64 CB v0.4-NP.kicad_pcb from below]

Board: 2 copper layers, 85.0 x 85.0 mm, 16 parts (11 on the bottom side), 30 nets.
