ageppert/Core-64-Interactive-Core-Memory-Badge/Electronic Design/Core64 LB v0.4/Core64 CB v0.4.kicad_pcb

## KiCad design Electronic Design/Core64 LB v0.4/Core64 CB v0.4.kicad_pcb (2020-05-19, an earlier design)

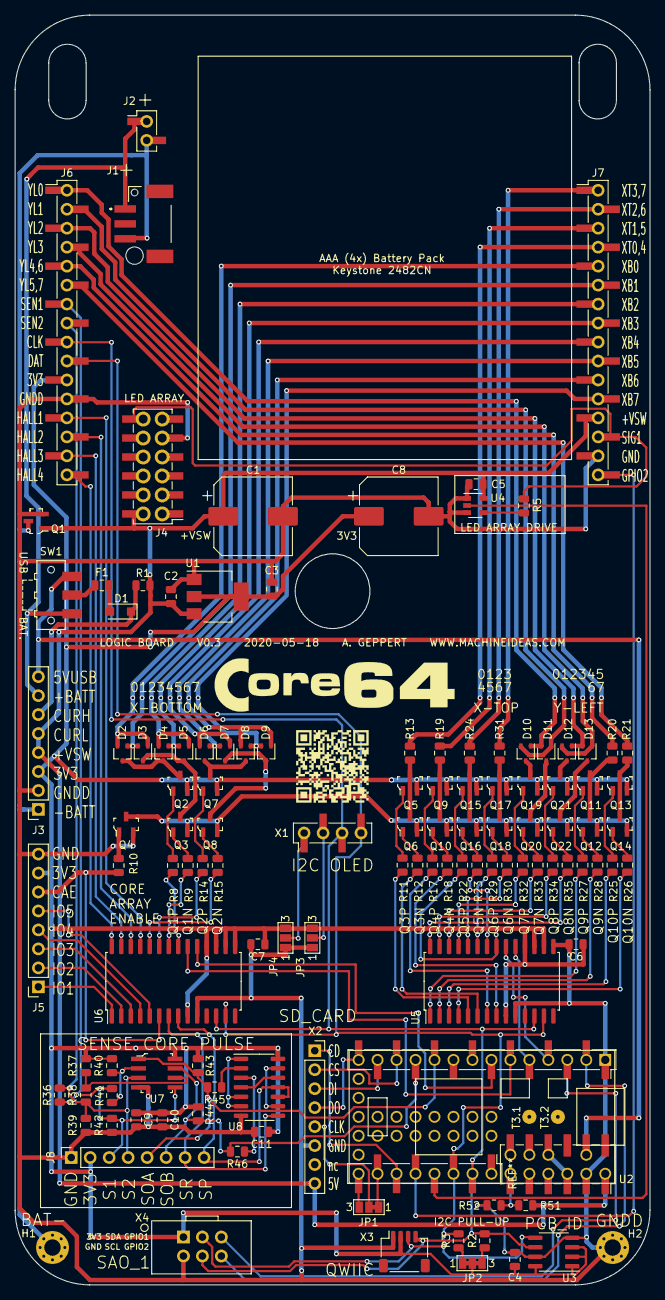
[picture p23: board Core64 CB v0.4.kicad_pcb from above]

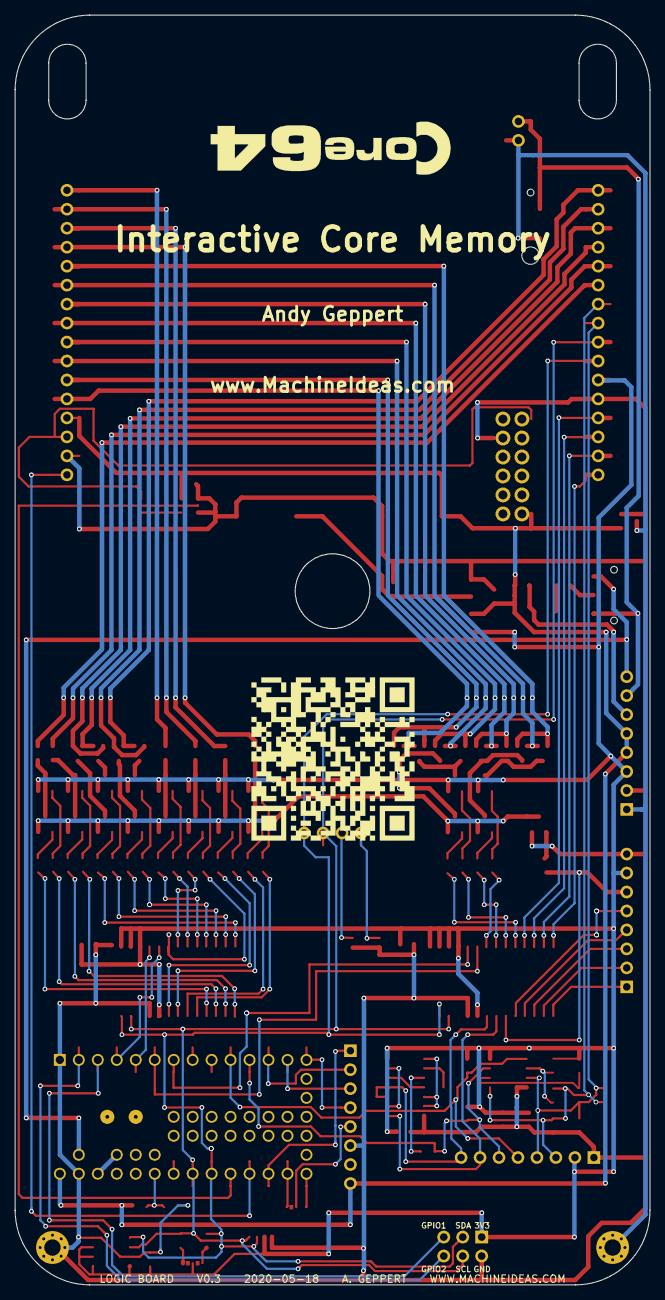
[picture p24: board Core64 CB v0.4.kicad_pcb from below]

Board: 2 copper layers, 85.0 x 170.0 mm, 122 parts (2 on the bottom side), 131 nets.

Parts:
C1, C8: 1000uF; CP_Elec_10x10
C2, C4, C5, C6, C7, C9, C11: 0.1uF; C_0805_2012Metric
C3, C10: 10uF; C_0805_2012Metric
D1: MBR120; D_SOD-123F
D2, D4, D6, D8, D10, D12: BAT54AW; SOT-323_SC-70
D3, D5, D7, D9, D11, D13: BAT54CW; SOT-323_SC-70
F1: Polyfuse; Fuse_0805_2012Metric
H1: -BATT PAD; MountingHole_2.2mm_M2_Pad_Via
H2: GND PAD; MountingHole_2.2mm_M2_Pad_Via
J1: BM03B-PASS-1-TFT__LF__SN_; BM03BPASS1TFTLFSN
J2: Conn_01x02_Male; PinSocket_1x02_P2.54mm_Vertical_SMD_Pin1Left
J3, J5, J8: Conn_01x08_Female; PinSocket_1x08_P2.54mm_Vertical
J4: TSM-106-03-T-DV‎; PinHeader_2x06_P2.54mm_Vertical_SMD_and_TH
J6, J7: SSW-116-22-F-S-VS‎; PinHeader_1x16_P2.54mm_Vertical_SMD_and_TH_Pin1Left
JP1: SolderJumper_3_Bridged12; SolderJumper-3_P1.3mm_Bridged12_Pad1.0x1.5mm_NumberLabels
JP2: SolderJumper_3_Bridged123; SolderJumper-3_P1.3mm_Bridged123_Pad1.0x1.5mm_NumberLabels
JP3, JP4: SolderJumper_3_Open; SolderJumper-3_P1.3mm_Open_Pad1.0x1.5mm_NumberLabels
L1, L2: Core_64_Logo; Core64_Logo
L3: Core_64_Github_Link; Github_Link_Large
L4: Core_64_Github_Link; Github_Link_Small
Q1: IRLML6344TRPBF; SOT-23-3
Q2, Q5, Q7, Q9, Q11, Q13, Q15, Q17, Q19, Q21: MMBT4403LT1G; SOT-23-3
Q3, Q4, Q6, Q8, Q10, Q12, Q14, Q16, Q18, Q20, Q22: MMBT4401LT1G; SOT-23-3
R1: 0.001; R_0805_2012Metric
R2, R3: 4K7; R_0805_2012Metric
R5: 300; R_0805_2012Metric
R8, R9, R10, R11, R12, R14, R15, R17, R18, R22, R23, R25, R26, R27, R28, R29, R30, R32, R33, R34, R35: 470; R_0805_2012Metric
R13, R19, R20, R21, R24, R31: 6R8; R_0805_2012Metric
R36, R39, R42: 1K5; R_0805_2012Metric
R37, R40: 1K8; R_0805_2012Metric
R38, R41: 11; R_0805_2012Metric
R43, R44, R45, R46, R51, R52: 10k; R_0805_2012Metric
SW1: JS102011SAQN; SW_SPDT_CK-JS102011SAQN
U1: LD1117S33TR_SOT223; SOT-223-3_TabPin2
U2: Teensy-LC; Teensy30_31_32_LC_SMD_SOCKETS
U3: M24C01-RMN; SOIC-8_3.9x4.9mm_P1.27mm
U4: SN74LV1T125DBVR; SOT-23-5
U5, U6: MCP23017_SO; SOIC-28W_7.5x17.9mm_P1.27mm
U7: LM393; SOIC-8_W3.9mm
U8: 74HC02; SOIC-14_3.9x8.7mm_P1.27mm
X1: SSW-104-22-L-S-VS; PinSocket_1x04_P2.54mm_Vertical_SMD_and_TH_Pin1Left
X2: Conn_01x08_Female; PinSocket_1x08_P2.54mm_Vertical
X3: Conn_01x04_Male; JST_SH_SM04B-SRSS-TB_1x04-1MP_P1.00mm_Horizontal
X4: SAO_conn_SFH11-NBPC-D03-ST-BK; Badgelife-SAOv169-BADGE-2x3

Connections:
3V3_800mA: C3.1, C4.1, C6.1, C7.1, C8.1, C9.1, C10.1, C11.1, J3.3, J5.7, J6.11, J8.2, JP2.2, JP3.3, JP4.3, Q2.2, Q5.2, Q7.2, Q9.2, Q11.2, Q13.2, Q15.2, Q17.2, Q19.2, Q21.2, R37.1, R40.1, R43.1, R44.1, U1.2, U3.1, U3.2, U3.3, U3.8, U5.9, U5.16, U5.17, U5.18, U6.9, U6.15, U6.16, U6.17, U6.18, U7.8, U8.14, X3.2, X4.1
5V_USB: J3.8, SW1.1, U2.34
+BATT: J1.1, J2.1, J3.7, SW1.3
+VSW: C1.1, C2.1, C5.1, J3.4, J3.5, J4.2, J7.13, Q1.1, R1.2, R51.1, U1.3, U2.33, U4.5, X2.8
-BATT: H1.1, J1.3, J2.2, J3.1, Q1.3
CUR_HI: D1.1, J3.6, R1.1
GNDPWR: Q3.2, Q4.3, Q6.2, Q8.2, Q10.2, Q12.2, Q14.2, Q16.2, Q18.2, Q20.2, Q22.2
HALL_SWITCH_1: J6.13, U6.25
HALL_SWITCH_2: J6.14, U6.26
HALL_SWITCH_3: J6.15, U6.27
HALL_SWITCH_4: J6.16, U6.28
I2C_CLOCK: J6.9, R2.2, U2.26, U3.6, U5.12, U6.12, X1.3, X3.4, X4.4
I2C_DATA: J6.10, R3.2, U2.25, U3.5, U5.13, U6.13, X1.4, X3.3, X4.3
IOEXP_ID32_INT_A: U2.4, U5.20
IOEXP_ID32_INT_B: U2.5, U5.19
IOEXP_ID33_INT_A: U2.6, U6.20
IOEXP_ID33_INT_B: U2.7, U6.19
LED_MATRIX_3V3_SIG: U2.24, U4.2
LED_MATRIX_+VSW_SIG: J4.12, J7.14, R5.2
unnamed: D1.2, F1.1
unnamed: D2.3, D4.3, Q2.3
unnamed: D3.3, D5.3, Q3.3
unnamed: D6.3, D8.3, Q7.3
unnamed: D7.3, D9.3, Q8.3
unnamed: D10.3, Q19.3
unnamed: D11.3, Q20.3
unnamed: D12.3, Q21.3
unnamed: D13.3, Q22.3
unnamed: F1.2, SW1.2
unnamed: JP1.1, U2.21
unnamed: JP1.3, U2.20
unnamed: JP2.1, R3.1
unnamed: JP2.3, R2.1
unnamed: JP3.2, X1.2
unnamed: JP4.2, X1.1
unnamed: Q2.1, R8.1
unnamed: Q3.1, R9.1
unnamed: Q4.1, R10.1
unnamed: Q5.1, R11.1
unnamed: Q5.3, Q6.3, R13.1
unnamed: Q6.1, R12.1
unnamed: Q7.1, R14.1
unnamed: Q8.1, R15.1
unnamed: Q9.1, R17.1
unnamed: Q10.1, R18.1
unnamed: Q9.3, Q10.3, R19.2
unnamed: Q11.1, R27.1
unnamed: Q11.3, Q12.3, R20.2
unnamed: Q12.1, R28.1
unnamed: Q13.1, R25.1
unnamed: Q13.3, Q14.3, R21.2
unnamed: Q14.1, R26.1
unnamed: Q15.1, R22.1
unnamed: Q15.3, Q16.3, R24.2
unnamed: Q16.1, R23.1
unnamed: Q17.1, R29.1
unnamed: Q17.3, Q18.3, R31.2
unnamed: Q18.1, R30.1
unnamed: Q19.1, R32.1
unnamed: Q20.1, R33.1
unnamed: Q21.1, R34.1
unnamed: Q22.1, R35.1
unnamed: R5.1, U4.4
unnamed: R37.2, R38.1, U7.6
unnamed: R40.2, R41.1, U7.2
unnamed: R45.1, U8.2
unnamed: R46.1, U8.3
unnamed: U8.1, U8.5, U8.6
unnamed: U8.4, U8.12
unnamed: U8.9, U8.13
Q1N: R9.2, U6.22
Q1P: R8.2, U6.21
Q2N: R15.2, U6.24
Q2P: R14.2, U6.23
Q3N: R12.2, U5.6
Q3P: R11.2, U5.5
Q4N: R18.2, U5.8
Q4P: R17.2, U5.7
Q5N: R23.2, U5.22
Q5P: R22.2, U5.21
Q6N: R30.2, U5.24
Q6P: R29.2, U5.23
Q7N: R33.2, U5.26
Q7P: R32.2, U5.25
Q8N: R35.2, U5.28
Q8P: R34.2, U5.27
Q9N: R28.2, U5.2
Q9P: R27.2, U5.1
Q10N: R26.2, U5.4
Q10P: R25.2, U5.3
SAO1_GPIO1(TX): U2.3, X4.5
SAO1_GPIO2(RX): U2.2, X4.6
SAO3_GPIO2: J7.16, U2.23
SD_CD: U2.22, X2.1
SD_CLK: JP1.2, X2.5
SD_CS: U2.12, X2.2
SD_DI: U2.13, X2.3
SD_DO: U2.14, X2.4
SENSE1: J6.7, J8.3, R36.1, R41.2, R42.1, U7.5
SENSE2: J6.8, J8.4, R36.2, R38.2, R39.1, U7.3
SENSE_OUT_A: J8.5, R43.2, R45.2, U2.10, U7.1
SENSE_OUT_B: J8.6, R44.2, R46.2, U2.11, U7.7
SENSE_PULSE: J8.8, U6.8, U8.10, U8.11
SENSE_RESET: J8.7, U6.7, U8.8
SPARE_1: J5.1, U6.1
SPARE_2: J5.2, U6.2
SPARE_3: J5.3, U6.3
SPARE_4: J5.4, U6.4
SPARE_5: J5.5, U6.5
TEENSY_3V3: U2.31, U2.35
TEENSY_GND: C1.2, C2.2, C3.2, C4.2, C5.2, C6.2, C7.2, C8.2, C9.2, C10.2, C11.2, H2.1, J3.2, J4.9, J5.8, J6.12, J7.15, J8.1, JP3.1, JP4.1, Q1.2, Q4.2, R39.2, R42.2, R52.2, U1.1, U2.1, U2.32, U3.4, U3.7, U4.1, U4.3, U5.10, U5.15, U6.10, U7.4, U8.7, X2.6, X3.1, X4.2
VSW_HALF_VOL_MONITOR: R51.2, R52.1, U2.28
WRITE_ENABLE: J5.6, R10.2, U6.6
XB0: D2.2, D3.1, J7.5
XB1: D2.1, D3.2, J7.6
XB2: D4.2, D5.1, J7.7
XB3: D4.1, D5.2, J7.8
XB4: D6.2, D7.1, J7.9
XB5: D6.1, D7.2, J7.10
XB6: D8.2, D9.1, J7.11
XB7: D8.1, D9.2, J7.12
XT0-4: J7.4, R13.2
XT1-5: J7.3, R19.1
XT2-6: J7.2, R24.1
XT3-7: J7.1, R31.1
YL0: D10.1, D11.2, J6.1
YL1: D10.2, D11.1, J6.2
YL2: D12.1, D13.2, J6.3
YL3: D12.2, D13.1, J6.4
YL4: J6.5, R20.1
YL5: J6.6, R21.1
