ageppert/Core-64-Interactive-Core-Memory-Badge/Electronic Design/Interactive Core Memory Badge v0.2/Interactive Core Memory Badge v0.2.kicad_pcb

## KiCad design Electronic Design/Interactive Core Memory Badge v0.2/Interactive Core Memory Badge v0.2.kicad_pcb (2020-03-19, an earlier design)

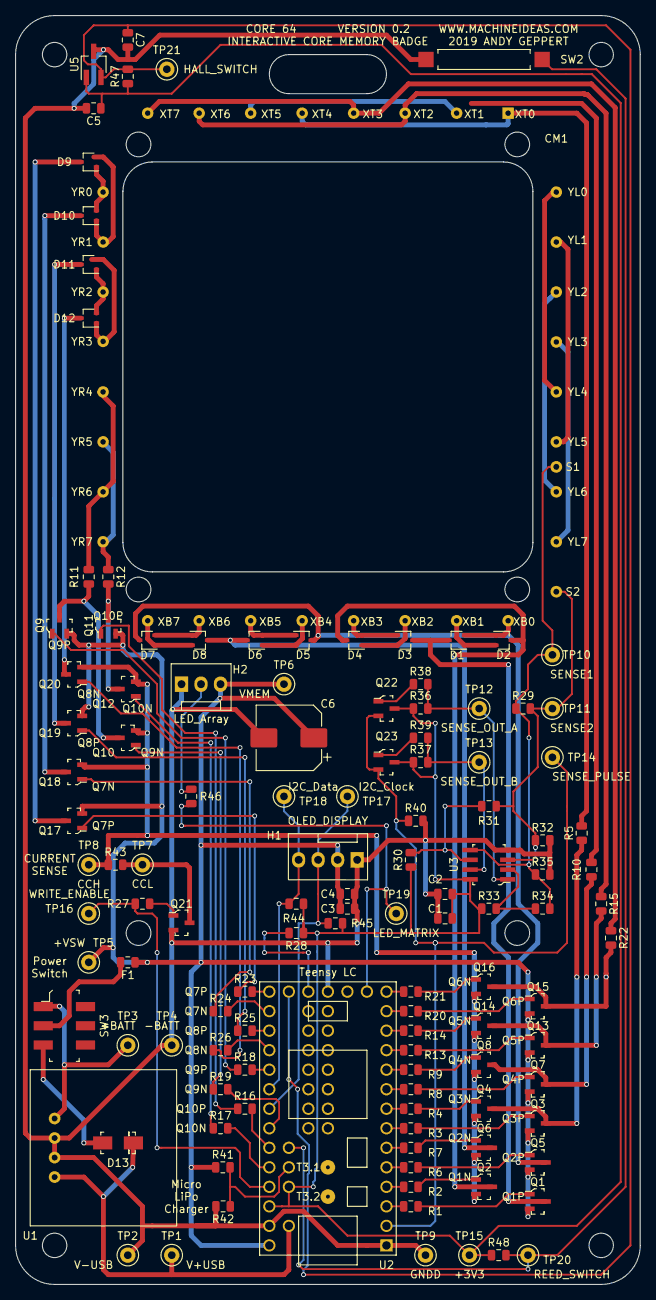
[picture p25: board Interactive Core Memory Badge v0.2.kicad_pcb from above]

Board: 2 copper layers, 81.3 x 165.1 mm, 122 parts (0 on the bottom side), 104 nets.

Parts:
C1, C3, C5: 0.1uF; C_0805_2012Metric
C2, C4: 10uF; C_0805_2012Metric
C6: 1000uF; CP_Elec_8x10
C7: 10pF; C_0805_2012Metric
CM1: Core_Memory_8x8_Array; core_64_x6.7_y6.5mm
D1, D3, D5, D7, D9, D11: BAT54AW; SOT-323_SC-70
D2, D4, D6, D8, D10, D12: BAT54CW; SOT-323_SC-70
D13: S1M-13-F; DO-214AC
F1: Polyfuse; Fuse_0805_2012Metric
H1: OLED_DISPLAY; OLED_Header_4PIN
H2: LED_Array; LED_Matrix_Header_3pin
Q1, Q3, Q5, Q7, Q9, Q11, Q13, Q15, Q17, Q19: MMBT4403LT1G; SOT-23-3
Q2, Q4, Q6, Q8, Q10, Q12, Q14, Q16, Q18, Q20, Q21, Q22, Q23: MMBT4401LT1G; SOT-23-3
R1, R2, R3, R4, R6, R7, R8, R9, R13, R14, R16, R17, R18, R19, R20, R21, R23, R24, R25, R26, R27: 470; R_0805_2012Metric
R5, R10, R11, R12, R15, R22: 6R8; R_0805_2012Metric
R28, R44, R45, R47, R48: 4K7; R_0805_2012Metric
R29, R32, R35: 1K5; R_0805_2012Metric
R30, R33: 1K8; R_0805_2012Metric
R31, R34: 11; R_0805_2012Metric
R36, R37, R38, R39, R40, R41, R42: 10k; R_0805_2012Metric
R43: 0.01; R_0805_2012Metric
R46: 300; R_0805_2012Metric
SW2: SW_Reed; SW_SPST_REED_CT10-XXXX-G1
SW3: SW_DPDT_x2; Switch_Slide_JS202011SCQN
TP1: V+USB; TestPoint_Keystone_5000-5004_Miniature
TP2: V-USB; TestPoint_Keystone_5000-5004_Miniature
TP3: +BATT; TestPoint_Keystone_5000-5004_Miniature
TP4: -BATT; TestPoint_Keystone_5000-5004_Miniature
TP5: +VSW; TestPoint_Keystone_5000-5004_Miniature
TP6: VMEM; TestPoint_Keystone_5000-5004_Miniature
TP7: CCL; TestPoint_Keystone_5000-5004_Miniature
TP8: CCH; TestPoint_Keystone_5000-5004_Miniature
TP9: GNDD; TestPoint_Keystone_5000-5004_Miniature
TP10: SENSE1; TestPoint_Keystone_5000-5004_Miniature
TP11: SENSE2; TestPoint_Keystone_5000-5004_Miniature
TP12: SENSE_OUT_A; TestPoint_Keystone_5000-5004_Miniature
TP13: SENSE_OUT_B; TestPoint_Keystone_5000-5004_Miniature
TP14: SENSE_PULSE; TestPoint_Keystone_5000-5004_Miniature
TP15: +3V3; TestPoint_Keystone_5000-5004_Miniature
TP16: WRITE_ENABLE; TestPoint_Keystone_5000-5004_Miniature
TP17: I2C_Clock; TestPoint_Keystone_5000-5004_Miniature
TP18: I2C_Data; TestPoint_Keystone_5000-5004_Miniature
TP19: LED_MATRIX; TestPoint_Keystone_5000-5004_Miniature
TP20: REED_SWITCH; TestPoint_Keystone_5000-5004_Miniature
TP21: HALL_SWITCH; TestPoint_Keystone_5000-5004_Miniature
U1: Micro_LiPo_Charger
U2: Teensy-LC; Teensy30_31_32_LC
U3: LM393; SOIC-8_W3.9mm
U5: A3214ELHLT-T; SOT-23W_Handsoldering

Connections:
+3V3: C1.1, C2.1, C5.1, Q22.3, Q23.3, R28.1, R30.1, R33.1, R36.1, R37.1, R44.1, R45.1, R47.1, R48.1, TP15.1, U2.31, U2.35, U3.8, U5.1
+BATT: SW3.1, TP3.1, U1.4
+VSW: C3.1, C4.1, C6.1, F1.1, H1.2, H2.3, Q1.2, Q3.2, Q5.2, Q7.2, Q9.2, Q11.2, Q13.2, Q15.2, Q17.2, Q19.2, R41.1, TP5.1, TP6.1, U2.33
-BATT: C1.2, C2.2, C3.2, C4.2, C5.2, C6.2, C7.2, H1.1, H2.1, Q21.2, R32.2, R35.2, R40.2, R42.2, SW2.1, TP2.1, TP4.1, TP9.1, U1.2, U1.3, U2.1, U2.17, U2.32, U3.4, U5.3
GNDPWR: Q2.2, Q4.2, Q6.2, Q8.2, Q10.2, Q12.2, Q14.2, Q16.2, Q18.2, Q20.2, R43.1, TP8.1
HALL_SWITCH: C7.1, R47.2, TP21.1, U2.19, U5.2
I2C_CLOCK: H1.3, R45.2, TP17.1, U2.26
I2C_DATA: H1.4, R44.2, TP18.1, U2.25
LED_MATRIX: R46.1, TP19.1, U2.15
unnamed: CM1.25, CM1.29
unnamed: CM1.26, CM1.30
unnamed: CM1.27, CM1.31
unnamed: CM1.28, CM1.32
unnamed: D1.3, D3.3, Q1.3
unnamed: D2.3, D4.3, Q2.3
unnamed: D5.3, D7.3, Q5.3
unnamed: D6.3, D8.3, Q6.3
unnamed: D9.3, Q17.3
unnamed: D10.3, Q18.3
unnamed: D11.3, Q19.3
unnamed: D12.3, Q20.3
unnamed: D13.1, SW3.3
unnamed: F1.2, SW3.2
unnamed: H2.2, R46.2
unnamed: Q1.1, R1.1
unnamed: Q2.1, R2.1
unnamed: Q3.1, R3.1
unnamed: Q3.3, Q4.3, R5.1
unnamed: Q4.1, R4.1
unnamed: Q5.1, R6.1
unnamed: Q6.1, R7.1
unnamed: Q7.1, R8.1
unnamed: Q7.3, Q8.3, R10.2
unnamed: Q8.1, R9.1
unnamed: Q9.1, R18.1
unnamed: Q10.1, R19.1
unnamed: Q9.3, Q10.3, R11.2
unnamed: Q11.1, R16.1
unnamed: Q11.3, Q12.3, R12.2
unnamed: Q12.1, R17.1
unnamed: Q13.1, R13.1
unnamed: Q13.3, Q14.3, R15.2
unnamed: Q14.1, R14.1
unnamed: Q15.1, R20.1
unnamed: Q15.3, Q16.3, R22.2
unnamed: Q16.1, R21.1
unnamed: Q17.1, R23.1
unnamed: Q18.1, R24.1
unnamed: Q19.1, R25.1
unnamed: Q20.1, R26.1
unnamed: Q21.1, R27.1
unnamed: Q21.3, R43.2, TP7.1
unnamed: Q22.1, R38.1
unnamed: Q23.1, R39.1
unnamed: R28.2, U2.18
unnamed: R30.2, R31.1, U3.6
unnamed: R33.2, R34.1, U3.2
unnamed: R36.2, R38.2, TP12.1, U3.1
unnamed: R37.2, R39.2, TP13.1, U3.7
unnamed: R41.2, R42.1, U2.36
Q1N: R2.2, U2.4
Q1P: R1.2, U2.3
Q2N: R7.2, U2.6
Q2P: R6.2, U2.5
Q3N: R4.2, U2.8
Q3P: R3.2, U2.7
Q4N: R9.2, U2.10
Q4P: R8.2, U2.9
Q5N: R14.2, U2.12
Q5P: R13.2, U2.11
Q6N: R21.2, U2.14
Q6P: R20.2, U2.13
Q7N: R24.2, U2.21
Q7P: R23.2, U2.20
Q8N: R26.2, U2.23
Q8P: R25.2, U2.22
Q9N: R19.2, U2.27
Q9P: R18.2, U2.24
Q10N: R17.2, U2.29
Q10P: R16.2, U2.28
REED_SWITCH: R48.2, SW2.2, TP20.1, U2.37
SENSE1: CM1.33, R29.1, R34.2, R35.1, TP10.1, U3.5
SENSE2: CM1.34, R29.2, R31.2, R32.1, TP11.1, U3.3
SENSE_PULSE: Q22.2, Q23.2, R40.1, TP14.1, U2.2
V+USB: D13.2, TP1.1, U1.1, U2.34
WRITE_ENABLE: R27.2, TP16.1, U2.30
XB0: CM1.24, D1.2, D2.1
XB1: CM1.23, D1.1, D2.2
XB2: CM1.22, D3.2, D4.1
XB3: CM1.21, D3.1, D4.2
XB4: CM1.20, D5.2, D6.1
XB5: CM1.19, D5.1, D6.2
XB6: CM1.18, D7.2, D8.1
XB7: CM1.17, D7.1, D8.2
XT0-4: CM1.1, CM1.5, R5.2
XT1-5: CM1.2, CM1.6, R10.1
XT2-6: CM1.3, CM1.7, R15.1
XT3-7: CM1.4, CM1.8, R22.1
YL0: CM1.9, D9.1, D10.2
YL1: CM1.10, D9.2, D10.1
YL2: CM1.11, D11.1, D12.2
YL3: CM1.12, D11.2, D12.1
YL4: CM1.13, CM1.15, R11.1
YL5: CM1.14, CM1.16, R12.1
