ageppert/Core-64-Interactive-Core-Memory-Badge/Electronic Design/Neon PIxels/Neon Pixels Backplane Grid.kicad_pcb

## KiCad design Electronic Design/Neon PIxels/Neon Pixels Backplane Grid.kicad_pcb (2020-11-24)

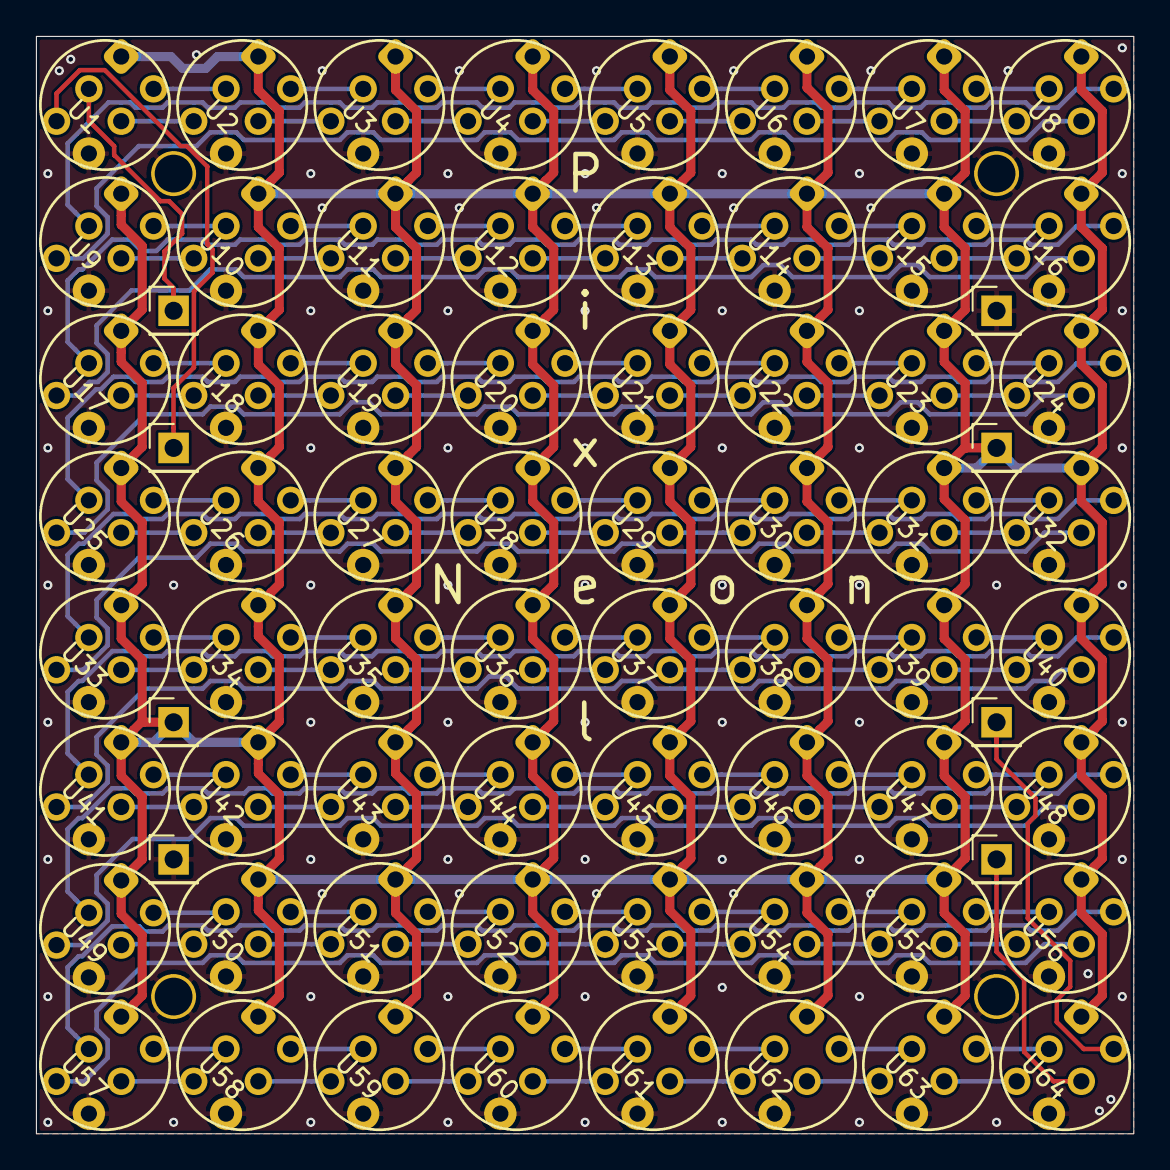
[picture p26: board Neon Pixels Backplane Grid.kicad_pcb from above]

Board: 2 copper layers, 61.0 x 61.0 mm, 76 parts (0 on the bottom side), 132 nets.

Parts:
H3, H4, H5, H6: MountingHole_Pad; mountingM2
J1, J2, J3, J4: Conn_01x01_Female; Pin_Header_Straight_1x01_Pitch2.54mm
J5, J6, J7, J8: Conn_01x01_Male; Pin_Header_Straight_1x01_Pitch2.54mm
U1, U2, U3, U4, U5, U6, U7, U8, U9, U10, U11, U12, U13, U14, U15, U16, U17, U18, U19, U20, U21, U22, U23, U24, U25, U26, U27, U28, U29, U30, U31, U32, U33, U34, U35, U36, U37, U38, U39, U40, U41, U42, U43, U44, U45, U46, U47, U48, U49, U50, U51, U52, U53, U54, U55, U56, U57, U58, U59, U60, U61, U62, U63, U64: neonpixel

Connections:
Cin: J6.1, U1.2
Cout: J2.1, U64.6
Din: J7.1, U1.3
Dout: J3.1, U64.5
GND: H3.1, H4.1, H5.1, H6.1, J4.1, J8.1, U1.4, U2.4, U3.4, U4.4, U5.4, U6.4, U7.4, U8.4, U9.4, U10.4, U11.4, U12.4, U13.4, U14.4, U15.4, U16.4, U17.4, U18.4, U19.4, U20.4, U21.4, U22.4, U23.4, U24.4, U25.4, U26.4, U27.4, U28.4, U29.4, U30.4, U31.4, U32.4, U33.4, U34.4, U35.4, U36.4, U37.4, U38.4, U39.4, U40.4, U41.4, U42.4, U43.4, U44.4, U45.4, U46.4, U47.4, U48.4, U49.4, U50.4, U51.4, U52.4, U53.4, U54.4, U55.4, U56.4, U57.4, U58.4, U59.4, U60.4, U61.4, U62.4, U63.4, U64.4
unnamed: U1.5, U2.3
unnamed: U1.6, U2.2
unnamed: U2.5, U3.3
unnamed: U2.6, U3.2
unnamed: U3.5, U4.3
unnamed: U3.6, U4.2
unnamed: U4.5, U5.3
unnamed: U4.6, U5.2
unnamed: U5.5, U6.3
unnamed: U5.6, U6.2
unnamed: U6.5, U7.3
unnamed: U6.6, U7.2
unnamed: U7.5, U8.3
unnamed: U7.6, U8.2
unnamed: U8.5, U9.3
unnamed: U8.6, U9.2
unnamed: U9.6, U10.2
unnamed: U9.5, U10.3
unnamed: U10.5, U11.3
unnamed: U10.6, U11.2
unnamed: U11.5, U12.3
unnamed: U11.6, U12.2
unnamed: U12.5, U13.3
unnamed: U12.6, U13.2
unnamed: U13.5, U14.3
unnamed: U13.6, U14.2
unnamed: U14.5, U15.3
unnamed: U14.6, U15.2
unnamed: U15.5, U16.3
unnamed: U15.6, U16.2
unnamed: U16.5, U17.3
unnamed: U16.6, U17.2
unnamed: U17.5, U18.3
unnamed: U17.6, U18.2
unnamed: U18.5, U19.3
unnamed: U18.6, U19.2
unnamed: U19.5, U20.3
unnamed: U19.6, U20.2
unnamed: U20.5, U21.3
unnamed: U20.6, U21.2
unnamed: U21.5, U22.3
unnamed: U21.6, U22.2
unnamed: U22.5, U23.3
unnamed: U22.6, U23.2
unnamed: U23.5, U24.3
unnamed: U23.6, U24.2
unnamed: U24.5, U25.3
unnamed: U24.6, U25.2
unnamed: U25.5, U26.3
unnamed: U25.6, U26.2
unnamed: U26.5, U27.3
unnamed: U26.6, U27.2
unnamed: U27.5, U28.3
unnamed: U27.6, U28.2
unnamed: U28.5, U29.3
unnamed: U28.6, U29.2
unnamed: U29.5, U30.3
unnamed: U29.6, U30.2
unnamed: U30.5, U31.3
unnamed: U30.6, U31.2
unnamed: U31.5, U32.3
unnamed: U31.6, U32.2
unnamed: U32.5, U33.3
unnamed: U32.6, U33.2
unnamed: U33.5, U34.3
unnamed: U33.6, U34.2
unnamed: U34.5, U35.3
unnamed: U34.6, U35.2
unnamed: U35.5, U36.3
unnamed: U35.6, U36.2
unnamed: U36.5, U37.3
unnamed: U36.6, U37.2
unnamed: U37.5, U38.3
unnamed: U37.6, U38.2
unnamed: U38.5, U39.3
unnamed: U38.6, U39.2
unnamed: U39.5, U40.3
unnamed: U39.6, U40.2
unnamed: U40.5, U41.3
unnamed: U40.6, U41.2
unnamed: U41.5, U42.3
unnamed: U41.6, U42.2
unnamed: U42.5, U43.3
unnamed: U42.6, U43.2
unnamed: U43.5, U44.3
unnamed: U43.6, U44.2
unnamed: U44.5, U45.3
unnamed: U44.6, U45.2
unnamed: U45.5, U46.3
unnamed: U45.6, U46.2
unnamed: U46.5, U47.3
unnamed: U46.6, U47.2
unnamed: U47.5, U48.3
unnamed: U47.6, U48.2
unnamed: U48.5, U49.3
unnamed: U48.6, U49.2
unnamed: U49.5, U50.3
unnamed: U49.6, U50.2
unnamed: U50.5, U51.3
unnamed: U50.6, U51.2
unnamed: U51.5, U52.3
unnamed: U51.6, U52.2
unnamed: U52.5, U53.3
unnamed: U52.6, U53.2
unnamed: U53.5, U54.3
unnamed: U53.6, U54.2
unnamed: U54.5, U55.3
unnamed: U54.6, U55.2
unnamed: U55.5, U56.3
unnamed: U55.6, U56.2
unnamed: U56.5, U57.3
unnamed: U56.6, U57.2
unnamed: U57.5, U58.3
unnamed: U57.6, U58.2
unnamed: U58.5, U59.3
unnamed: U58.6, U59.2
unnamed: U59.5, U60.3
unnamed: U59.6, U60.2
unnamed: U60.5, U61.3
unnamed: U60.6, U61.2
unnamed: U61.5, U62.3
unnamed: U61.6, U62.2
unnamed: U62.5, U63.3
unnamed: U62.6, U63.2
unnamed: U63.5, U64.3
unnamed: U63.6, U64.2
VDD: J1.1, J5.1, U1.1, U2.1, U3.1, U4.1, U5.1, U6.1, U7.1, U8.1, U9.1, U10.1, U11.1, U12.1, U13.1, U14.1, U15.1, U16.1, U17.1, U18.1, U19.1, U20.1, U21.1, U22.1, U23.1, U24.1, U25.1, U26.1, U27.1, U28.1, U29.1, U30.1, U31.1, U32.1, U33.1, U34.1, U35.1, U36.1, U37.1, U38.1, U39.1, U40.1, U41.1, U42.1, U43.1, U44.1, U45.1, U46.1, U47.1, U48.1, U49.1, U50.1, U51.1, U52.1, U53.1, U54.1, U55.1, U56.1, U57.1, U58.1, U59.1, U60.1, U61.1, U62.1, U63.1, U64.1
